sevastianamoroso/proyecto-mano/informe/presentacion/presentacion.tex

% Presentación para la defensa del proyecto final.
% Reusa imágenes y diagramas del informe.
% Compilar (desde informe/presentacion): tectonic -X compile presentacion.tex, o guardar en VS Code
\documentclass[aspectratio=169,10pt]{beamer}

\usepackage[spanish,es-noshorthands,es-nodecimaldot]{babel}
\usepackage{fontspec}
\usepackage{amsmath,amssymb,mathtools}
\usepackage{booktabs}
\usepackage{siunitx}
\sisetup{output-decimal-marker={,}, per-mode=symbol}
\usepackage{tikz}
\usetikzlibrary{positioning, arrows.meta, shapes.geometric, fit, calc, decorations.pathmorphing, backgrounds}
\usepackage{listings}
\usepackage{appendixnumberbeamer}

\graphicspath{{../Imagenes/}}
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
\definecolor{cajaamarilla}{RGB}{88,76,22}
\definecolor{cajaroja}{RGB}{98,36,38}
\definecolor{cajagris}{RGB}{52,58,68}

\setbeamercolor{background canvas}{bg=fondo}
\setbeamercolor{normal text}{fg=texto,bg=fondo}
\setbeamercolor{structure}{fg=celeste}
\setbeamercolor{alerted text}{fg=acento}
\setbeamercolor{frametitle}{fg=texto}
\setbeamercolor{framesection}{fg=tenue}
\setbeamercolor{title}{fg=texto}
\setbeamercolor{subtitle}{fg=acento}
\setbeamercolor{block title}{fg=texto,bg=cajaazul}
\setbeamercolor{block body}{fg=texto,bg=fondoclaro}
\setbeamercolor{block title alerted}{fg=texto,bg=cajanaranja}
\setbeamercolor{block body alerted}{fg=texto,bg=fondoclaro}
\setbeamercolor{description item}{fg=acento}
\setbeamertemplate{blocks}[rounded][shadow=false]
\setbeamerfont{frametitle}{size=\Large,series=\bfseries}
\setbeamerfont{framesection}{size=\footnotesize}
\setbeamertemplate{navigation symbols}{}
\setbeamertemplate{itemize items}[circle]
\setbeamercolor{itemize item}{fg=acento}
\setbeamercolor{itemize subitem}{fg=tenue}
\setbeamercolor{enumerate item}{fg=acento}

% Título a la izquierda, sección a la derecha y una línea de acento debajo
\setbeamertemplate{frametitle}{%
  \vspace*{1.6ex}%
  \hbox to \textwidth{%
    {\usebeamerfont{frametitle}\usebeamercolor[fg]{frametitle}\insertframetitle}\hfill
    {\usebeamerfont{framesection}\usebeamercolor[fg]{framesection}\insertsectionhead}}%
  \nointerlineskip\vskip 0.7ex
  \hbox{{\color{acento}\rule{2.4cm}{1.6pt}}}\vskip 0.3ex}

% Pie: nombre, número de diapositiva y barra de avance
\setbeamertemplate{footline}{%
  \hbox to \paperwidth{\hspace{1em}{\color{tenue}\scriptsize Telerobótica -- UNS DIEC}\hfill
    {\color{tenue}\scriptsize\insertframenumber\,/\,\inserttotalframenumber}\hspace{1em}}%
  \vspace{0.7ex}%
  \hbox{\begin{tikzpicture}
    \fill[fondoclaro] (0,0) rectangle (\paperwidth,2pt);
    \pgfmathsetmacro{\avance}{min(1,\insertframenumber/max(1,\inserttotalframenumber))}
    \fill[acento] (0,0) rectangle ({\avance*\paperwidth},2pt);
  \end{tikzpicture}}}

% Lo que falta completar (en rojo, como en el informe)
\newcommand{\pendiente}[1]{\textcolor{rojo}{\textbf{[PENDIENTE:} #1\textbf{]}}}

\tikzset{
  bloque/.style={draw=tenue, rounded corners, align=center, fill=cajaazul, text=texto,
                 minimum height=1cm, font=\small},
  flecha/.style={-{Stealth[length=2.5mm]}, thick, draw=texto},
  tarjeta/.style={fill=white, rounded corners=4pt, inner sep=3pt},
  carril/.style={draw=tenue!60, rounded corners=6pt, fill=fondoclaro},
  etiqueta/.style={font=\footnotesize, text=tenue, anchor=north west},
  % Íconos de riesgo para la motivación
  radiacion/.pic={
    \fill[yellow!85!orange] (0,0) circle (0.5);
    \fill[black] (0,0) circle (0.08);
    \foreach \a in {90,210,330}
      \fill[black] (\a-30:0.14) arc (\a-30:\a+30:0.14) -- (\a+30:0.42) arc (\a+30:\a-30:0.42) -- cycle;
  },
  peligro/.pic={
    \fill[yellow!85!orange, rounded corners=1.5pt] (90:0.55) -- (210:0.55) -- (330:0.55) -- cycle;
    \node[font=\bfseries\large, text=black] at (0,-0.04) {!};
  },
  termometro/.pic={
    \draw[line width=1.2pt, texto] (-0.09,-0.25) -- (-0.09,0.38) arc (180:0:0.09) -- (0.09,-0.25);
    \fill[rojo] (0,-0.38) circle (0.17);
    \fill[rojo] (-0.045,-0.3) rectangle (0.045,0.28);
    \foreach \y in {-0.05,0.1,0.25} \draw[texto, line width=0.6pt] (0.09,\y) -- (0.2,\y);
  },
}

\lstset{language=C++, basicstyle=\ttfamily\scriptsize\color{texto}, keywordstyle=\color{celeste},
  commentstyle=\color{verde}, backgroundcolor=\color{black!80!fondo}, frame=single,
  rulecolor=\color{tenue!50}, showstringspaces=false, columns=fullflexible,
  morekeywords={uint8_t,uint16_t,int16_t}}

\title{Mano robótica telecomandada\\con sensado de movimientos}
\subtitle{Telerobótica -- Proyecto Final}
\author{Joaquín Petruf \and Sebastián Amoroso}
\institute{Tutores: Rodrigo Martín Santos, Gabriel Eggly\\[0.5ex]
  Ingeniería Electrónica -- DIEC -- Universidad Nacional del Sur}
\date{30 de octubre de 2026}

\begin{document}

%%%%%%%%%%%%%%%%%%%%%%%%%%%%%%%%%%%%%%%%%%%%%%%%%%%%%%%%%%%%%%%%%%%
% Portada: los logos tienen fondo blanco, así que van sobre una franja blanca
\begin{frame}[plain]
  \begin{tikzpicture}[remember picture, overlay]
    \fill[white] (current page.north west) rectangle ([yshift=-2.1cm]current page.north east);
    \fill[acento] ([yshift=-2.1cm]current page.north west) rectangle ([yshift=-2.18cm]current page.north east);
    \node[anchor=west] at ([xshift=1cm, yshift=-1.05cm]current page.north west)
      {};
    \node[anchor=east] at ([xshift=-1cm, yshift=-1.05cm]current page.north east)
      {};
  \end{tikzpicture}
  \vspace{2.1cm}
  \begin{columns}[c]
    \column{0.64\textwidth}
    {\usebeamercolor[fg]{title}\Large\bfseries Mano robótica telecomandada\\con sensado de movimientos\par}
    \vspace{1.2ex}
    {\usebeamercolor[fg]{subtitle}\large\insertsubtitle\par}
    \vspace{3ex}
    {\normalsize Joaquín Petruf \quad Sebastián Amoroso\par}
    \vspace{1ex}
    {\color{tenue}\footnotesize\insertinstitute\par\vspace{1ex}\insertdate\par}
    \column{0.34\textwidth}
    \centering
    \begin{tikzpicture}
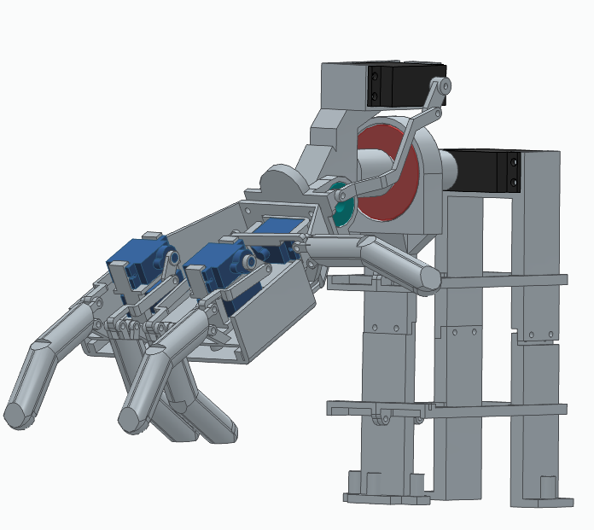
[picture p17: informe/Imagenes/Receptor/Receptor_1.png]
      \node[tarjeta] {};
    \end{tikzpicture}
  \end{columns}
\end{frame}

%%%%%%%%%%%%%%%%%%%%%%%%%%%%%%%%%%%%%%%%%%%%%%%%%%%%%%%%%%%%%%%%%%%
\section{Introducción}

\begin{frame}{Motivación}
  \centering
  \resizebox{0.94\textwidth}{!}{%
  \begin{tikzpicture}[every node/.style={font=\small}]
    % Operador en zona segura
    \node[tarjeta] (guante) at (0,0) {};
    \node[below=1mm of guante, align=center] {\textbf{Operador}\\{\color{tenue}\footnotesize zona segura}};
    % Robot en zona de riesgo
    \node[tarjeta] (mano) at (9.6,0) {};
    \node[below=1mm of mano, align=center] (lmano) {\textbf{Mano robótica}\\{\color{tenue}\footnotesize zona de riesgo}};
    \pic at (12.2,1.05) {radiacion};
    \pic at (12.2,-0.1) {peligro};
    \pic at (12.2,-1.25) {termometro};
    \node[font=\scriptsize, text=tenue, anchor=west] at (12.75,1.05) {radiación};
    \node[font=\scriptsize, text=tenue, anchor=west] at (12.75,-0.1) {tóxicos};
    \node[font=\scriptsize, text=tenue, anchor=west] at (12.75,-1.25) {temperatura};
    \coordinate (zsup) at (12.2,1.6);
    \coordinate (zinf) at (14.1,-1.6);
    \begin{scope}[on background layer]
      \node[draw=rojo, dashed, very thick, rounded corners=8pt, inner sep=6pt,
            fit=(mano)(lmano)(zsup)(zinf)] {};
    \end{scope}
    % Enlace inalámbrico
    \foreach \r in {0.35,0.7,1.05}
      \draw[celeste, very thick] ([xshift=6mm]guante.east) ++(-20:\r) arc (-20:20:\r);
    \foreach \r in {0.35,0.7,1.05}
      \draw[celeste, very thick] ([xshift=-6mm]mano.west) ++(160:\r) arc (160:200:\r);
    \node[align=center, text=celeste] at (4.8,0.15) {\textbf{enlace}\\\textbf{inalámbrico}};
  \end{tikzpicture}}
  \vspace{1.5ex}
  \begin{columns}[T]
    \column{0.52\textwidth}
    \begin{itemize}\small
      \item Tareas donde la presencia humana es un \alert{riesgo inaceptable}: sustancias tóxicas, material radiactivo, temperaturas extremas
      \item \textbf{Telerobótica:} el operador maneja el robot a distancia
    \end{itemize}
    \column{0.44\textwidth}
    \begin{block}{Idea}
      \small Sensar la mano del operador y \textbf{replicar sus movimientos de forma inalámbrica} en una mano impresa en 3D.
    \end{block}
  \end{columns}
\end{frame}

%%%%%%%%%%%%%%%%%%%%%%%%%%%%%%%%%%%%%%%%%%%%%%%%%%%%%%%%%%%%%%%%%%%
\begin{frame}{Objetivo y componentes}
  \textbf{Movimientos que se replican:}
  \begin{itemize}
    \item Apertura y cierre de los \textbf{5 dedos}, en forma individual
    \item \textbf{Rotación} de la muñeca (pronosupinación)
    \item \textbf{Flexión y extensión} de la muñeca
  \end{itemize}
  \vspace{1ex}
  \begin{columns}[T]
    \column{0.45\textwidth}
    \centering\textbf{Guante (transmisor)}\\[1ex]
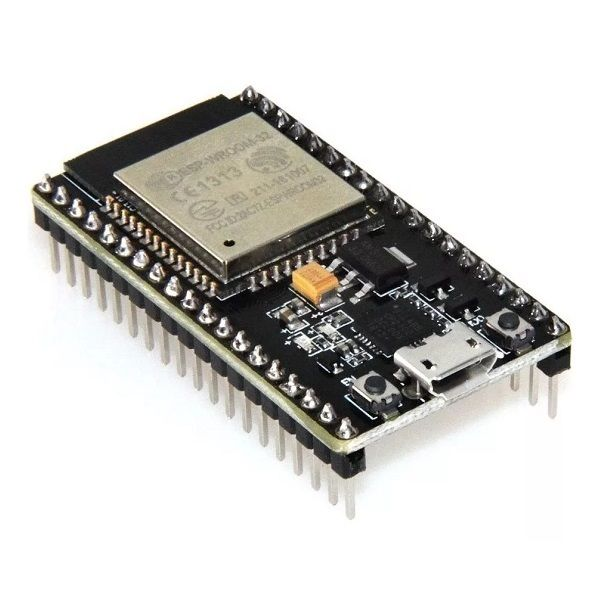
[picture p18: informe/Imagenes/ESP32.jpeg]
    \hspace{1mm}
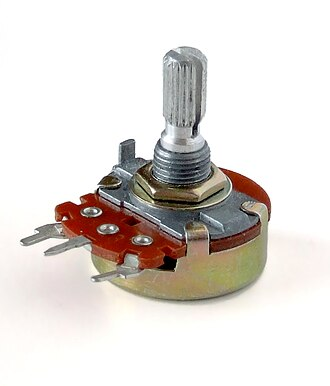
[picture p19: informe/Imagenes/Potenciometro.jpg]
    \hspace{1mm}
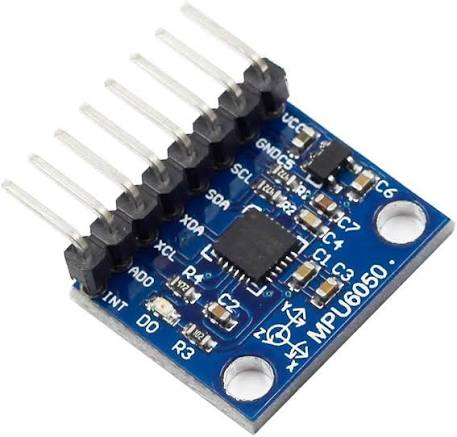
[picture p20: informe/Imagenes/MPU6050.jpg]
    \\
    {\scriptsize ESP32 \quad 5 potenciómetros \quad IMU MPU6050}
    \column{0.45\textwidth}
    \centering\textbf{Mano robótica (receptor)}\\[1ex]
    \hspace{1mm}
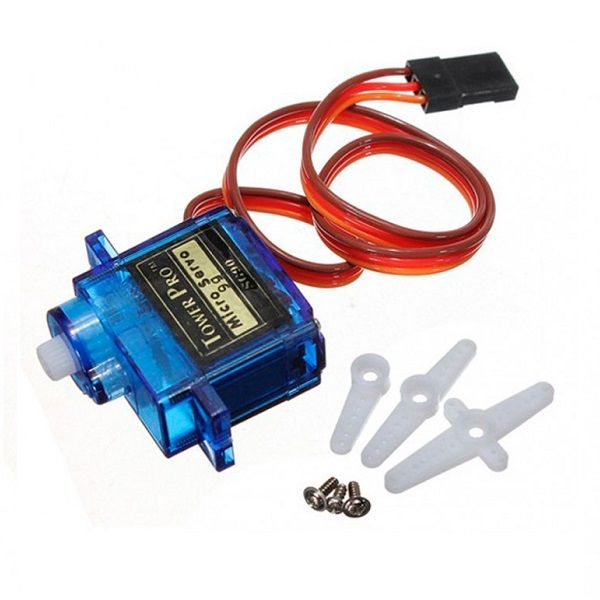
[picture p21: informe/Imagenes/SG90.jpeg]
    \hspace{1mm}
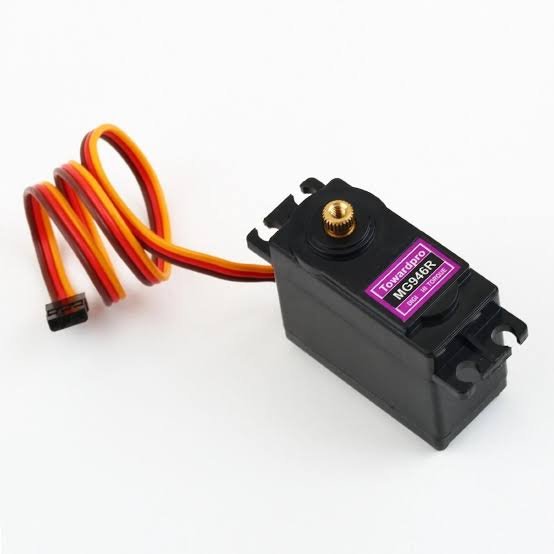
[picture p22: informe/Imagenes/MG946R.jpg]
    \\
    {\scriptsize ESP32 \quad 5 $\times$ SG90 (dedos) \quad 2 $\times$ MG946R (muñeca)}
  \end{columns}
\end{frame}

%%%%%%%%%%%%%%%%%%%%%%%%%%%%%%%%%%%%%%%%%%%%%%%%%%%%%%%%%%%%%%%%%%%
\begin{frame}{Demostración}
  \centering
  \begin{tikzpicture}
    \node[draw=acento, very thick, rounded corners, minimum width=11cm, minimum height=5.2cm,
          fill=fondoclaro, align=center, font=\large] {%
      \textbf{Demo en vivo}};
  \end{tikzpicture}
\end{frame}

%%%%%%%%%%%%%%%%%%%%%%%%%%%%%%%%%%%%%%%%%%%%%%%%%%%%%%%%%%%%%%%%%%%
\section{Hardware}

\begin{frame}{Arquitectura del sistema}
  \centering
  \resizebox{\textwidth}{!}{%
  \begin{tikzpicture}[node distance=0.6cm and 1.2cm]
    \node[bloque] (pot) {5 potenciómetros\\(dedos)};
    \node[bloque, below=of pot] (imu) {MPU6050\\(muñeca)};
    \coordinate (medio) at ($(pot)!0.5!(imu)$);
    \node[bloque, right=1.9cm of medio, fill=cajanaranja, minimum width=3.4cm] (tx)
         {\textbf{ESP32 Transmisor}\\ ADC sobremuestreado\\ Filtro complementario\\ Ángulos de servo\\ Empaquetado + checksum};
    \node[draw=tenue, dashed, rounded corners, inner sep=6pt, fit=(pot)(imu)(tx), label=above:{\textbf{Guante}}] {};
    \node[bloque, right=1.7cm of tx, fill=cajaverde, minimum width=3.4cm] (rx)
         {\textbf{ESP32 Receptor}\\ Validación del paquete\\ Supervisión (failsafe)\\ Limitador de velocidad\\ Banda muerta};
    \node[bloque, right=of rx, yshift=0.8cm] (sg) {5 servos SG90\\(dedos)};
    \node[bloque, right=of rx, yshift=-0.8cm] (mg) {2 servos MG946R\\(muñeca)};
    \node[draw=tenue, dashed, rounded corners, inner sep=6pt, fit=(rx)(sg)(mg), label=above:{\textbf{Mano robótica}}] {};
    \draw[flecha] (pot) -- (tx);
    \draw[flecha] (imu) -- (tx);
    \draw[flecha, very thick, draw=celeste] (tx) -- node[above, font=\footnotesize, align=center, text=celeste]{ESP-NOW\\2,4 GHz} node[below, font=\footnotesize, align=center, text=celeste]{19 bytes\\50 Hz} (rx);
    \draw[flecha] (rx) -- node[above, font=\footnotesize]{PWM} (sg);
    \draw[flecha] (rx) -- node[below, font=\footnotesize]{PWM} (mg);
  \end{tikzpicture}}
  \vspace{2ex}
  \begin{alertblock}{Decisión de diseño}
    El guante \textbf{calcula todo} y envía ángulos de servo; la mano sólo \textbf{valida, suaviza y mueve}.
    Si cambia el operador, se recalibra el guante sin tocar la mano.
  \end{alertblock}
\end{frame}

%%%%%%%%%%%%%%%%%%%%%%%%%%%%%%%%%%%%%%%%%%%%%%%%%%%%%%%%%%%%%%%%%%%
\begin{frame}{Transmisor: el guante}
  \begin{columns}[c]
    \column{0.5\textwidth}
    \centering
    \tikz\node[tarjeta]{};\\
    {\scriptsize Diseño en Solid Edge, impreso en 3D}\\[1ex]
    \hspace{2mm}
    \hspace{2mm}
    \\
    {\scriptsize Dedal \quad Palanca del potenciómetro \quad Resortera}
    \column{0.5\textwidth}
    \textbf{Del dedo al potenciómetro:}
    \begin{enumerate}\small
      \item Una \textbf{tanza} atada al dedal de la punta recorre el dorso del dedo, guiada por dedales en cada falange
      \item En el dorso tira de una \textbf{palanca} montada en el eje del potenciómetro
      \item Sigue por un tubo con \textbf{resorte} hasta la resortera
      \item Al abrir el dedo, el resorte devuelve el eje al reposo y mantiene la tanza tensa (menos holgura)
    \end{enumerate}
    \vspace{1ex}
    \begin{itemize}\small
      \item MPU6050 paralelo al dorso de la mano
      \item ESP32 en la muñeca, alimentado por USB desde la PC (calibración y telemetría)
    \end{itemize}
  \end{columns}
\end{frame}

\begin{frame}{Transmisor: conexionado}
  \centering
  \\[0.5ex]
  \footnotesize Potenciómetros de \SI{10}{\kilo\ohm} entre \SI{3.3}{\volt} y GND, en \textbf{ADC1} (el ADC2 no funciona con la radio activa).
  El filtro RC de la derecha es una mejora posible, no implementada.
\end{frame}

%%%%%%%%%%%%%%%%%%%%%%%%%%%%%%%%%%%%%%%%%%%%%%%%%%%%%%%%%%%%%%%%%%%
\begin{frame}{Receptor: la mano robótica}
  \begin{columns}[c]
    \column{0.3\textwidth}
    \centering\tikz\node[tarjeta]{};
    \column{0.3\textwidth}
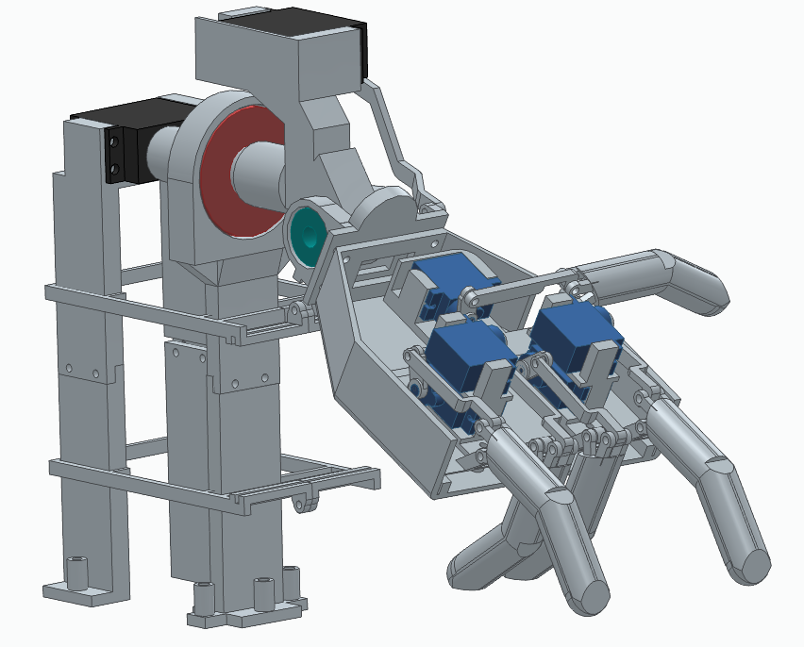
[picture p23: informe/Imagenes/Receptor/Receptor_2.png]
    \centering\tikz\node[tarjeta]{};
    \column{0.4\textwidth}
    \begin{itemize}
      \item 5 SG90 dentro de la palma, cada uno con biela a su dedo
      \item MG946R de rotación sobre rodamiento de \SI{20}{\milli\meter}
      \item MG946R de flexión con biela en el antebrazo
      \item Recorrido mecánico mayor que el de software (\SIrange{25}{90}{\degree}): el servo nunca fuerza el plástico
      \item Impresión: Hellbot Hidra
    \end{itemize}
  \end{columns}
\end{frame}

\begin{frame}{Receptor: conexionado y alimentación}
  \centering
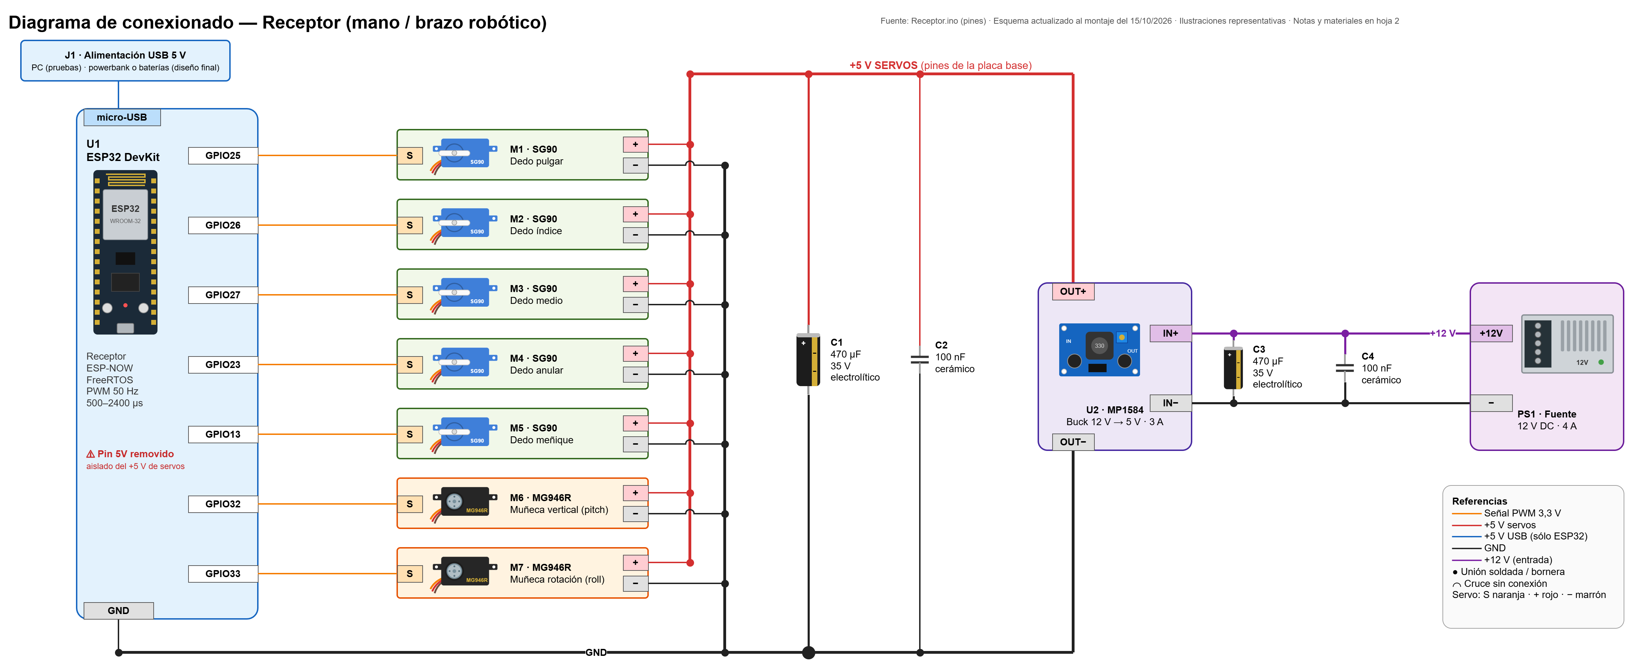
[picture p24: informe/Imagenes/Conexionado_Receptor_Diagrama.png]
  \\[0.5ex]
  \begin{columns}[T]
    \column{0.5\textwidth}
    \begin{itemize}\scriptsize
      \item \textbf{Servos:} fuente \SI{12}{\volt}/\SI{4}{\ampere} $\rightarrow$ \textit{buck} \textbf{MP1584} $\rightarrow$ \SI{5}{\volt}
      \item \textbf{MP1584:} entrada \SIrange{4.5}{28}{\volt}, hasta \SI{3}{\ampere} de salida, conmutación de \SI{100}{\kilo\hertz} a \SI{1.5}{\mega\hertz}
      \item \textbf{ESP32:} por USB, separado de los servos: un pico de los motores no lo reinicia (\textit{brownout})
    \end{itemize}
    \column{0.5\textwidth}
    \begin{itemize}\scriptsize
      \item Pin 5V del ESP32 \textbf{removido}: el regulador no inyecta corriente al USB; masas unidas
      \item \SI{470}{\micro\farad} + \SI{100}{\nano\farad} a la \textbf{entrada} y a la \textbf{salida} del regulador
    \end{itemize}
  \end{columns}
\end{frame}

%%%%%%%%%%%%%%%%%%%%%%%%%%%%%%%%%%%%%%%%%%%%%%%%%%%%%%%%%%%%%%%%%%%
\section{Firmware}

\begin{frame}{Firmware en tiempo real: dos núcleos}
  \begin{columns}[T]
    \column{0.5\textwidth}
    \centering\small
    \begin{tabular}{l c c}
      \toprule
      \textbf{Tarea} & \textbf{Núcleo} & \textbf{Prio.} \\
      \midrule
      \multicolumn{3}{l}{\color{tenue}\scriptsize Transmisor} \\
      \texttt{tareaTransmision} & 1 & 2 \\
      \texttt{loop()} (calibración) & 1 & 1 \\
      Wi-Fi + \texttt{OnDataSent} & 0 & alta \\
      \midrule
      \multicolumn{3}{l}{\color{tenue}\scriptsize Receptor} \\
      \texttt{tareaControlActuadores} & 1 & 3 \\
      Wi-Fi + \texttt{OnDataRecv} & 0 & alta \\
      \bottomrule
    \end{tabular}\\[1ex]
    {\scriptsize La pila Wi-Fi/ESP-NOW corre en el núcleo 0 por defecto (Arduino-ESP32)}
    \column{0.48\textwidth}
    \begin{itemize}\small
      \item \textbf{Núcleo 0:} radio y sus \textit{callbacks}, que sólo validan y copian
      \item \textbf{Núcleo 1:} nuestras tareas, fijadas con \texttt{xTaskCreatePinnedToCore()} $\Rightarrow$ la radio no le agrega \textit{jitter} al ciclo de \SI{20}{\milli\second}
      \item \textbf{Entre núcleos:} cola en el receptor; en el transmisor sólo un \texttt{volatile bool} (ACK)
      \item \texttt{loop()} y \texttt{tareaTransmision} en el mismo núcleo, con más prioridad la tarea $\Rightarrow$ la calibración no necesita semáforo
    \end{itemize}
  \end{columns}
  \vspace{1.5ex}
  \begin{block}{Período fijo con \texttt{vTaskDelayUntil()}}
    \small Despierta en instantes absolutos (0, 20, 40\,ms\ldots): el período no se alarga con el cómputo (\texttt{delay(20)} sí).
    Si un ciclo se atrasa, el siguiente arranca enseguida y la grilla se mantiene.
  \end{block}
\end{frame}

\begin{frame}{Recorrido de un dato, del guante al servo}
  \centering
  \resizebox{\textwidth}{!}{%
  \begin{tikzpicture}[every node/.style={font=\small},
      paso/.style={bloque, minimum width=1.9cm, minimum height=1.05cm, font=\small, inner sep=2pt}]
    % Carriles
    \draw[carril] (0,1.9) rectangle (9.5,4.1);
    \draw[carril] (0,-0.95) rectangle (9.5,0.95);
    \draw[carril] (10.5,1.9) rectangle (20.2,4.1);
    \draw[carril] (10.5,-0.95) rectangle (20.2,0.95);
    \node[etiqueta] at (0.1,4.05) {Núcleo 1 · \texttt{tareaTransmision} (prio 2, cada 20 ms)};
    \node[etiqueta] at (0.1,0.9) {Núcleo 0 · tarea Wi-Fi};
    \node[etiqueta] at (10.6,4.05) {Núcleo 1 · \texttt{tareaControlActuadores} (prio 3)};
    \node[etiqueta] at (15.6,0.9) {Núcleo 0 · tarea Wi-Fi};
    \node[font=\normalsize\bfseries] at (4.75,4.55) {TRANSMISOR (guante)};
    \node[font=\normalsize\bfseries] at (15.35,4.55) {RECEPTOR (mano)};
    % Transmisor
    \node[paso] (imu) at (1.2,2.8) {\textbf{1} IMU +\\filtro};
    \node[paso] (adc) at (3.5,2.8) {\textbf{2} Dedos\\ADC $\times$16};
    \node[paso] (paq) at (5.8,2.8) {\textbf{3} Paquete\\+ checksum};
    \node[paso, fill=cajanaranja] (send) at (8.1,2.8) {\textbf{4} \texttt{esp\_now}\\\texttt{\_send()}};
    \node[paso, fill=cajanaranja] (rtx) at (8.1,-0.15) {\textbf{5} Radio TX};
    \node[paso, fill=cajagris, minimum width=1.6cm] (ack) at (4.9,-0.15) {\texttt{OnDataSent}\\(ACK)};
    \draw[flecha] (imu) -- (adc);
    \draw[flecha] (adc) -- (paq);
    \draw[flecha] (paq) -- (send);
    \draw[flecha] (send) -- node[right, font=\scriptsize, text=tenue]{copia} (rtx);
    \draw[flecha, dashed, draw=tenue] (rtx) -- (ack);
    % Receptor
    \node[paso, fill=cajanaranja] (cb) at (13.3,-0.15) {\textbf{6} \texttt{OnDataRecv}\\valida};
    \node[paso, fill=cajaamarilla, minimum width=1.5cm, minimum height=0.7cm] (cola) at (13.3,1.42) {Cola (1 elem.)};
    \node[paso, fill=cajaverde] (rcv) at (13.3,2.8) {\textbf{7} Despierta\\con el paquete};
    \node[paso, fill=cajaverde] (ctl) at (16.4,2.8) {\textbf{8} Failsafe\\limitador\\banda muerta};
    \node[paso, fill=cajaverde] (pwm) at (18.9,2.8) {\textbf{9} \texttt{write()}\\$\rightarrow$ LEDC};
    \draw[flecha] (cb) -- (cola);
    \draw[flecha] (cola) -- (rcv);
    \node[font=\scriptsize, text=tenue, anchor=west] at ([xshift=2mm]cola.east) {sobrescribe / despierta};
    \draw[flecha] (rcv) -- (ctl);
    \draw[flecha] (ctl) -- (pwm);
    \draw[flecha] (pwm) -- ++(0,-0.95) node[pos=0.5, anchor=west, xshift=1mm, font=\footnotesize]{PWM};
    % Enlace
    \draw[flecha, very thick, draw=celeste, decorate,
          decoration={snake, amplitude=1.2mm, segment length=4mm, post length=3mm}]
         (rtx) -- (cb);
    \node[font=\footnotesize, text=celeste] at (10,-1.3) {ESP-NOW · 19 bytes};
  \end{tikzpicture}}
  \vspace{1.5ex}
  \begin{columns}[T]
    \column{0.5\textwidth}
    \begin{itemize}\scriptsize
      \item \textbf{Dos cambios de núcleo:} en el transmisor de 1 a 0 (la pila Wi-Fi copia el paquete); en el receptor de 0 a 1, a través de la cola
      \item Medición y envío están en la \textbf{misma tarea, en secuencia}: nunca sale un paquete con una medición a medio hacer
    \end{itemize}
    \column{0.48\textwidth}
    \begin{itemize}\scriptsize
      \item El ACK sólo actualiza la telemetría: no frena el flujo
      \item Sin paquetes, la tarea del receptor igual despierta cada \SI{20}{\milli\second} para vigilar el enlace
    \end{itemize}
  \end{columns}
\end{frame}

%%%%%%%%%%%%%%%%%%%%%%%%%%%%%%%%%%%%%%%%%%%%%%%%%%%%%%%%%%%%%%%%%%%
\begin{frame}[fragile]{Protocolo de comunicación}
  \begin{columns}[T]
    \column{0.48\textwidth}
\begin{lstlisting}
#pragma pack(push, 1)
struct MensajeBrazo {
  uint16_t magicHeader;      // 0xAA55
  uint8_t  secuencia;        // 0..255
  uint16_t anguloDedos[5];   // 25..90
  int16_t  muniecaVertical;  // 25..90
  int16_t  muniecaRotacional;// 0..180
  uint16_t checksum;         // Fletcher-16
};
#pragma pack(pop)            // 19 bytes
\end{lstlisting}
    \begin{itemize}\small
      \item ESP-NOW: sin router, por MAC, unicast con ACK
      \item \texttt{pack(1)}: sin \textit{padding}, misma disposición en ambos nodos
    \end{itemize}
    \column{0.5\textwidth}
    \textbf{Se acepta un paquete si:}
    \begin{enumerate}\small
      \item mide 19 bytes
      \item empieza con \texttt{0xAA55}
      \item el checksum coincide
    \end{enumerate}
    \vspace{1ex}
    \textbf{Fletcher-16} sobre los 17 bytes previos:
    \[
      s_1 \leftarrow (s_1 + b_i) \bmod 255, \quad s_2 \leftarrow (s_2 + s_1) \bmod 255
    \]
    \begin{itemize}\small
      \item Detecta errores de 1 bit y bytes intercambiados
      \item Sólo sumas: más simple que un CRC
      \item Segunda barrera sobre el CRC-32 de 802.11 (p.~ej. otro dispositivo ESP-NOW cercano)
    \end{itemize}
  \end{columns}
\end{frame}

%%%%%%%%%%%%%%%%%%%%%%%%%%%%%%%%%%%%%%%%%%%%%%%%%%%%%%%%%%%%%%%%%%%
\begin{frame}{Sensado de los dedos}
  \begin{columns}[T]
    \column{0.48\textwidth}
    \begin{block}{Sobremuestreo}
      Cada lectura promedia 16 conversiones del ADC:
      \[ \sigma_{\bar{x}} = \frac{\sigma}{\sqrt{N}} = \frac{\sigma}{4} \]
      Los 5 dedos en $\approx\SI{5}{\milli\second}$, dentro del ciclo de \SI{20}{\milli\second}.
    \end{block}
    \column{0.48\textwidth}
    \begin{block}{Calibración de dos puntos}
      Mano abierta ($ADC_{\min}$) y puño cerrado ($ADC_{\max}$), guardados en flash (NVS):
      \[ \theta = \operatorname{sat}_{[25,\,90]}\!\left( 25 + 65\,\frac{ADC - ADC_{\min}}{ADC_{\max} - ADC_{\min}} \right) \]
    \end{block}
  \end{columns}
  \vspace{1ex}
  \begin{itemize}
    \item La relación flexión--lectura depende de cada mano, del ajuste del guante, holguras e histéresis $\Rightarrow$ no sirve una relación fija
    \item La saturación protege la mecánica si el operador abre o cierra más que al calibrar
    \item Se calibra con \texttt{c} por consola; durante la calibración \textbf{no se transmite} (v2.3.0)
  \end{itemize}
\end{frame}

%%%%%%%%%%%%%%%%%%%%%%%%%%%%%%%%%%%%%%%%%%%%%%%%%%%%%%%%%%%%%%%%%%%
\begin{frame}{IMU: cómo mide el MPU6050}
  \begin{columns}[T]
    \column{0.5\textwidth}
    \centering
    \\[0.5ex]
    \textbf{Giróscopo MEMS}\\
    {\small Brazos vibrantes: al rotar, la fuerza de Coriolis los deforma $\Rightarrow$ mide \alert{velocidad angular} $\omega$}
    \column{0.5\textwidth}
    \centering
    \\[0.5ex]
    \textbf{Acelerómetro MEMS}\\
    {\small Masa móvil entre peines fijos: la aceleración cambia la capacidad $\Rightarrow$ mide \alert{aceleración}, incluida la gravedad}
  \end{columns}
  \vspace{2ex}
  \centering\small
  \begin{tabular}{l c c c}
    \toprule
    & \textbf{Rango} & \textbf{Sensibilidad} & \textbf{Salida} \\
    \midrule
    Giróscopo & $\pm\SI{500}{\degree\per\second}$ & 65,5 LSB/(°/s) & 3 ejes, 16 bits \\
    Acelerómetro & $\pm2\,g$ & 16384 LSB/$g$ & 3 ejes, 16 bits \\
    \bottomrule
  \end{tabular}\\[0.5ex]
  {\scriptsize I\textsuperscript{2}C a \SI{400}{\kilo\hertz}, 14 bytes por lectura, DLPF en \SI{44}{\hertz} (sensibilidades: hoja de datos de InvenSense)}
\end{frame}

\begin{frame}{IMU: orientación a partir de la gravedad}
  \centering
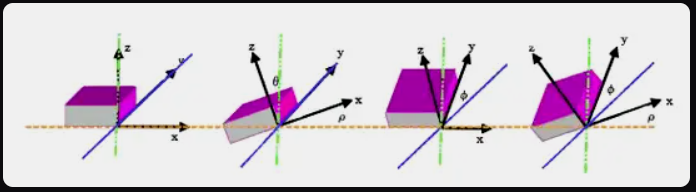
[picture p25: informe/Imagenes/Acelerometro_Esquema.png]
  \\[2ex]
  {\small En reposo, la proyección de $\vec g$ sobre los tres ejes del acelerómetro da la inclinación del sensor}
\end{frame}

\begin{frame}{IMU: qué aporta cada sensor y por qué deriva}
  \begin{columns}[T]
    \column{0.5\textwidth}
    \begin{block}{Giróscopo: rápido, pero deriva}
      \small
      Mide $\omega$; el ángulo sale de integrar, y un error constante (\textit{bias}) $b$ se acumula:
      \[ \theta(t) = \int_0^t \omega\,dt \quad\Rightarrow\quad \theta_{error}(t) = b\,t \]
      Ej.: $b = \SI{0.01}{rad/s} \approx \SI{0.57}{\degree\per\second}$ $\Rightarrow$ \alert{$\approx\SI{34}{\degree}$ en un minuto}\\
      {\scriptsize (orden del \textit{bias} esperado según el plan de pruebas)}
    \end{block}
    \column{0.5\textwidth}
    \begin{block}{Acelerómetro: absoluto, pero ruidoso}
      \small
      En reposo mide sólo la gravedad $\Rightarrow$ inclinación \textbf{sin deriva}:
      \[ \begin{aligned}
        \phi_{acc} &= \operatorname{atan2}(a_y, a_z) \\
        \theta_{acc} &= \operatorname{atan2}\!\left(-a_x, \sqrt{a_y^2 + a_z^2}\right)
      \end{aligned} \]
      Cuando la mano acelera, $\vec a \neq \vec g$: \alert{ruido} en el ángulo
    \end{block}
  \end{columns}
  \vspace{1ex}
  \begin{columns}[c]
    \column{0.4\textwidth}
    \centering
    \column{0.55\textwidth}
    \begin{itemize}\small
      \item Se usan \textit{pitch} (flexión) y \textit{roll} (rotación)
      \item \textit{Yaw}: la gravedad no cambia al girar en torno a la vertical $\Rightarrow$ no se puede medir sin magnetómetro
      \item Al encender, 500 lecturas en reposo dan el \textit{bias} que luego se resta
    \end{itemize}
  \end{columns}
\end{frame}

\begin{frame}{IMU: deriva del giróscopo y ruido del acelerómetro}
  \centering
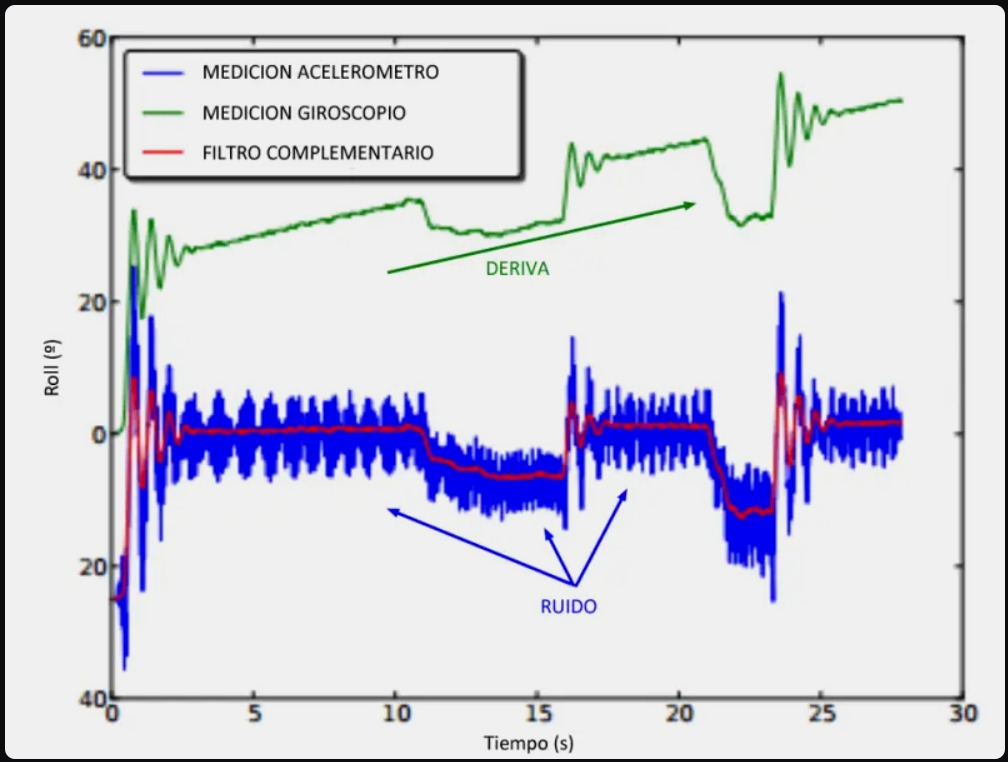
[picture p26: informe/Imagenes/Deriva_Ruido_MPU6050.jpeg]
  \\[0.5ex]
  {\small Giróscopo integrado: \alert{deriva}. Acelerómetro: \alert{ruido} al mover la mano. Fusionados: ángulo estable y rápido}\\
  {\tiny Fuente: L.~Llamas, ``Medir la inclinación con IMU, Arduino y filtro complementario'', \url{https://www.luisllamas.es/medir-la-inclinacion-imu-arduino-filtro-complementario/}}
\end{frame}

\begin{frame}{Muñeca: filtro complementario}
  \[
    \theta_k = \alpha\,\underbrace{\left(\theta_{k-1} + \omega_k\,\Delta t\right)}_{\mathclap{\text{integra el giróscopo}}}
             + (1-\alpha)\,\underbrace{\theta_{acc,k}}_{\mathclap{\text{corrige con el acelerómetro}}},
    \qquad \alpha = 0{,}98,
    \qquad \tau = \frac{\alpha\,\Delta t}{1-\alpha} \approx \SI{1}{\second}
  \]
  \begin{itemize}
    \item Con entradas $\theta_{acc}$ y $\omega\,\Delta t$: los dos canales son pasa-bajos (ganancias 1 y 49)
    \item Respecto del ángulo del giróscopo solo, $\theta_g = \sum \omega\,\Delta t$: \alert{pasa-altos}, y $H_g + H_{acc} = 1$ $\rightarrow$ \emph{complementario}
    \item Más rápido que $\tau$ manda el giróscopo; más lento, el acelerómetro corrige la deriva
    \item \textit{Bias} residual $b$ $\rightarrow$ error fijo $\tau\,b$, no deriva sin límite
    \item Al encender: 500 lecturas en reposo $\rightarrow$ \textit{bias} del giróscopo y ángulo inicial
    \item Si $|\theta| \geq \SI{80}{\degree}$ el \textit{roll} se retiene (singularidad, \textit{gimbal lock})
    \item DLPF interno del MPU6050 en \SI{44}{\hertz} ($\approx\SI{5}{\milli\second}$ de retardo)
  \end{itemize}
\end{frame}

%%%%%%%%%%%%%%%%%%%%%%%%%%%%%%%%%%%%%%%%%%%%%%%%%%%%%%%%%%%%%%%%%%%
\begin{frame}{Receptor: callback, cola y tarea de control}
  \centering
  \resizebox{0.95\textwidth}{!}{%
  \begin{tikzpicture}[node distance=0.6cm and 1.5cm, every node/.style={font=\small}]
    \node[bloque] (radio) {Radio\\ESP-NOW};
    \node[bloque, right=0.8cm of radio, fill=cajanaranja] (cb) {Callback \texttt{OnDataRecv}\\(tarea Wi-Fi, núcleo 0)\\Valida tamaño,\\firma y checksum};
    \node[bloque, right=of cb, fill=cajaamarilla] (cola) {Cola\\(1 elemento)};
    \node[bloque, right=of cola, fill=cajaverde] (ctrl) {Tarea de control\\(núcleo 1)\\Failsafe, trayectoria\\y escritura PWM};
    \node[bloque, right=0.8cm of ctrl] (servos) {7 servos};
    \draw[flecha] (radio) -- (cb);
    \draw[flecha] (cb) -- node[below, font=\footnotesize]{sobrescribe} (cola);
    \draw[flecha] (cola) -- node[below, font=\footnotesize]{despierta} (ctrl);
    \draw[flecha] (ctrl) -- (servos);
  \end{tikzpicture}}
  \vspace{2ex}
  \begin{columns}[T]
    \column{0.5\textwidth}
    \textbf{¿Por qué una cola y no una variable global?}
    \begin{itemize}\small
      \item El callback (núcleo 0) y la tarea (núcleo 1) corren \alert{al mismo tiempo}
      \item Con una global, la tarea podría leer un paquete a medio copiar: dedos nuevos y muñeca vieja
      \item La cola copia los 19 bytes de forma protegida
    \end{itemize}
    \column{0.48\textwidth}
    \textbf{¿Por qué de un solo elemento?}
    \begin{itemize}\small
      \item Sólo importa el \textbf{último} paquete; una cola larga acumularía retardo
      \item \texttt{xQueueOverwriteFromISR}: pisa al anterior y nunca bloquea al callback
      \item La tarea \textbf{despierta al llegar el paquete} (v2.2.0); si no llega, vence a los \SI{20}{\milli\second} e itera igual
    \end{itemize}
  \end{columns}
\end{frame}

\begin{frame}{Receptor: máquina de estados y failsafe}
  \centering
  \resizebox{0.85\textwidth}{!}{%
  \begin{tikzpicture}[node distance=1.6cm and 2.2cm, every node/.style={font=\small},
    estado/.style={draw=tenue, rounded corners=8pt, align=center, minimum width=3cm, minimum height=1.1cm, fill=cajaazul, text=texto}]
    \node[estado] (sync) {\texttt{ESPERANDO\_SYNC}\\Servos en reposo};
    \node[estado, right=of sync, fill=cajaverde] (normal) {\texttt{OPERACION\_NORMAL}\\Sigue al guante};
    \node[estado, below=of normal, fill=cajaroja] (fs) {\texttt{FAILSAFE\_SIN\_SENAL}\\Objetivos en reposo};
    \node[estado, right=of fs, fill=cajagris, dashed] (desac) {Servos desacoplados\\(sin PWM)};
    \draw[flecha] ($(sync.north)+(0,0.7)$) -- node[right, font=\footnotesize]{Inicio} (sync);
    \draw[flecha] (sync) -- node[above, font=\footnotesize]{Paquete válido} (normal);
    \draw[flecha] ($(normal.south)+(0.5,0)$) -- node[right, font=\footnotesize, align=left]{$>\SI{250}{\milli\second}$\\sin paquetes} ($(fs.north)+(0.5,0)$);
    \draw[flecha] ($(fs.north)+(-0.5,0)$) -- node[left, font=\footnotesize]{Paquete válido} ($(normal.south)+(-0.5,0)$);
    \draw[flecha] (fs) -- node[above, font=\footnotesize, align=center]{En reposo y\\$>\SI{2}{\second}$} (desac);
    \draw[flecha] (desac.north) |- node[pos=0.25, right, font=\footnotesize, align=left]{Paquete válido\\(reacopla)} (normal.east);
  \end{tikzpicture}}
  \begin{itemize}\small
    \item \SI{250}{\milli\second} $\approx$ 12 paquetes perdidos: tolera interferencias breves, reacciona rápido ante un corte real
    \item Sin PWM los servos dejan de consumir y de calentarse; al volver arrancan desde la última posición (sin salto)
  \end{itemize}
\end{frame}

%%%%%%%%%%%%%%%%%%%%%%%%%%%%%%%%%%%%%%%%%%%%%%%%%%%%%%%%%%%%%%%%%%%
\begin{frame}{Suavizado: limitador de velocidad y banda muerta}
  \[
    e_i[k] = \theta^{obj}_i - \theta_i[k-1], \qquad
    \theta_i[k] =
    \begin{cases}
      \theta_i[k-1] + \operatorname{sat}_{\pm\Delta\theta_{\max}}\!\left(e_i[k]\right) & |e_i[k]| > \delta \\
      \theta_i[k-1] & |e_i[k]| \leq \delta
    \end{cases}
  \]
  \begin{columns}[T]
    \column{0.5\textwidth}
    \begin{itemize}\small
      \item \textbf{Limitador:} un salto grande (reconexión, failsafe) se vuelve rampa $\Rightarrow$ menos picos de corriente y esfuerzo mecánico
      \item \textbf{Banda muerta:} evita que el servo corrija décimas de grado y zumbe (\textit{hunting})
      \item Límites cercanos a la velocidad del servo: en uso normal casi no agregan retardo
    \end{itemize}
    \column{0.5\textwidth}
    \centering\small
    \begin{tabular}{l c c}
      \toprule
      \textbf{Servo} & \textbf{Vel. máx.} & $\boldsymbol{\delta}$ \\
      \midrule
      Dedos (SG90) & \SI{400}{\degree\per\second} & \SI{1.0}{\degree} \\
      Muñeca vertical & \SI{200}{\degree\per\second} & \SI{1.2}{\degree} \\
      Muñeca rotación & \SI{250}{\degree\per\second} & \SI{1.2}{\degree} \\
      \bottomrule
    \end{tabular}\\
    {\scriptsize Ciclo de \SI{20}{\milli\second}: 8°, 4° y 5° por ciclo}
  \end{columns}
\end{frame}

%%%%%%%%%%%%%%%%%%%%%%%%%%%%%%%%%%%%%%%%%%%%%%%%%%%%%%%%%%%%%%%%%%%
\begin{frame}{Evolución: cada cambio, un problema observado}
  \centering\small
  \begin{tabular}{l p{6.0cm} p{5.4cm}}
    \toprule
    \textbf{Versión} & \textbf{Cambio} & \textbf{Motivo} \\
    \midrule
    Preliminar & EMA en guante y mano, \texttt{delay(20)}, lecturas crudas & Primera versión funcional \\
    1.0.0 & FreeRTOS, cola, checksum, limitador, NVS, \textbf{Kalman} & Retardo y zumbido \\
    2.0.0 & \textbf{Filtro complementario}, \textit{bias} del giróscopo & Muñeca derivaba ``como un mouse'' \\
    2.1.0 & Limitador más rápido, inversión de dedos & Respuesta lenta, dedos invertidos \\
    2.2.0 & Receptor actúa al llegar el paquete, DLPF \SI{44}{\hertz} & Reducir latencia \\
    2.3.0 & Sin transmisión durante la calibración & Mano imitaba la calibración \\
    \bottomrule
  \end{tabular}
  \vspace{1.5ex}
  \begin{itemize}\small
    \item \textbf{v2.3.0: versión definitiva, probada en hardware}
    \item Cada versión es un \textit{tag} de git: cualquiera se puede reproducir y comparar
    \item Doble EMA: los retardos se suman, y los pasos cada vez más chicos caen en la zona muerta del servo $\Rightarrow$ zumbido
  \end{itemize}
\end{frame}

%%%%%%%%%%%%%%%%%%%%%%%%%%%%%%%%%%%%%%%%%%%%%%%%%%%%%%%%%%%%%%%%%%%
\section{Resultados}

\begin{frame}{Latencia}
  \begin{columns}[T]
    \column{0.58\textwidth}
    \textbf{Estimación} (código y hojas de datos)\\[0.5ex]
    \scriptsize
    \begin{tabular}{l c}
      \toprule
      \textbf{Etapa} & \textbf{Retardo} \\
      \midrule
      Espera al ciclo del transmisor & 0--\SI{20}{\milli\second} (media 10) \\
      DLPF del MPU6050 (muñeca) & $\approx\SI{5}{\milli\second}$ \\
      Lectura de dedos y cálculo & $\approx\SI{5}{\milli\second}$ \\
      Transmisión ESP-NOW & 1--\SI{6}{\milli\second} \\
      Tarea de control del receptor & $<\SI{1}{\milli\second}$ \\
      Siguiente pulso PWM & 0--\SI{20}{\milli\second} (media 10) \\
      \midrule
      \textbf{Hasta la orden al servo} & $\boldsymbol{\approx\SI{30}{\milli\second}}$ \textbf{media} \\
      \bottomrule
    \end{tabular}\\[0.5ex]
    \small + movimiento mecánico ($\approx\SI{0.1}{\second}$ cada \SI{60}{\degree} en el SG90)
    \column{0.4\textwidth}
    \textbf{Medición de punta a punta}
    \begin{itemize}\small
      \item El receptor aplica un \textbf{escalón} en el GPIO 34 del Tx (en lugar del pote del índice); el Tx corre su firmware normal
      \item Fin: primer pulso PWM con el ancho nuevo, en la salida real del servo (GPIO 26 $\rightarrow$ GPIO 4)
      \item Un solo reloj, el del receptor: no hay que sincronizar placas
      \item Incluye ambas esperas; no el movimiento mecánico
    \end{itemize}
    \vspace{1ex}
    \textbf{Medido:} \alert{media $\approx\SI{24}{\milli\second}$} ($\approx$420 escalones), coherente con la estimación
  \end{columns}
\end{frame}

%%%%%%%%%%%%%%%%%%%%%%%%%%%%%%%%%%%%%%%%%%%%%%%%%%%%%%%%%%%%%%%%%%%
\begin{frame}{Respuesta del sistema (v2.3.0)}
  \begin{columns}[T]
    \column{0.36\textwidth}
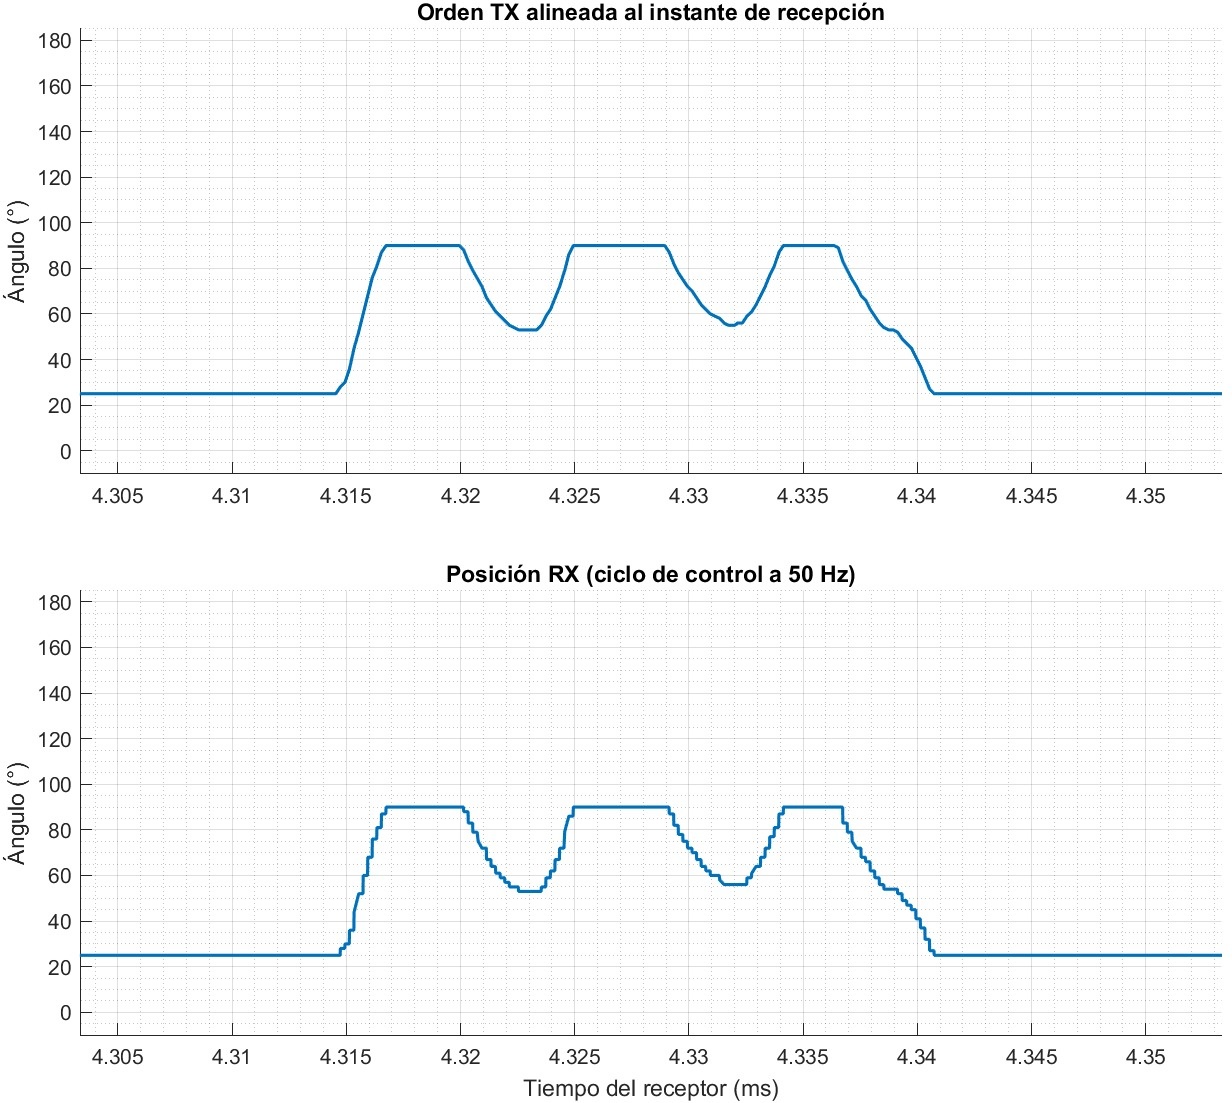
[picture p27: informe/Imagenes/Mediciones/P16_matlab_pulgar.jpg]
    \centering\\{\scriptsize Pulgar}
    \column{0.36\textwidth}
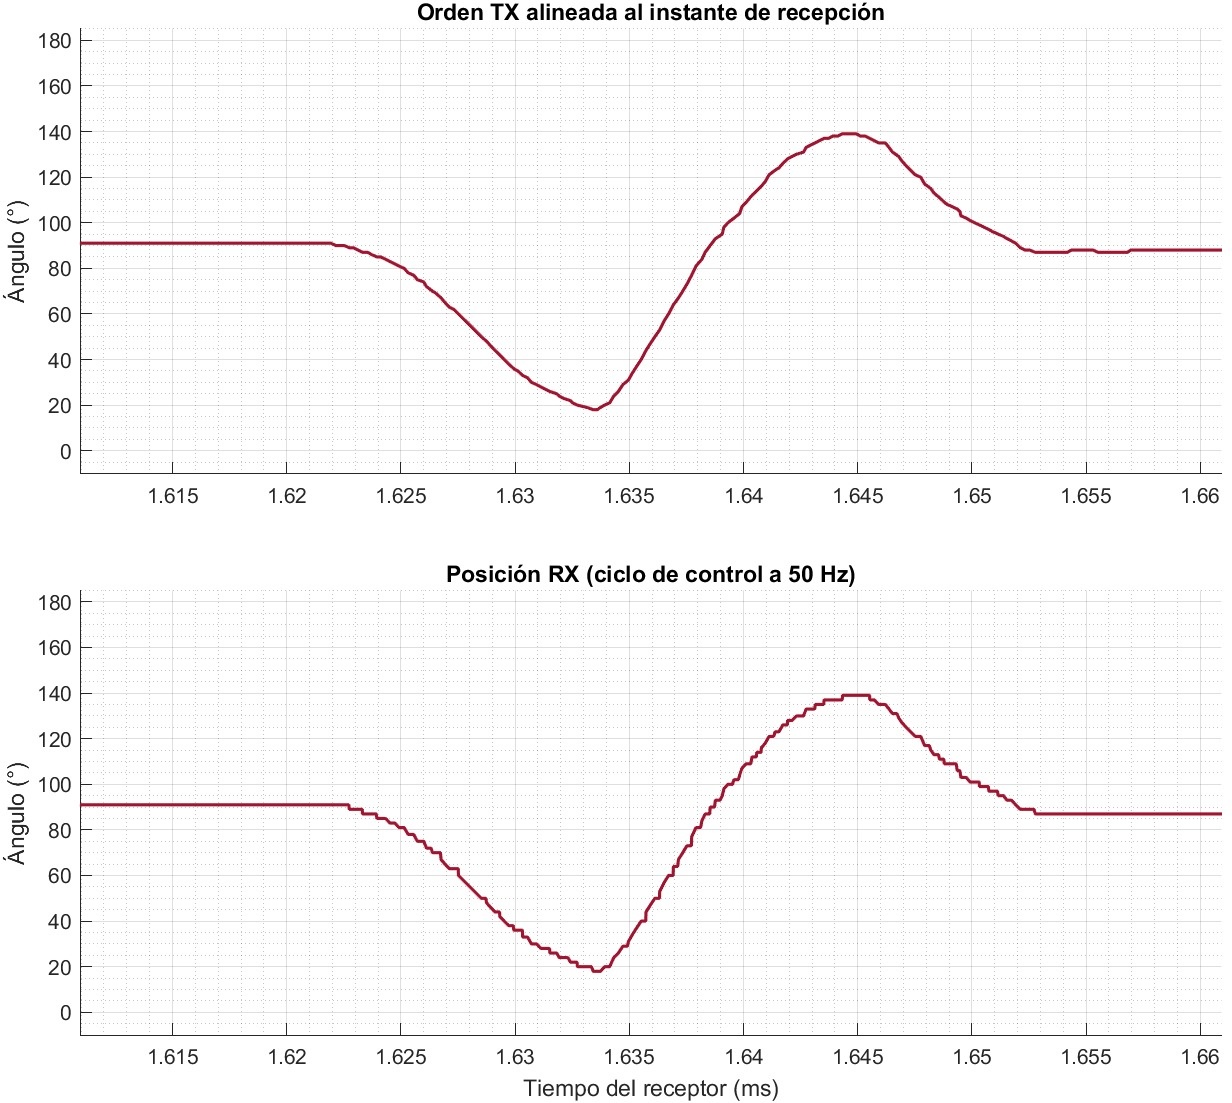
[picture p28: informe/Imagenes/Mediciones/P16_matlab_muneca_rotacional.jpg]
    \centering\\{\scriptsize Muñeca rotacional}
    \column{0.28\textwidth}
    \scriptsize
    Arriba: orden del guante. Abajo: posición aplicada por la mano.\\[1ex]
    \textbf{Alineación por número de secuencia}: telemetría CSV a \SI{50}{\hertz} de ambos nodos, ubicada en el reloj del receptor.\\[1ex]
    El corrimiento muestra el limitador y la banda muerta, \alert{no la latencia del enlace}.\\[1ex]
    {\tiny Eje: \SI{500}{\milli\second}/div (el factor $\times10^5$ de MATLAB quedó fuera de la captura).}
  \end{columns}
  \vspace{1ex}
  \begin{itemize}\small
    \item \textbf{Seguimiento} de la forma completa y de posiciones intermedias (índice en $\approx$\SI{57}{\degree} y \SI{46}{\degree}); sin retraso visible a esta escala
    \item \textbf{Saturación} en \SIrange{25}{90}{\degree}; pasos de la orden menores que el límite del limitador $\Rightarrow$ sigue paquete a paquete
    \item \textbf{Banda muerta:} las variaciones de \SI{1}{\degree} en las mesetas no llegan al servo (error final $\leq$ \SI{1}{\degree})
  \end{itemize}
\end{frame}

\begin{frame}{Consumo del receptor (v2.3.0)}
  \begin{columns}[T]
    \column{0.33\textwidth}
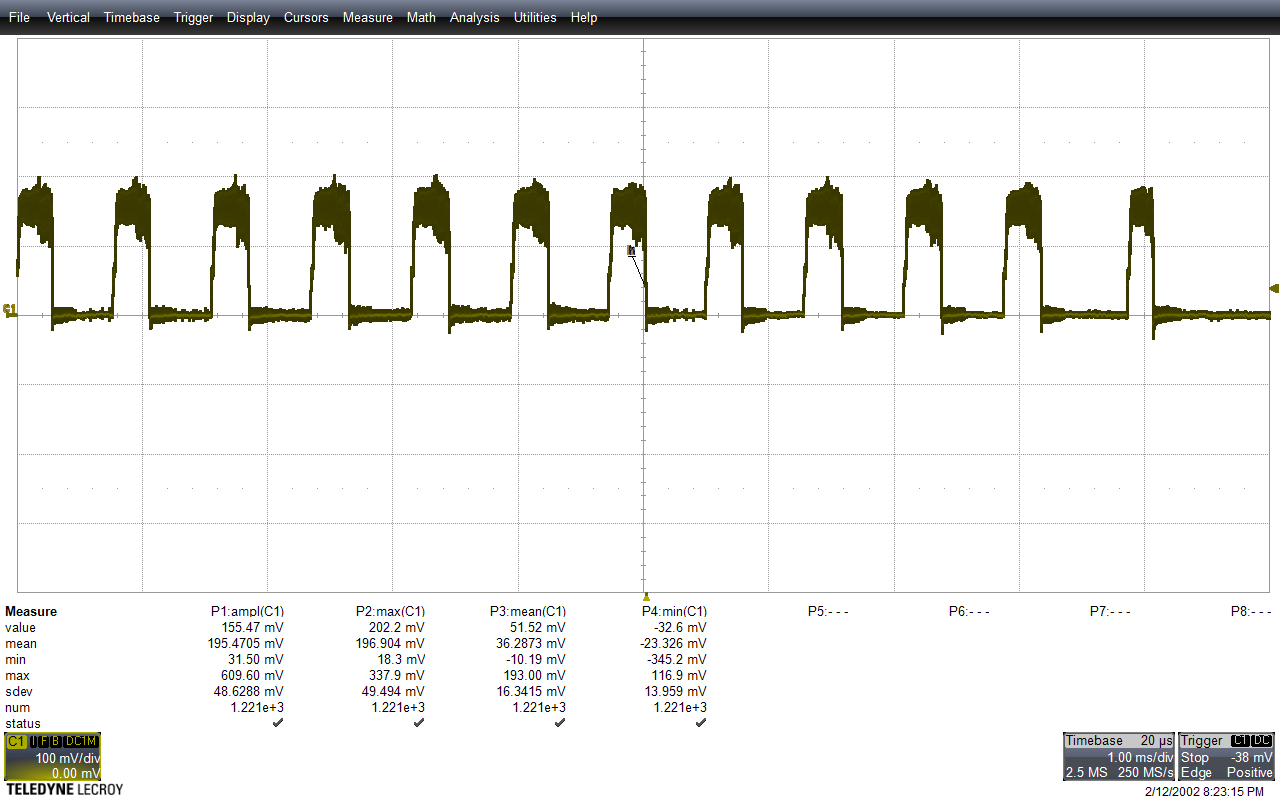
[picture p29: informe/Imagenes/Mediciones/P02_reposo_sin_cap_entrada.png]
    \centering\\{\tiny Reposo, sin capacitor de entrada}
    \column{0.33\textwidth}
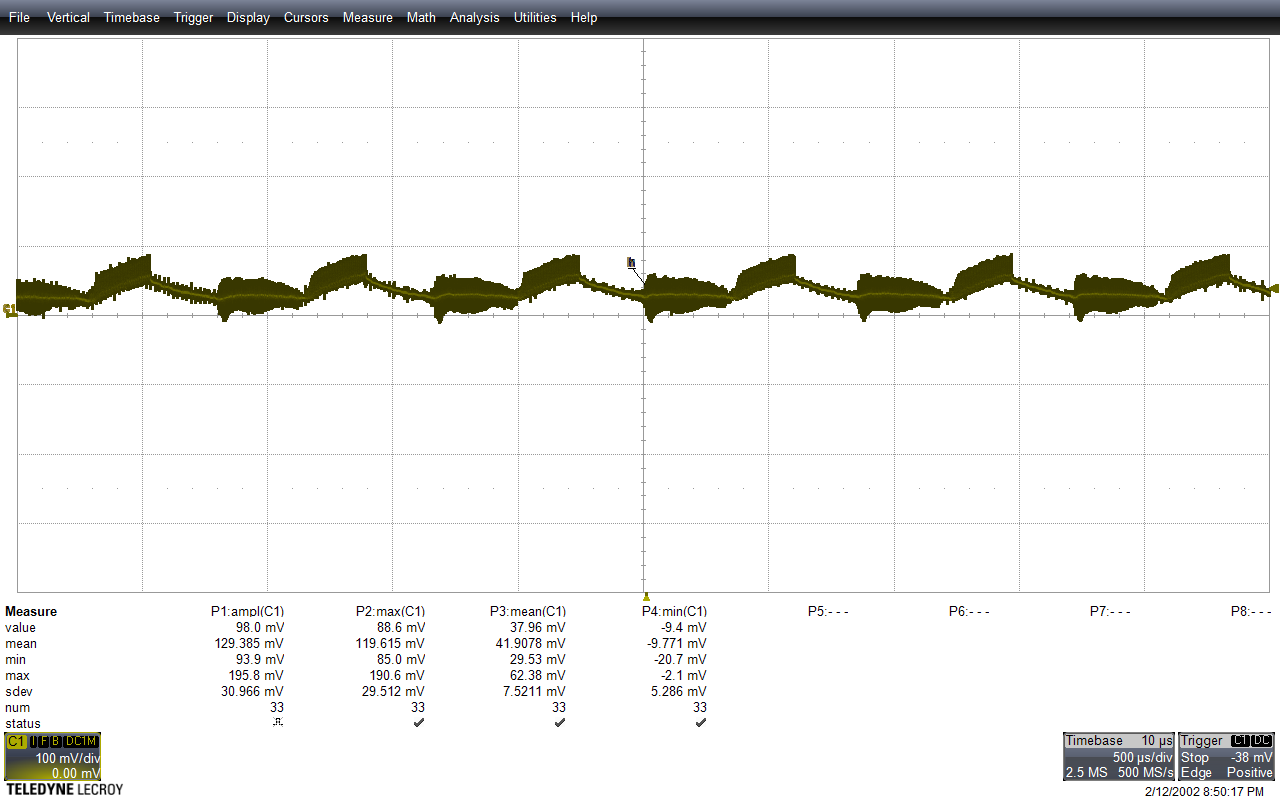
[picture p30: informe/Imagenes/Mediciones/P02_reposo_con_cap_entrada.png]
    \centering\\{\tiny Reposo, con capacitor de entrada}
    \column{0.33\textwidth}
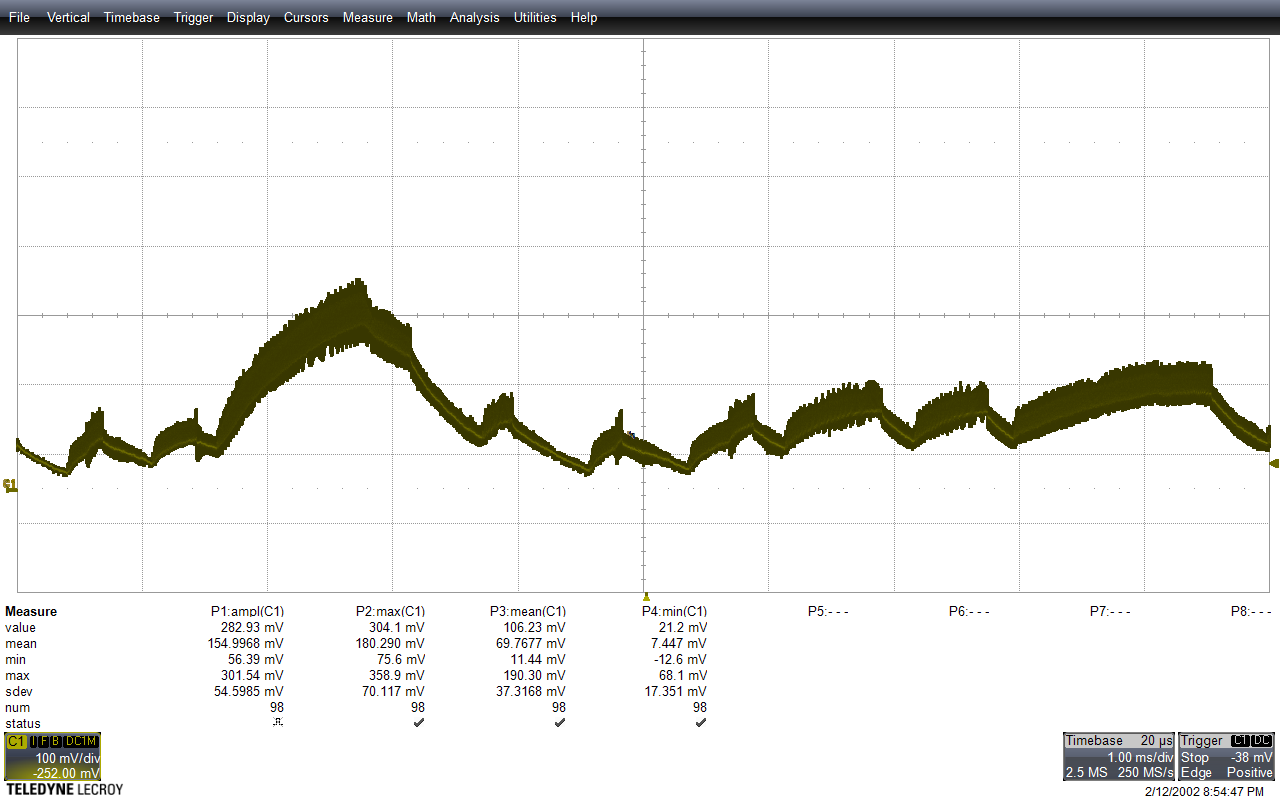
[picture p31: informe/Imagenes/Mediciones/P03_pitch_roll_con_cap.png]
    \centering\\{\tiny \textit{Pitch} y \textit{roll} simultáneos}
  \end{columns}
  \vspace{1ex}
  \begin{columns}[T]
    \column{0.5\textwidth}
    \centering\scriptsize
    \begin{tabular}{l c}
      \toprule
      \textbf{Situación} (a \SI{12}{\volt}) & \textbf{Corriente} \\
      \midrule
      Reposo (media) & \SIrange{75}{100}{\milli\ampere} \\
      Muñeca en 2 ejes (media / picos) & \SI{0.21}{\ampere} / \SIrange{0.6}{0.72}{\ampere} \\
      Servo bloqueado a mano & \SIrange{0.55}{0.6}{\ampere} \\
      \bottomrule
    \end{tabular}
    \column{0.5\textwidth}
    \begin{itemize}\scriptsize
      \item Shunt de \SI{0.5}{\ohm} en el negativo de \SI{12}{\volt}, osciloscopio LeCroy
      \item Pulsos en reposo: \textit{pulse-skipping} del MP1584 (normal)
      \item Capacitor de entrada: pico de \SI{0.38}{\ampere} $\rightarrow$ \SI{0.18}{\ampere}, misma media
      \item Salida de \SI{5}{\volt}: \SIrange{5.14}{5.25}{\volt}, variación imperceptible
      \item Peor caso $<\SI{0.75}{\ampere}$: muy por debajo de \SI{4}{\ampere} (fuente) y \SI{3}{\ampere} (regulador)
    \end{itemize}
  \end{columns}
\end{frame}

\begin{frame}{Resumen de pruebas (v2.3.0)}
  \centering\small
  \begin{tabular}{l l c}
    \toprule
    \textbf{Prueba} & \textbf{Resultado} & \\
    \midrule
    Consumo en reposo y con carga (P02, P03) & \SI{75}{\milli\ampere} a \SI{0.72}{\ampere} a \SI{12}{\volt} & {\color{verde}\checkmark} \\
    Tensión de \SI{5}{\volt} de los servos (P04) & Variación imperceptible & {\color{verde}\checkmark} \\
    Calibración sin transmisión (P09) & La mano va a reposo y se recupera & {\color{verde}\checkmark} \\
    Respuesta del sistema con MATLAB (P16) & Seguimiento en dedos y muñeca & {\color{verde}\checkmark} \\
    \midrule
    Latencia de punta a punta (P11) & Media $\approx\SI{24}{\milli\second}$ & {\color{verde}\checkmark} \\
    Failsafe al apagar el guante (P10) & La mano vuelve al reposo & {\color{verde}\checkmark} \\
    \bottomrule
  \end{tabular}
\end{frame}

%%%%%%%%%%%%%%%%%%%%%%%%%%%%%%%%%%%%%%%%%%%%%%%%%%%%%%%%%%%%%%%%%%%
\section{Cierre}

\begin{frame}{Conclusiones}
  \begin{itemize}
    \item Telerobótica de bajo costo: se replican los 5 dedos y 2 grados de libertad de la muñeca por ESP-NOW; con la v2.3.0 la mano sigue la orden, incluidas las posiciones intermedias
    \item \textbf{Separación de responsabilidades:} el guante calcula, la mano valida, suaviza y mueve
    \item \textbf{Seguridad en el firmware:} checksum, failsafe a \SI{250}{\milli\second}, límites mecánicos, rampa de velocidad
    \item \textbf{Diseño iterativo validado en hardware:} 6 versiones, cada cambio con un motivo observado; el filtrado doble sumaba retardo y un filtro simple y verificable resolvió la deriva
    \item \textbf{Tiempo real:} latencia media de punta a punta $\approx\SI{24}{\milli\second}$, menor que el movimiento del propio servo
    \item \textbf{Alimentación:} consumo medido muy por debajo de la capacidad; ESP32 separado de los servos
    \item Limitaciones: sin realimentación de fuerza, \textit{yaw} no medido (sin magnetómetro), depende de la calibración
  \end{itemize}
\end{frame}

\begin{frame}[plain]
  \centering\vfill
  {\Huge\color{acento}\textbf{¡Gracias!}}\\[3ex]
  {\Large Preguntas}\\[4ex]
  {\color{tenue}\small Joaquín Petruf \quad Sebastián Amoroso}
  \vfill
\end{frame}

%%%%%%%%%%%%%%%%%%%%%%%%%%%%%%%%%%%%%%%%%%%%%%%%%%%%%%%%%%%%%%%%%%%
% RESPALDO: para preguntas del jurado (no se exponen)
\appendix
\section{Respaldo}

\begin{frame}{Respaldo: latencia medida (P11)}
  \centering
  \colorbox{white}{}\\[1ex]
  \small Corrida larga ($\approx$420 escalones): media \SI{23.9}{\milli\second}.
  Corrida con ensayos individuales ($n=28$): \SIrange{22.8}{42.3}{\milli\second}, sin pérdidas.
\end{frame}

\begin{frame}{Respaldo: filtro de Kalman (v1.0.0)}
  Estado: ángulo $\theta$ y \textit{bias} del giróscopo $b$
  \[
    \text{Predicción:}\quad \theta^- = \theta + \Delta t\,(\omega - b), \qquad P^- = F P F^{T} + Q\,\Delta t,
    \qquad F = \begin{pmatrix} 1 & -\Delta t \\ 0 & 1 \end{pmatrix}
  \]
  \[
    \text{Corrección:}\quad K = \frac{1}{P^-_{00} + R}\begin{pmatrix} P^-_{00} \\ P^-_{10} \end{pmatrix}, \qquad
    \begin{pmatrix} \theta \\ b \end{pmatrix} \leftarrow \begin{pmatrix} \theta^- \\ b \end{pmatrix} + K\left(\theta_{acc} - \theta^-\right)
  \]
  \[
    Q_{angle} = 0{,}001, \quad Q_{bias} = 0{,}003, \quad R = 0{,}03
  \]
  \begin{itemize}\small
    \item Tres parámetros sin interpretación directa frente a un único $\alpha$
    \item El problema real eran errores de signo e inicialización, no el filtro
  \end{itemize}
\end{frame}

\begin{frame}{Respaldo: mapeo de la muñeca}
  \textit{Pitch} en dos tramos (rango del operador \SI{+45}{\degree}/\SI{-25}{\degree}, neutro del servo en \SI{57}{\degree}):
  \[
    \theta_{servo,V} =
    \begin{cases}
      57 - \dfrac{p}{45}\,(57 - 25) & p \geq 0 \\[1.5ex]
      57 + \dfrac{p}{-25}\,(90 - 57) & p < 0
    \end{cases}
    \qquad p = \operatorname{sat}_{[-25,\,45]}\left(\theta - \theta_{trim}\right)
  \]
  Rotación lineal, mano plana = servo centrado:
  \[
    \theta_{servo,R} = \operatorname{sat}_{[0,\,180]}\left(\phi - \phi_{trim} + 90\right)
  \]
  \begin{itemize}\small
    \item $\theta_{trim}$, $\phi_{trim}$ compensan la desalineación de montaje del MPU6050
    \item Cálculo en punto flotante, redondeo al grado al empaquetar
  \end{itemize}
\end{frame}

\begin{frame}{Respaldo: índice y muñeca vertical}
  \begin{columns}[T]
    \column{0.5\textwidth}
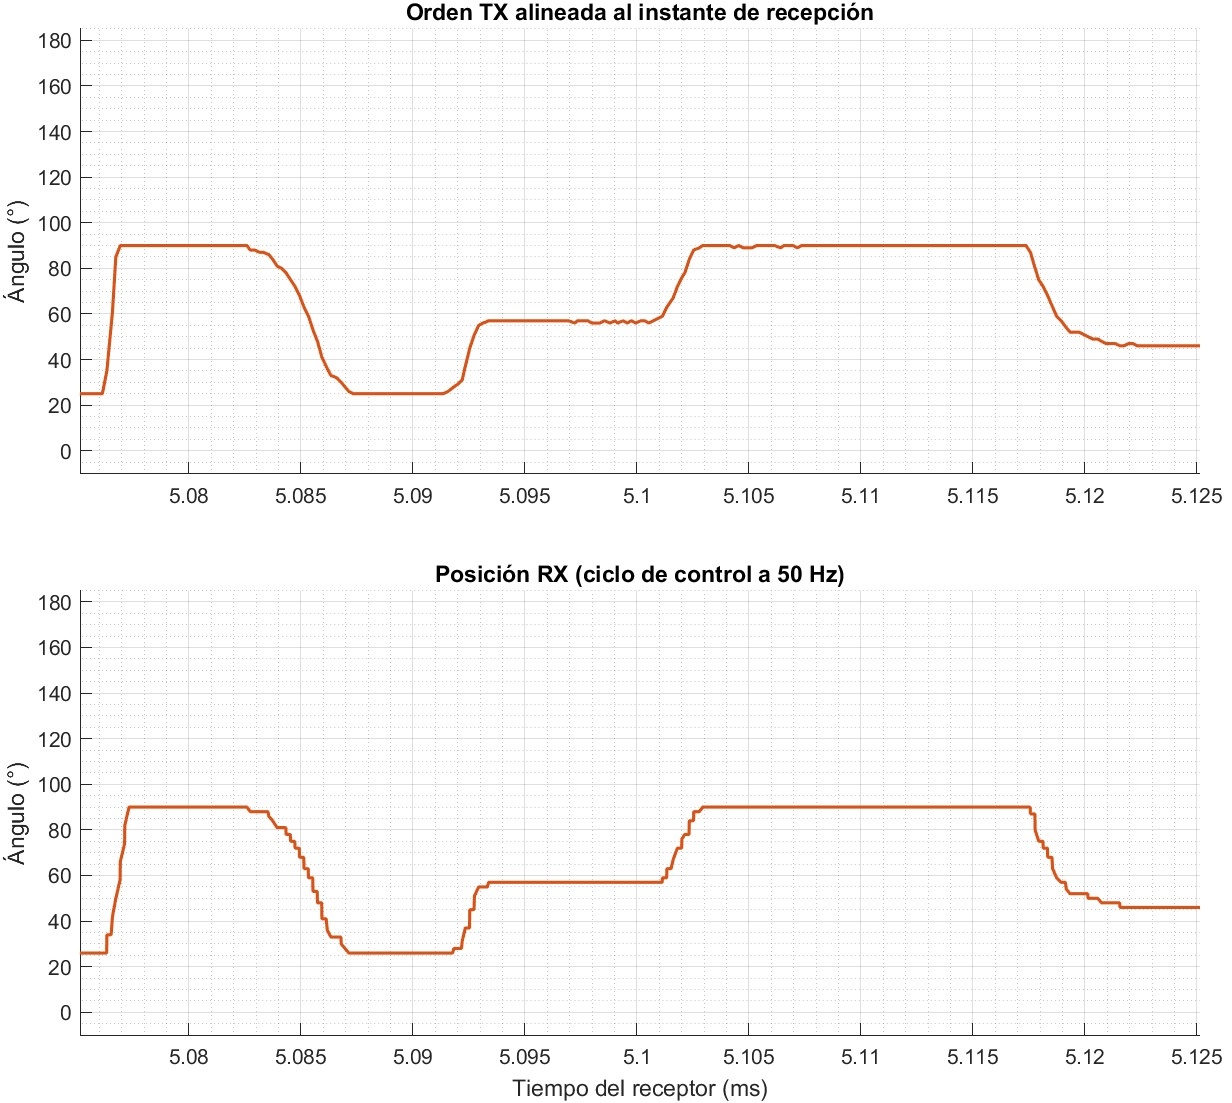
[picture p32: informe/Imagenes/Mediciones/P16_matlab_indice.jpg]
    \centering\\{\scriptsize Índice: flexiones completas y parciales}
    \column{0.5\textwidth}
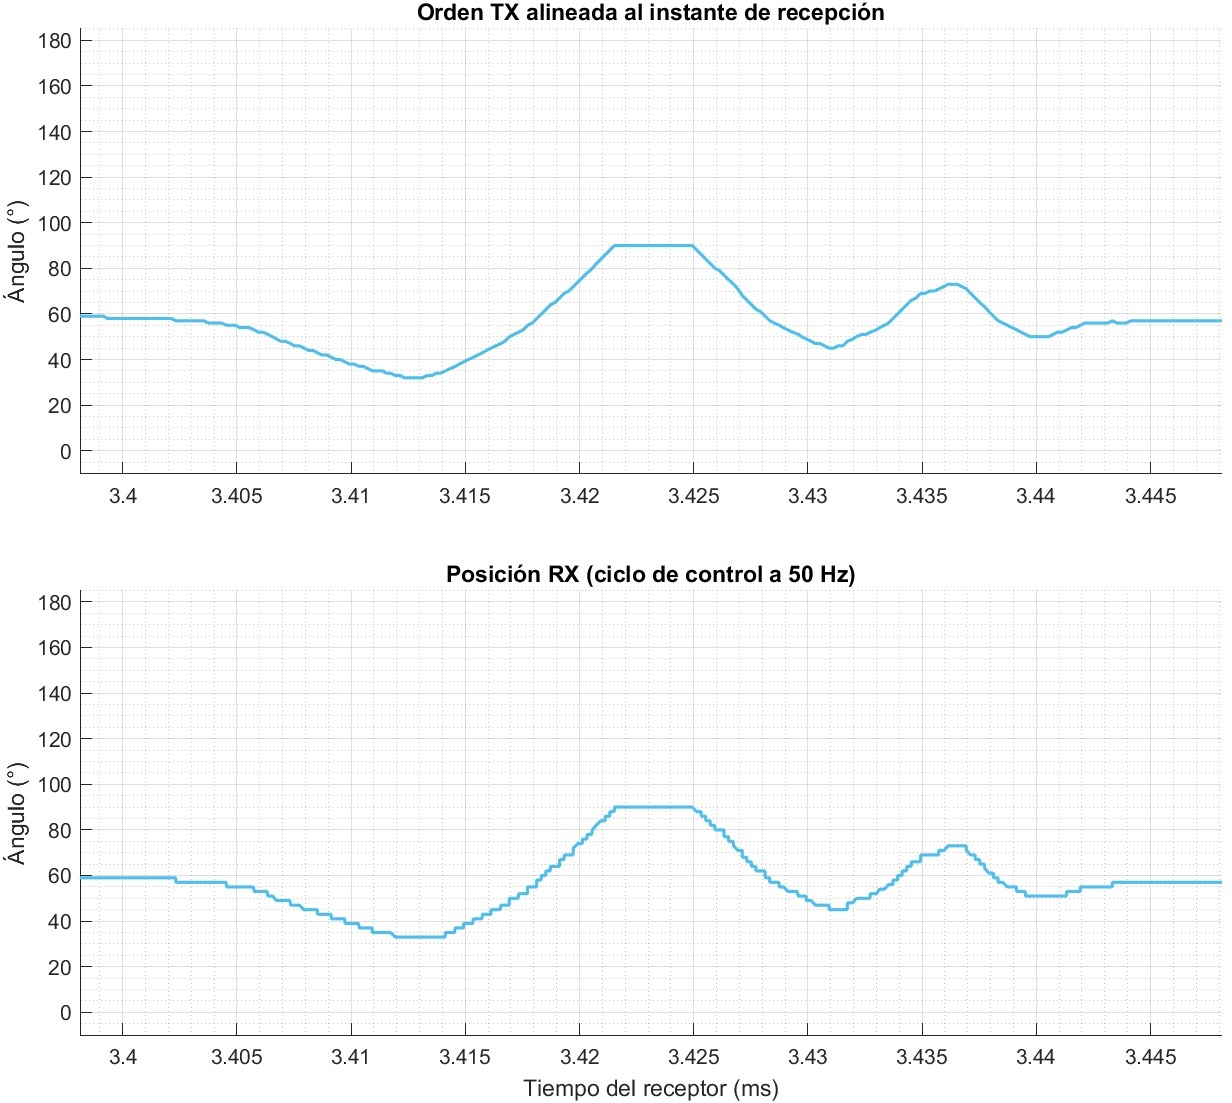
[picture p33: informe/Imagenes/Mediciones/P16_matlab_muneca_vertical.jpg]
    \centering\\{\scriptsize Muñeca vertical: saturación en \SI{90}{\degree}}
  \end{columns}
\end{frame}

\begin{frame}{Respaldo: servo bloqueado y salida de \SI{5}{\volt}}
  \begin{columns}[T]
    \column{0.5\textwidth}
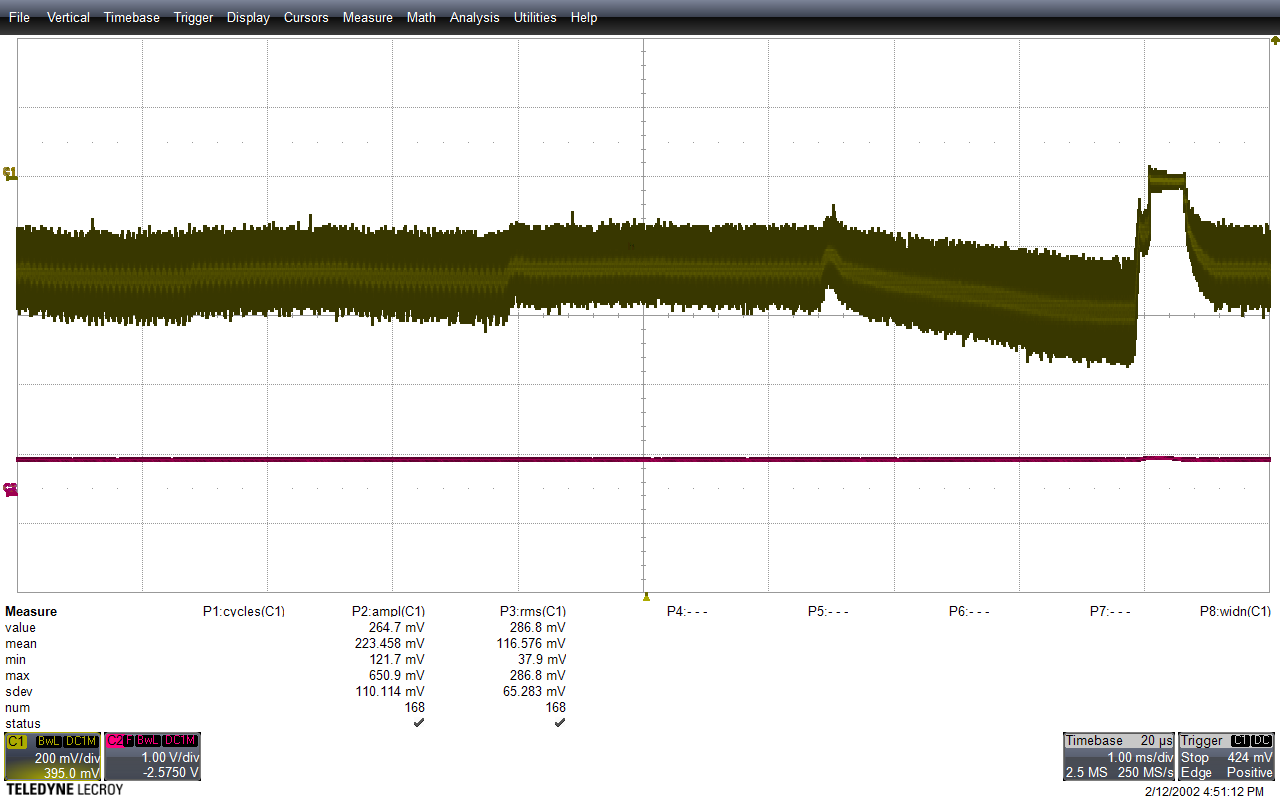
[picture p34: informe/Imagenes/Mediciones/P03_servo_bloqueado.png]
    \centering\\
    {\scriptsize Servo bloqueado a mano: \SIrange{0.55}{0.6}{\ampere} a \SI{12}{\volt}, conmutación continua.
    El corte final es el instante en que se suelta el agarre.}
    \column{0.5\textwidth}
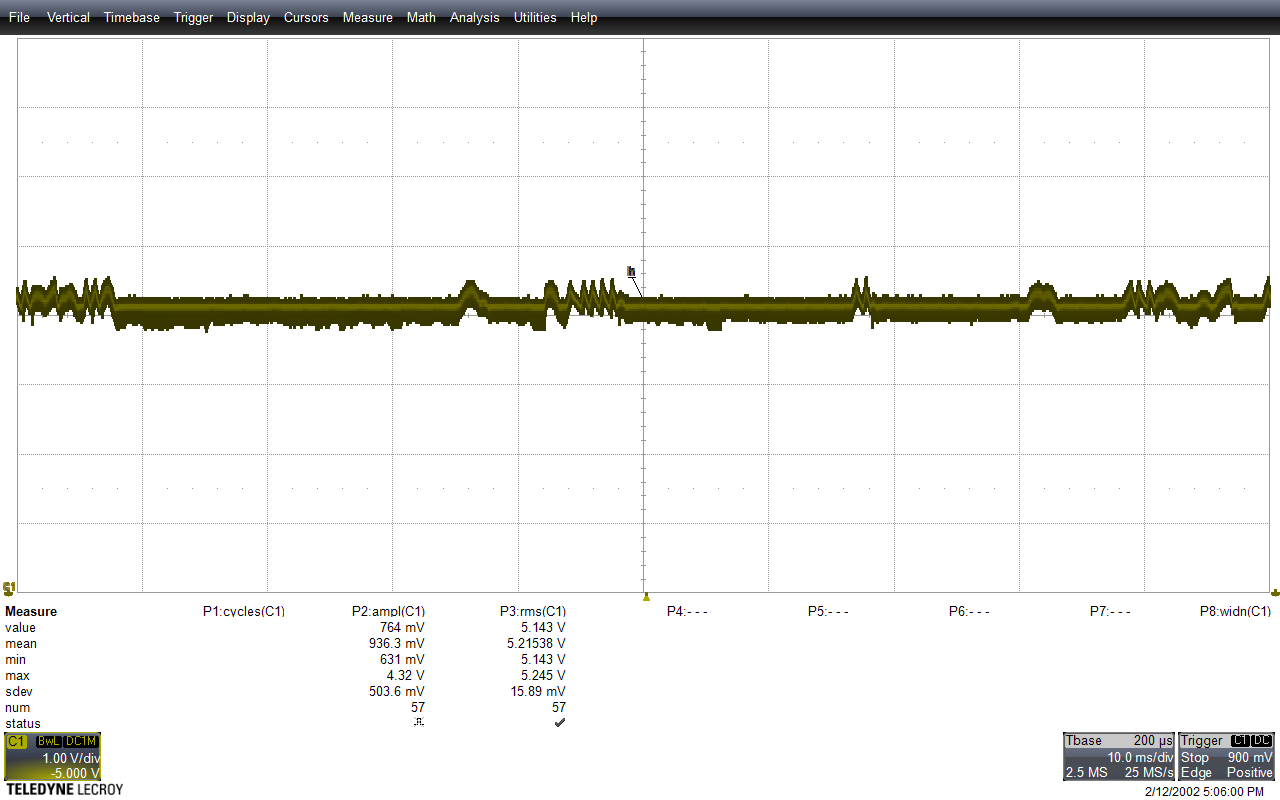
[picture p35: informe/Imagenes/Mediciones/P02_V5_regulador.png]
    \centering\\
    {\scriptsize Salida del regulador: \SIrange{5.14}{5.25}{\volt} (RMS), variación imperceptible.}
  \end{columns}
\end{frame}

\begin{frame}{Respaldo: preguntas probables}
  \small
  \begin{description}
    \item[¿Por qué ESP-NOW?] Sin router ni asociación, paquetes cortos con ACK por MAC, latencia de pocos ms; BLE tiene intervalos de conexión mayores y Wi-Fi con router agrega un salto y dependencia de infraestructura.
    \item[¿Qué pasa si se corta el enlace?] A los \SI{250}{\milli\second} la mano va a reposo en rampa; a los \SI{2}{\second} en reposo se apagan los PWM.
    \item[¿Alcanza la fuente?] Sí: peor caso medido $<\SI{0.75}{\ampere}$ a \SI{12}{\volt} frente a \SI{4}{\ampere}; por hoja de datos, 2 MG946R bloqueados suman \SI{2.4}{\ampere} y se acercan a los \SI{3}{\ampere} del regulador, por eso la rampa de velocidad.
    \item[¿Qué es el corte al final de la captura con servo bloqueado?] El instante en que se soltó el agarre del servo; no es una falla.
    \item[¿Por qué no se mide el \textit{yaw}?] El acelerómetro no lo ve y sólo con el giróscopo deriva; haría falta un magnetómetro.
    \item[¿Otro operador?] Se recalibra el guante (\texttt{c} por consola); la mano no cambia.
    \item[¿Por qué el anular está en el GPIO 23?] Estaba en el GPIO 12 (pin de \textit{strapping}) y se movía con dificultad; el mismo servo en el GPIO 13 o el 23 respondió mucho mejor, así que la falla seguía al pin. Se pasó al 23, que no es de \textit{strapping}.
  \end{description}
\end{frame}

\end{document}
