sevastianamoroso/proyecto-mano/informe/capitulos/09_conclusiones.tex

\section{Conclusiones}
\label{sec:conclusiones}

Se desarrolló un sistema de telerobótica de bajo costo en el que un guante con sensores comanda una mano impresa en 3D por medio de un enlace inalámbrico ESP-NOW. El sistema replica la flexión de los cinco dedos y dos grados de libertad de la muñeca (desplazamiento vertical y rotación), con un firmware sobre FreeRTOS en cada nodo.

Los principales resultados y aprendizajes del proyecto son:

\begin{itemize}
    \item \textbf{Separación de responsabilidades.} El guante concentra la calibración y el cálculo de los ángulos, y la mano sólo valida, suaviza y mueve los servos. Así, cambiar de operador requiere recalibrar únicamente el guante.
    \item \textbf{Seguridad en el firmware.} La verificación por checksum, el modo de seguridad ante la pérdida de paquetes, los límites mecánicos y el limitador de velocidad evitan que un dato erróneo o un corte del enlace dañen la mecánica. Se verificó en hardware que, al apagar el guante, la mano vuelve sola a la posición de reposo. La pausa del envío durante la calibración (versión 2.3.0) se apoya en ese mismo modo de seguridad y también se verificó en hardware.
    \item \textbf{Proceso iterativo validado en hardware.} Las pruebas de la versión preliminar mostraron que el doble filtrado (en el transmisor y en el receptor) introducía un retardo perceptible y que la implementación del filtro de Kalman producía deriva en la muñeca. Su reemplazo por un filtro complementario sobre ángulos absolutos y por un limitador de velocidad en el receptor resolvió ambos problemas con un algoritmo más simple de ajustar.
    \item \textbf{Respuesta del sistema.} Con la versión 2.3.0, la posición de la mano reproduce la orden del guante en los dedos registrados (pulgar e índice) y en los dos ejes de la muñeca, incluidas las posiciones intermedias; la banda muerta descarta las variaciones de \SI{1}{\degree} de la orden, a costa de un error final de hasta \SI{1}{\degree}. La latencia media de punta a punta medida es de unos \SI{24}{\milli\second}, coherente con la estimación y bastante menor que el tiempo de movimiento de los servos: la mano responde en tiempo real, sin un retardo apreciable para el operador.
    \item \textbf{Alimentación.} Las mediciones con la versión 2.3.0 muestran que el receptor consume a \SI{12}{\volt} entre \SIrange{75}{100}{\milli\ampere} en reposo y menos de \SI{0.75}{\ampere} en los picos registrados, muy por debajo de la capacidad de la fuente y del regulador. Separar la alimentación del ESP32 (por USB) de la de los servos evita que un pico de corriente de los motores reinicie el microcontrolador.
\end{itemize}

Como toda primera versión, el sistema tiene limitaciones propias del diseño elegido: no hay realimentación de fuerza al operador, el MPU6050 no tiene magnetómetro y por eso no permite medir el giro sobre el eje vertical (\textit{yaw}), y los dedos requieren una calibración inicial para cada operador.

\subsection{Trabajo futuro}

El alcance de este proyecto fue construir la cadena completa de telecomando (captura del movimiento en el guante, enlace inalámbrico y réplica en la mano) y verificar que funciona en tiempo real y de forma segura. Ese objetivo se cumplió. Los puntos siguientes no formaban parte de ese alcance: no hacen falta para validar el sistema, pero son la continuación natural del trabajo, ya sea por parte de este mismo equipo o de otros estudiantes que tomen el proyecto como punto de partida. Para eso, el código y la documentación completos están disponibles en el repositorio indicado en la sección~\ref{sec:codigo_fuente}.

\paragraph{Caracterización más profunda del sistema actual.}
\begin{itemize}
    \item \textbf{Estadística completa de la latencia} (sección~\ref{sec:latencia}). Para los objetivos de este trabajo alcanzó con el valor medio, que ya muestra que el enlace y el procesamiento son mucho más rápidos que los propios servos. Un estudio específico podría relevar su distribución (máximos y percentiles), su variación con la distancia, los obstáculos y la interferencia, y el camino de la muñeca, que incluye el filtro interno del MPU6050.
    \item \textbf{Comportamiento de la muñeca a largo plazo}: ruido en reposo, deriva durante períodos prolongados y repetibilidad al volver a una misma postura. Es relevante para aplicaciones en las que la mano deba sostener una posición durante mucho tiempo.
\end{itemize}

\paragraph{Mejoras de desempeño.}
\begin{itemize}
    \item \textbf{Mayor frecuencia de trabajo.} Subir la tasa de envío a \SI{100}{\hertz}; como el limitador de velocidad actúa por iteración, en ese caso debería escalarse con el tiempo real entre iteraciones para que la velocidad máxima no se duplique.
    \item \textbf{PWM más rápido en los servos de la muñeca.} Probar \SIrange{100}{200}{\hertz} en los MG946R, para los que el fabricante sólo especifica \SI{50}{\hertz}, vigilando la temperatura y el comportamiento de los servos.
\end{itemize}

\paragraph{Ampliaciones de funcionalidad.}
\begin{itemize}
    \item \textbf{Realimentación de fuerza} al operador, por ejemplo con sensores en los dedos de la mano y actuadores en el guante.
    \item \textbf{Medición del giro en \textit{yaw}} reemplazando el MPU6050 por una unidad inercial con magnetómetro.
    \item \textbf{Calibración guardada por operador} en la memoria no volátil del transmisor, para no repetirla en cada uso.
\end{itemize}
