sevastianamoroso/proyecto-mano/informe/borradores/diagrama_firmware.tex

% Borrador: estructura del firmware en notación de diagrama de clases (UML).
% Documento independiente para revisar antes de incorporarlo al informe.
% Compilar con:  tectonic -X compile diagrama_firmware.tex
\documentclass[11pt,a4paper]{article}
\usepackage[spanish,es-noshorthands,es-tabla]{babel}
\usepackage{fontspec}
\usepackage[margin=2cm]{geometry}
\usepackage{tikz}
\usetikzlibrary{positioning, arrows.meta, shapes.multipart, fit, calc, backgrounds}
\usepackage{booktabs, tabularx, float, caption}
\usepackage{xcolor}
\usepackage{siunitx}
\usepackage[colorlinks=true, linkcolor=blue]{hyperref}

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

\title{Estructura del firmware\\\large Diagrama tipo clases (borrador para el informe)}
\date{}

\begin{document}
\maketitle

\section*{Cómo leer los diagramas}

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

% =====================================================================
\section*{1. Vista general}

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

\begin{table}[H]
\centering
\small
\begin{tabularx}{\textwidth}{l l X}
\toprule
\textbf{Módulo} & \textbf{Programa} & \textbf{Responsabilidad} \\
\midrule
Programa principal & Tx & Configura el hardware, la radio y la tarea; en \texttt{loop()} atiende el comando de calibración. \\
TareaTransmision & Tx & Ciclo de \SI{20}{ms}: lee la IMU y los dedos, calcula los ángulos, arma el paquete y lo envía. \\
EstimadorMuñeca & Tx & Lectura del MPU6050 y filtro complementario para \emph{pitch} y \emph{roll}. \\
LecturaDedos & Tx & Lectura de los potenciómetros con sobremuestreo y calibración de dos puntos guardada en memoria no volátil. \\
EnlaceTx & Tx & Envío por ESP-NOW y registro del resultado del último envío. \\
MensajeBrazo & ambos & Formato del paquete, cálculo y validación del \emph{checksum}. \\
OnDataRecv & Rx & Descarta paquetes inválidos y deja el válido en la cola. \\
TareaControlActuadores & Rx & Máquina de estados, \emph{failsafe}, limitador de velocidad y banda muerta. \\
Actuadores & Rx & Manejo de los siete servos: acople, desacople e inversión de sentido. \\
\bottomrule
\end{tabularx}
\caption{Responsabilidad de cada módulo.}
\end{table}

% =====================================================================
\newpage
\section*{2. Transmisor}

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

\begin{figure}[H]
\centering
\resizebox{\textwidth}{!}{%
\begin{tikzpicture}
  \clase[clase=ctx]{main}{programa principal}{Transmisor.ino}
    {—}
    {setup()\\loop() \textrm{: comando} 'c'}
  \clase[clase=crtos, at={(6.4,0)}]{task}{tarea · núcleo 1 · prioridad 2}{TareaTransmision}
    {PERIODO\_CONTROL\_MS = 20\\
     xLastWakeTime : TickType\_t\\
     ticksTelemetria : uint32\_t\\
     paqueteSalida : MensajeBrazo\\
     contadorSecuencia : uint8\_t}
    {tareaTransmision()\\
     \textrm{\itshape ciclo: IMU → filtro → mapeo → dedos}\\
     \textrm{\itshape → paquete → envío → telemetría (5 Hz)}}
  \clase[clase=cshared, at={(12.8,0)}]{msg}{struct · ProtocoloBrazo.h · 19 bytes}{MensajeBrazo}
    {magicHeader : uint16\_t = 0xAA55\\
     secuencia : uint8\_t\\
     anguloDedos[5] : uint16\_t\\
     muniecaVertical : int16\_t\\
     muniecaRotacional : int16\_t\\
     checksum : uint16\_t}
    {calcularChecksumBrazo(msg) : uint16\_t\\
     validarPaqueteBrazo(msg) : bool}

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

% =====================================================================
\section*{3. Receptor}

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

\section*{Notas}
\begin{itemize}
  \item \textbf{Archivo sin uso:} \texttt{Transmisor/KalmanFilter.h} quedó de la versión 1.0.0 y ya no se incluye en el firmware. Puede borrarse o mencionarse sólo en la sección de evolución.
  \item \textbf{Bibliotecas externas:} \texttt{Adafruit\_MPU6050} (IMU), \texttt{Preferences} (memoria no volátil), \texttt{ESP32Servo} (PWM de los servos), \texttt{esp\_now} y \texttt{WiFi} (radio) y FreeRTOS (tareas y colas), incluida en el núcleo de Arduino para ESP32. No se dibujan para no recargar los diagramas.
\end{itemize}

\end{document}
