sevastianamoroso/proyecto-mano/informe/referencia/main_original.tex

\documentclass[10pt]{article}  

%%%%%%%% PREÁMBULO %%%%%%%%%%%%
\title{Plantilla para reportes MSNIE - DIEC - UNS}
%\usepackage[spanish]{babel} %Indica que escribiermos en español
\usepackage[utf8]{inputenc} %Indica qué codificación se está usando ISO-8859-1(latin1)  o utf8  
\usepackage{amsmath} % Comandos extras para matemáticas (cajas para ecuaciones, % etc)
\usepackage{amssymb} % Simbolos matematicos (por lo tanto)
\usepackage{graphicx} % Incluir imágenes en LaTeX
\usepackage{multirow} % Incluir tablas en LateX
\usepackage{color} % Para colorear texto
\usepackage{subfigure} % subfiguras
\usepackage{float} %Podemos usar el especificador [H] en las figuras para que se queden donde queramos
\usepackage{capt-of} % Permite usar etiquetas fuera de elementos flotantes
% (etiquetas de figuras)
\usepackage{sidecap} % Para poner el texto de las imágenes al lado
	\sidecaptionvpos{figure}{c} % Para que el texto se alinie al centro vertical
\usepackage{caption} % Para poder quitar numeracion de figuras
\usepackage{commath} % funcionalidades extras para diferenciales, integrales,
% etc (\od, \dif, etc)
\usepackage{cancel} % para cancelar expresiones (\cancelto{0}{x})
\usepackage{anysize} % Para personalizar el ancho de  los márgenes
\marginsize{2cm}{2cm}{2cm}{2cm} % Izquierda, derecha, arriba, abajo
\usepackage{gensymb}
\usepackage{listings} %Paquete para incluir código C, u otros
\usepackage{tikz}
\usetikzlibrary{positioning, arrows.meta}
\usepackage{appendix}
\renewcommand{\appendixname}{Apéndices}
\renewcommand{\appendixtocname}{Apéndices}
\renewcommand{\appendixpagename}{Apéndices} 

% Para que las referencias sean hipervínculos a las figuras o ecuaciones y  aparezcan en color
\usepackage[colorlinks=true,plainpages=true,citecolor=blue,linkcolor=blue]{hyperref}
%\usepackage{hyperref} 
% Para agregar encabezado y pie de página
\usepackage{fancyhdr} 
\pagestyle{fancy}
\fancyhf{}
\fancyhead[L]{\footnotesize UNS} %encabezado izquierda
\fancyhead[R]{\footnotesize DIEC}   % dereecha
\fancyfoot[R]{\footnotesize Reporte}  % Pie derecha
\fancyfoot[C]{\thepage}  % centro
\fancyfoot[L]{\footnotesize Ingeniería Electricista y Electrónica}  %izquierda
\renewcommand{\footrulewidth}{0.4pt}
%%%%%%%%%%%%%%%%%%%%%%%%%%%%%%%%%%%
\usepackage{amsmath} % for \dfrac
\usepackage{physics,siunitx}
%\usepackage{tikz,pgfplots}
%\usepackage[siunitx]{circuitikz} %[symbols]
%\usepackage[outline]{contour} % glow around text
%\usetikzlibrary{arrows,arrows.meta}
%\usetikzlibrary{decorations.markings}
%\tikzset{>=latex} % for LaTeX arrow head
\usepackage{xcolor}
\colorlet{Icol}{blue!50!black}
\colorlet{Ccol}{orange!90!black}
\colorlet{Rcol}{green!50!black}
\colorlet{Lcol}{violet!90}
\colorlet{loopcol}{red!90!black!25}
\colorlet{pluscol}{red!60!black}
\colorlet{minuscol}{blue!60!black}
\newcommand\EMF{\mathcal{E}} %\varepsilon}

%%%%%%%%%%%%%%%%%%%%%%%%%%%%%%%%%%%%%%
\usepackage{listings} % Para usar código fuente
\definecolor{dkgreen}{rgb}{0,0.6,0} % Definimos colores para usar en el código
\definecolor{gray}{rgb}{0.5,0.5,0.5} 
% configuración para el lenguaje que queramos utilizar
\lstset{language=Matlab,
   keywords={break,case,catch,continue,else,elseif,end,for,function,
      global,if,otherwise,persistent,return,switch,try,while},
   basicstyle=\ttfamily,
   keywordstyle=\color{blue},
   commentstyle=\color{red},
   stringstyle=\color{dkgreen},
   numbers=left,
   numberstyle=\tiny\color{gray},
   stepnumber=1,
   numbersep=10pt,
   backgroundcolor=\color{white},
   tabsize=4,
   showspaces=false,
   showstringspaces=false}

\newcommand{\sen}{\operatorname{\sen}}	% Definimos el comando \sen para el seno en español

\title{Plantilla para Reportes MSNIE}
% Basada en la plantilla para reportes UPIITA de  Overleaf

%%%%%%%% TERMINA PREÁMBULO %%%%%%%%%%%%

\begin{document}

%%%%%%%%%%%%%%%%%%%%%%%%%%%PORTADA%%%%%%%%%%%%%%%%%%%%%%%%%%%%%%%%%%

\begin{center}												%%%
\newcommand{\HRule}{\rule{\linewidth}{0.5mm}}									%%%\left%%%
\begin{minipage}{0.48\textwidth} \begin{flushleft}

\end{flushleft}\end{minipage}
\vspace*{2cm}
\begin{minipage}{0.48\textwidth} \begin{flushright}

\end{flushright}\end{minipage}
\vspace*{2cm}								
%%
\textsc{\huge Universidad Nacional del Sur}\\[1cm]	
%%
\textsc{\LARGE Ingeniería  \\ \vspace{5px} Electrónica }\\[1.5cm]		
 			\vspace*{0.5cm}										
%%    
\HRule \\[0.4cm]														%%%
{ \huge \bfseries Movilidad de mano impresa en 3D en base al sensado de los movimientos (Telerobótica)}\\[0.4cm]	%%%
%%%
\HRule \\[1.5cm]												
%
\begin{minipage}{0.46\textwidth}											
\begin{flushleft} \large													
%%%%%%%%%%%%%%%%%%%%%%%%%%%%%%%%%%%%%%%%%%
% Aqui a continuación poner los nombres de los integrantes
\emph{\textbf{Autores:}}\\	
\text{Joaquín Petruf} \\
\text{Sebastian Amoroso}

%%%
\end{flushleft}																
\end{minipage}		
\begin{minipage}{0.52\textwidth}		
\vspace{-0.6cm}											
\begin{flushright} \large													%%%%%%%%%%%%%%%%%%%%%%%%%%%%%%%%%%%%%%%%%
\emph{\textbf{Tutores:}} \\													
Rodrigo Martin Santos  \\
Gabriel Eggly
\end{flushright}															%%%
\end{minipage}	

\vspace*{1cm}

\textbf{\Large Proyecto Final}\\

\vspace{2cm} 																				
\begin{center}	
Bahía Blanca, Buenos Aires \\
{\large \today}														
\end{center}												  		
\end{center}	
\newpage																		
%%%%%%%%%%%%%%%%%%%% FIN PORTADA %%%%%%%%%%%%%%%%%%%%%%%%%%%%%%%%
\tableofcontents 
\newpage
%%%%%%%%%%%%%%%%%%%%%%%%%%%%%%%%%%%%%%%%%

\section{Motivación}

Vivimos en una era donde la tecnología esta presente en casi todos los ámbitos de nuestra vida, siendo de utilidad tanto para actividades cotidianas como para tareas que presenten dificultades dada la posibilidad de atentar contra nuestra salud o por limitaciones físicas, entre otras. Gracias a los avances que se han logrado y se siguen logrando, es posible dar soluciones que permitan y faciliten la realización de dichas tareas, sin importar el obstáculo que presente, se obtienen sistemas compactos y sencillos de utilizar.

Un ejemplo claro y directo de esta necesidad es la manipulación de materiales peligrosos. En escenarios que involucran sustancias tóxicas, reactivos químicos volátiles, material radiactivo o entornos con temperaturas extremas, la presencia humana es un riesgo inaceptable. Es una de muchas situaciones en la que es requerida la ayuda de la tecnología, y en especifico el sector al que apunta este proyecto, el de la  Telerobótica, replicando los movimientos de una mano humana en una impresa en 3D. Nuestra motivación principal es demostrar cómo la réplica exacta del movimiento humano en una máquina a distancia puede ofrecer soluciones vitales en situaciones que presentan un alto riesgo o dificultad para las personas.

\section{Solución}

La Telerobótica es el área de la robótica concerniente al control de robots a distancia, mediante conexiones inalámbricas, como WIFI, Bluetooth, etc. La idea es que un operador humano maneje dispositivo mecánico o autónomo situado en un lugar diferente, a veces peligroso o de difícil acceso. Se usan consolas de control que replican los movimientos de forma precisa y devuelven información visual o táctil.

La base de este proyecto es censar los movimientos de una mano humana y poder replicarlo, de forma inalámbrica, en una mano impresa en 3D. Los tipos de movimientos que se replicaran son:

\begin{itemize}
    \item Apertura y cierre de los dedos, de forma individual.
    \item Rotación de muñeca.
    \item Desplazamiento vertical de la mano.
\end{itemize}

Para esto se hará uso del microcontrolador ESP NodeMCU-32S, 5 servos SG90 y 2 servos MG946R, potenciómetros y el modulo MPU6050.

El micro ESP32 presenta la flexibilidad de poder realizar una comunicación inalámbrica, mediante WiFi, logrando hasta una distancia de 200 metros en espacio libre. Se utilizaran los servos SG90 para poder realizar los movimientos de los dedos, como en este proyector no se contempla la acción de fuerza de la mano se utilizan estos por ser de bajo torque y dimensiones pequeñas, luego, para la rotación y desplazamiento vertical de la mano si se utiliza los MG946R que son de alto torque, ya que para estas acciones si se necesitan mas fuerza por parte del servo. Cabe destacar que todo esto es por parte del receptor, el cual se deberá alimentar con una fuente que pueda dar la potencia necesaria para que la micro y servos puedan trabajar con normalidad.

\begin{figure}[H]
 \centering
  \subfigure[ESP-32S]{
    }
  \subfigure[SG90]{
    }
  \subfigure[MG946R]{
    }
 \caption{}
 \label{f:Receptor}
\end{figure}

Por parte del transmisor, se hará uso de un sistema que mediante el movimiento vertical del dedo hará rotar un potenciómetro, el cual censará la posición, la micro lee este valor y lo transmite por Wifi. Ademas del censado de los dedos, se utiliza el acelerómetro y giroscopio MPU6050, con el cual se podrá medir el ángulo de inclinación y rotación de la mano, se debe tener en cuenta que este debe estar posiciona de forma paralela a la mano y bien orientado, ya que un mal posicionamiento influirá en su medición.  

\begin{figure}[H]
 \centering
  \subfigure[Potenciometro]{
    }
  \subfigure[MPU6050]{
    }
 \caption{}
 \label{f:Transmisor}
\end{figure}

\section{Desarrollo}

Los detalles del desarrollo del sistema se dividirá en dos partes: El receptor y el transmisor.

\subsection{Transmisor}

\subsubsection{Diseño}

\subsubsection{Conexionado y Código}

Pasando al desarrollo del código

\begin{lstlisting}
#include <esp_now.h>
#include <WiFi.h>
#include "MPU6050_Filtro.h"

// MAC de la placa RECEPTORA
uint8_t macReceptor[] = {0x1C, 0xC3, 0xAB, 0xD2, 0x14, 0x9C};
\end{lstlisting}

se utilizan distintas librerías para el funcionamiento del sistema, entre estas "ESP-NOW" y "WiFi" serán las encargadas de la comunicación inalámbrica entre las micro, su importancia se explicara mas adelante en la sección del Receptor. Luego, se importa una librería local creada para el manejo del giroscopio y acelerómetro MPU6050, se detallara su funcionamiento mas adelante en la presente sección.

Para la transmisión es muy importante que la micro conozca la MAC de la ESP que va a recibir los datos, de esta manera se asegura que los datos seran recibidos de forma eficiente en el destinatario deseado.

\begin{lstlisting}
const int pinPulgar = 39; 
const int pinIndice = 34; 
const int pinMedio  = 35;
const int pinAnular = 32;
const int pinMenique= 33;

// --- VARIABLES PARA EL SUAVIZADO DE POTENCIÓMETROS (Filtro EMA) ---
const float ALFA_ADC = 0.15; 
float filtroPulgar, filtroIndice, filtroMedio, filtroAnular, filtroMenique;

typedef struct mensaje_brazo {
  uint16_t valPulgar;
  uint16_t valIndice;
  uint16_t valMedio;
  uint16_t valAnular;
  uint16_t valMenique;
  uint16_t valMuniecaVertical;
  uint16_t valMuniecaRotacional;
} mensaje_brazo;

mensaje_brazo datosAEnviar;
esp_now_peer_info_t infoReceptor;
\end{lstlisting}

Se definen los pines utilizados para la lectura de los valores de los potenciómetros, se debe tener en cuenta que todos estos pines pertenezcan al ADC1 (Conversor analógico-digital), ya que la micro presenta dos conversores, pero el segundo se bloquea cuando se hace uso del WiFi.

Se crean variables para el filtrado de la señal leída de los potenciómetros, para evitar enviar paquetes basuras si el pote tiene falso contacto.

Para los paquetes a enviar se crea la estructura "mensaje-brazo", el cual debe ser igual tanto en el receptor como el transmisor, instanciandolo después. Ademas, en la línea 22 se crea el "perfil" del destinatario, ya que, antes de enviar el paquete se debe registrar la configuración del "peer".

\begin{lstlisting}
void setup() {
  Serial.begin(115200);

  // 1. Configuracion explicita del ADC antes de encender la radio
  pinMode(pinPulgar, INPUT);
  pinMode(pinIndice, INPUT);
  pinMode(pinMedio, INPUT);
  pinMode(pinAnular, INPUT);
  pinMode(pinMenique, INPUT);
  analogReadResolution(12);
  delay(100);

  // 2. Inicializar Comunicaciones
  WiFi.mode(WIFI_STA);
  WiFi.setSleep(false); // Desactiva el ahorro de energia

  if (esp_now_init() != ESP_OK) {
    Serial.println("Error inicializando ESP-NOW");
    return;
  }
  esp_now_register_send_cb((esp_now_send_cb_t)OnDataSent);
  
  memcpy(infoReceptor.peer_addr, macReceptor, 6);
  infoReceptor.channel = 0;  
  infoReceptor.encrypt = false;
  esp_now_add_peer(&infoReceptor);

  // 3. Inicializar el MPU6050
  inicializarMPU();

  // 4. Valores iniciales para el filtro EMA
  filtroPulgar = analogRead(pinPulgar);
  filtroIndice = analogRead(pinIndice);
  filtroMedio  = analogRead(pinMedio);
  filtroAnular = analogRead(pinAnular);
  filtroMenique = analogRead(pinMenique);

  // ==========================================
  // WARM-UP (PRECALENTAMIENTO DE FILTROS)
  // ==========================================
  Serial.println("Estabilizando filtros matematicos...");
  for (int i = 0; i < 50; i++) {
    filtroPulgar = (analogRead(pinPulgar) * ALFA_ADC) + 
                    (filtroPulgar * (1.0 - ALFA_ADC));
    
    filtroIndice = (analogRead(pinIndice) * ALFA_ADC) + 
                    (filtroIndice * (1.0 - ALFA_ADC));
    
    filtroMedio  = (analogRead(pinMedio) * ALFA_ADC) + 
                    (filtroMedio  * (1.0 - ALFA_ADC));
    
    filtroAnular = (analogRead(pinAnular) * ALFA_ADC) + 
                    (filtroAnular * (1.0 - ALFA_ADC));
   
    filtroMenique = (analogRead(pinMenique) * ALFA_ADC) + 
                    (filtroMenique * (1.0 - ALFA_ADC));
    
    leerAngulosFiltrados();
    delay(20); 
  }
  Serial.println("Transmisor Listo.");
}
\end{lstlisting}

Ya definiendo el hardware de la micro en el setup() lo primero que se hace es definir los pines en modo entrada, y asignarle la resolución al conversor, que en esta caso sera de 12 bits.

En la siguientes 10 líneas se hace el encendido del WiFi, poniendo la antena en modo estación, en caso de no hacer esto la placa podría actuar como un router. Ademas, se apaga el ahorro de energía para garantizar que el envío de datos sea continuo y sin latencia. 

Luego, se copia la MAC de la placa receptora, se le asigna cualquier canal de WiFi disponible, y se desactiva la encriptación para poder ganar velocidad  para el envió de los datos. Continuamos inicializando el modulo MPU6050, el cual se explicará a detalle mas adelante.

Se continua tomando los primeros valores en crudo de los potenciómetros, mediante un ciclo for, se realizan varias iteraciones aplicando el filtro EMA, de esta manera se busca estabilizar los valores leídos por la ESP32 antes de enviar los paquetes al receptor, pudiendo asegurar que los valores enviados no son lecturas falsas. 

Por ultimo, se vera como funciona el loop(), el cual se estará ejecutando constantemente. 

\begin{lstlisting}
  // 1. Filtrado en tiempo real de los analogicos
  filtroPulgar = (analogRead(pinPulgar) * ALFA_ADC) + 
                 (filtroPulgar * (1.0 - ALFA_ADC));
  
  filtroIndice = (analogRead(pinIndice) * ALFA_ADC) + 
                 (filtroIndice * (1.0 - ALFA_ADC));
  
  filtroMedio  = (analogRead(pinMedio) * ALFA_ADC) + 
                 (filtroMedio  * (1.0 - ALFA_ADC));
  
  filtroAnular = (analogRead(pinAnular) * ALFA_ADC) + 
                 (filtroAnular * (1.0 - ALFA_ADC));
  
  filtroMenique = (analogRead(pinMenique) * ALFA_ADC) + 
                  (filtroMenique * (1.0 - ALFA_ADC));

  // 2. Empaquetar datos de los dedos
  datosAEnviar.valPulgar  = (uint16_t)filtroPulgar;
  datosAEnviar.valIndice  = (uint16_t)filtroIndice;
  datosAEnviar.valMedio   = (uint16_t)filtroMedio;
  datosAEnviar.valAnular  = (uint16_t)filtroAnular;
  datosAEnviar.valMenique = (uint16_t)filtroMenique;

  // 3. Empaquetar datos del MPU6050
  AngulosMano angulos = leerAngulosFiltrados();
  datosAEnviar.valMuniecaVertical = angulos.vertical;
  datosAEnviar.valMuniecaRotacional = angulos.rotacion;

  Serial.print("Pulgar:");
  Serial.print(datosAEnviar.valPulgar);
  Serial.print(", Indice:");
  Serial.print(datosAEnviar.valIndice);
  Serial.print(", Medio:");
  Serial.print(datosAEnviar.valMedio);
  Serial.print(", Anular:");
  Serial.print(datosAEnviar.valAnular);
  Serial.print(", Menique:");     
  Serial.print(datosAEnviar.valMenique);
  Serial.print(", Munieca_Vertical:");    
  Serial.print(datosAEnviar.valMuniecaVertical);
  Serial.print(", Munieca_Rotacional:");  
  Serial.println(datosAEnviar.valMuniecaRotacional);

  // 4. Enviar
  esp_now_send(macReceptor, (uint8_t *) &datosAEnviar, sizeof(datosAEnviar));
  
  delay(20); // ~50Hz de actualizacion
}
\end{lstlisting}

En cada ciclo lo primero que se realiza es la lectura de los potenciómetros, para aplicar instantáneamente el filtro EMA, el cual es utilizado para reducir el ruido como se mencionara varias veces, de esta manera se estabilizan los valores. Una vez realizado el calculo se empaqueta lo que se obtuvo para poder enviárselo al receptor, la forma de asignar los valores es mediante "Casteo" colocando el tipo de variable "uint16\_t" por delante del nombre de cada una. 

También se deben tomar los valores para la rotación y desplazamiento vertical de la mano, estos se lo piden a la librería creada para el manejo del modulo MPU6050, los cálculos se realizan ahí mismo, por lo tanto, solo hay que hacer la asignación directa para poder enviarlos. 

El uso de "Serial.print" es para poder determinar de forma visual por el monitor serie si los valores que se enviaron son los que se esperan. Una vez realizado todo lo anterior, mediante la función "esp\_now\_send" se le da como argumento la estructura de datos a enviar para que los convierta en un tren de datos en bytes. 

Se debe destacar el uso del "delay(20)", este ayudara al manejo de transmisión en la red, ya que si no se usase el ESP32 intentaría enviar los paquetes a la velocidad del procesador, lo que saturaría el buffer de radio. Ademas, se sincroniza dichos pulsos de trabajo con el de los servomotes que trabajan a 50 Hz (20ms), buscando eliminar latencias.  

\subsubsection{MPU6050 con Filtro de Kalman}

A continuación se explicaran los fundamentos del uso del giroscopio y acelerómetro, con el respectivo filtro. 

\begin{itemize}
    \item \textbf{Giroscopio:}

    Este es un dispositivo que permite medir el ángulo de rotación girado por un determinado mecanismo. Estos son dispositivos diferenciales, lo que quiere decir que no existe una referencia absoluta, si no que se mide ángulos relativos a una referencia arbitraria. Los utilizado se denominan Giroscopios Vibratorios de efector Coriolis (CVG).

    El principio de funcionamiento de un CVG es que un objeto vibratorio tiene a vibrar en el mismo plano incluso si este rota. El efecto Coriolis provoca que el objeto vibratorio ejerza una fuerza sobre el soporte, y midiendo esta fuerza podemos determinar la rotación a la que está sometido el giroscopio.

    \begin{figure}[H]
    \begin{center}
 		
 		\captionof{figure}{Giroscopio}
            \label{fig:Pines}
    \end{center}
    \end{figure}

    Una de las consecuencias de emplear la fuerza Coriolis es que los giroscopios vibratorios, a diferencia de otros tipos de giroscopios, no registran el ángulo girado sino la velocidad angular, por lo tanto, para obtener el ángulo de posición del sensor es necesario realizar la integración respecto del tiempo.

    Los giroscopios son sensores de respuesta rápida y elevada precisión en tiempos cortos. Además, responden bien a cambios bruscos, y son relativamente inmunes al ruido, siempre en rangos temporales cortos.
    
    \item \textbf{Acelerómetro:}

    Un acelerómetro es un dispositivo que permite medir la aceleración a la que está sometido. Cualquier cuerpo sometido a una aceleración experimentará una cierta fuerza, empleando este hecho, se entenderá el funcionamiento del mismo.

    Para entender este dispositivo se debe pensar en un cuerpo sólido, en cuyo interior suspendemos una masa sujeta por muelles al cuerpo exterior. 

    \begin{figure}[H]
    \begin{center}
 		
 		\captionof{figure}{Acelerómetro}
            \label{fig:Pines}
    \end{center}
    \end{figure}

    Al aplicar una aceleración al conjunto la masa suspendida ejercerá una fuerza sobre los muelles causando que uno se contraiga y otro se elongue, por lo que la posición relativa de la masa dentro del sensor variará. Este desplazamiento de la masa libre interior puede ser medido para determinar la magnitud de la aceleración. El desplazamiento será proporcional a la aceleración soportada, y se mantendrá constante mientras la aceleración sea constante.

    El sensor se ve afectado por la gravedad terrestre, que supone una aceleración de aproximadamente $9.81 \frac{m}{s^{2}}$ en la superficie de la tierra, que por supuesto es registrada constantemente por el mismo. Dado esto se puede utilizar este efecto para poder determinar la orientación.

    \begin{figure}[H]
    \begin{center}
 		
 		\captionof{figure}{Orientación}
            \label{fig:Pines}
    \end{center}
    \end{figure}
    
\end{itemize}

Como se menciono anteriormente se hace uso del modulo MPU6050, el cual incorpora un acelerómetro y un giroscopio, conociéndose como IMU (Unidad de Medición Inercial), capaz de poder medir aceleración, velocidad y orientación de un sistema. Al presentar estos dos dispositivos, el modulo tiene 6 grados de libertad (DOF), lo que representa la cantidad de magnitudes independientes que es capaz de medir.

Se debe tener en cuenta que cuando se manejan estos dispositivos se suelen usar los ángulos de Tait-Bryan, en los que la orientación se representa como tres rotaciones ortogonales en torno al eje X (roll), Y (pitch), y Z (yaw).

\begin{figure}[H]
    \begin{center}
 		
 		\captionof{figure}{Rotaciones}
            \label{fig:Pines}
    \end{center}
\end{figure}

Para poder tener las ventajas en tiempos cortos del giroscopio y las ventajas a medio y largo plazo del acelerómetro es necesario que se combinen y filtren las señales, siendo uno de los filtros mas utilizado en este tipo de caso el de Kalman. 

\begin{itemize}
    \item Los giroscopios funcionan muy bien para movimientos cortos o bruscos, pero al usar giroscopios de vibración que realmente miden la velocidad angular, y obtienen el ángulo por integración respecto al tiempo, acumulan los errores y el ruido en la medición, por lo que a medio o largo plazo tienen deriva (drift).

    \item Los acelerómetros no tienen deriva (drift) a medio o largo plazo, ya que realizan la medición medida absoluta del ángulo que forma el sensor con la dirección vertical, marcada por la gravedad. Sin embargo, se ven influenciados por los movimientos del sensor y el ruido por lo que no son fiables a corto plazo.
\end{itemize}

Ya con toda esta información se pasará a explicar al código implementado para el manejo del modulo.

\begin{lstlisting}
class KalmanFilter {
  public:
    float Q_angle = 0.001f;
    float Q_bias = 0.003f;
    float R_measure = 0.03f;
    float angle = 0.0f;
    float bias = 0.0f;
    float P[2][2] = {{0.0f, 0.0f}, {0.0f, 0.0f}};

    float getAngle(float newAngle, float newRate, float dt) {
      float rate = newRate - bias;
      angle += dt * rate;

      P[0][0] += dt * (dt*P[1][1] - P[0][1] - P[1][0] + Q_angle);
      P[0][1] -= dt * P[1][1];
      P[1][0] -= dt * P[1][1];
      P[1][1] += Q_bias * dt;

      float S = P[0][0] + R_measure;
      float K[2] = {P[0][0] / S, P[1][0] / S};
      float y = newAngle - angle;
      angle += K[0] * y;
      bias += K[1] * y;

      P[0][0] -= K[0] * P[0][0];
      P[0][1] -= K[0] * P[0][1];
      P[1][0] -= K[1] * P[0][0];
      P[1][1] -= K[1] * P[0][1];

      return angle;
    }
};

KalmanFilter kalmanPitch;
KalmanFilter kalmanRoll;

uint32_t timer_kalman;
\end{lstlisting}

Se empieza creando una clase, la cual luego sera instanciada para cada eje con el que se trabajara, esta realizara el calculo de los ángulos mediante el filtro de Kalman. Se debe tener en cuenta que el filtro es un estimador probabilístico de estados, por lo tanto, se hará uso de matrices de covarianza (Q y R). 

Las matrices "Q\_bias" y "Q\_angle" representan el ruido interno del giroscopio, siendo la primera la varianza en la deriva del giroscopio, y la segunda la varianza en la predicción del ángulo. Mientras que "R\_Measure" representa el ruido de la medición externa, es decir, el acelerómetro.

Luego, "angle" y "bias" seran las variales de estado, siendo la primera la posición real de la mano, y la segunda la cantidad de grados por segundo de error que el giroscopio está generando. Continuamos definiendo la matriz "P[2][2]" que guarda la "incertidumbre" del filtro. En cada ciclo, el filtro actualiza esta matriz para saber qué tan seguro está de sus propios cálculos.

Pasamos a definir la función "getAngle()", esta tomara tres argumentos: la medición del acelerómetro (newAngle), la velocidad del giroscopio (newRate) y el tiempo transcurrido (dt). Funciona en dos fases clásicas: Predicción y Actualización.

Primero se resta el error conocido (bias) a la velocidad del giroscopio (newRate) para obtener una velocidad limpia (rate), luego, se integra la velocidad en el tiempo y se suma al último ángulo conocido, siendo una estimación a priori, para actualizar la matriz de incertidumbre. 

Ahora se toma el ángulo medido por el acelerómetro para corregir la predicción. Empieza realizando una estimación del error total (S) y con esto se calcula la ganancia de Kalman (K). Esta ultima matriz decide matemáticamente quien es mas confiable, si el acelerómetro es muy ruidoso, K sera pequeña. 

Continua calculando la diferencia matemática entre lo que el acelerómetro midió (newAngle) y lo que el filtro predijo (angle). Se multiplica esa diferencia por la Ganancia de Kalman y se lo suma a la estimaciones. Esto corrige de forma perfecta tanto el ángulo final como la deriva matemática (bias) del sensor. Esta es la estimación a posteriori. Finalmente, como se acaba de usar un dato real (el acelerómetro) para corregir el rumbo, la incertidumbre disminuye. Se actualiza la matriz $P$ restándole la incertidumbre que se acaba de resolver.

\begin{lstlisting}
void inicializarMPU() {
  Wire.begin(21, 22);
  if (!mpu.begin(0x68, &Wire)) {
    Serial.println("Error al iniciar MPU6050.");
    while (1) delay(10);
  }
  
  mpu.setAccelerometerRange(MPU6050_RANGE_2_G);
  mpu.setGyroRange(MPU6050_RANGE_500_DEG);
  mpu.setFilterBandwidth(MPU6050_BAND_21_HZ);
  timer_kalman = micros();
}
\end{lstlisting}

Para inicializar el modulo, se hace uso de dos pines en el ESP32, el 21 para los datos (SDA) y el 22 para el reloj (SCL), de esta manera se inicia el bus de comunicación I2C. En caso de fallar la comunicación se bloquea intencionalmente la micro para no realizar cálculos que puedan provocar NaN o posibles divisiones por cero, ademas, enviaría valores basuras a la mano pudiendo romperla.

En las siguientes tres lineas se configuran escalas del giroscopio y acelerómetro, mediante registros internos de hardware del MPU6050, y ademas, se activa un filtro pasa-bajos digital que viene incorpodaro por hardware. Luego, Con la función "micro()" se toma el valor actual del reloj interno de la ESP32 en microsegundos y lo guarda en la variable global, siendo esto usada para los cálculos que necesiten integrar el tiempo. 

\begin{lstlisting}
AngulosMano leerAngulosFiltrados() {
  sensors_event_t a, g, temp;
  mpu.getEvent(&a, &g, &temp);

  float dt = (float)(micros() - timer_kalman) / 1000000.0;
  timer_kalman = micros();

  float rawPitch = -(atan2(a.acceleration.x, 
                    sqrt(a.acceleration.y * a.acceleration.y + 
                    a.acceleration.z * a.acceleration.z)) * 180.0) / PI;
  
  float rawRoll;

  //Proteccion de la zona prohibida
  if (rawPitch > 80.0 || rawPitch < -80.0) {
      rawRoll = kalmanRoll.angle; 
  } else {
      rawRoll = (atan2(a.acceleration.y, a.acceleration.z) * 180.0) / PI;
  }

  float gyroRatePitch = -(g.gyro.y * 180.0 / PI); 
  float gyroRateRoll = g.gyro.x * 180.0 / PI;

  float smoothPitch = kalmanPitch.getAngle(rawPitch, gyroRatePitch, dt);
  float smoothRoll = kalmanRoll.getAngle(rawRoll, gyroRateRoll, dt);

  // Mapeo por tramos
  int pitchMapeado;
  if (smoothPitch >= 0) {
    //pitchMapeado = map(smoothPitch, 0, 45, 57, 90);
    pitchMapeado = map(smoothPitch, 0, 45, 57, 25);
  } else {
    //pitchMapeado = map(smoothPitch, -25, 0, 25, 57);
    pitchMapeado = map(smoothPitch, -25, 0, 90, 57);
  }

  int rollMapeado = map(smoothRoll, -90, 90, 0, 180);

  pitchMapeado = constrain(pitchMapeado, 25, 90);
  rollMapeado = constrain(rollMapeado, 0, 180);

  if (abs(pitchMapeado - ultimoPitch) >= UMBRAL_RUIDO) ultimoPitch = pitchMapeado;
  if (abs(rollMapeado - ultimoRoll) >= UMBRAL_RUIDO) ultimoRoll = rollMapeado;

  return {ultimoPitch, ultimoRoll};
}
\end{lstlisting}

Se finaliza la librería con la función "leerAngulosFiltrados()", la cual sera utilizada en el loop para tomar los valores medidos, aplicar trigonometría, fusionar los datos con Kalman, y finalmente estar listos para poder ser enviados. 

La función inicia pidiendo todos los registros del MPU6050 mediante la función "getEvent". Luego, calcula el diferencial de tiempo (dt) calculando en microsegundos cuanto tiempo paso desde la última lectura. 

En la variable "rawPitch" se calcula el movimiento de subir y bajar la muñeca (Pitch), para esto se debe realizar el arcotangente de la gravedad que reace sobre el eje X en comparación con la hipotenusa de los ejes Z e Y, para luego ser convertidos a grados sexagesimales ($-90^\circ$ hasta $ 90^\circ$).

Cuando la mano sube o baja más de 80 grados, la fuerza de gravedad se alinea completamente con el eje de rotación. Si se calculase la rotación (Roll) ahí, el arco tangente fallaría intentando dividir por casi cero. Al detectar esta "zona prohibida" ($\pm 80^\circ$), el código ignora al acelerómetro y congela el último valor seguro de rotación (kalmanRoll.angle) hasta que la mano este en una zona geométricamente estable, por dichas razones se hace uso de un condicional sobre los ángulos en el eje X.

Continua tomando valores del giroscopio ("gyroRatePitch" y "gyroRateRoll"), convirtiéndolas en grados por segundo, ya que se mide en radianes por segundo, para poder hacer uso del filtro de Kalman, dando como argumento el ángulo que se obtuvo del acelerómetro, la velocidad del giroscopio y el tiempo transcurrido. Como resultado se obtiene las variables "smoothPitch" y "smoothRoll" que contienen los ángulos absolutos de la mano. 

Ya con los ángulos se realiza un mapeo de los valores obtenidos al de los servomotores, ya que se debe tener en cuenta que en estos motores (MG946R) los valores van desde 0 a 180. Para los movimientos verticales (pitch) el servo solo debe cubrir el rango de 25 hasta 90, siendo 57 la posición media, por lo que, se mapea en dos tramos, de la mitad para arriba y la mitad para abajo, de esta manera se refleja de forma fluida los movimientos medidos en la mano 3D. Para el caso de la rotación (roll), solo se debe mapear todos los valores (-90 a 90) al rango completo del servo (0 a 180). Cabe destacar el uso de la función "constrain" que recorta cualquier valor que se excede del rango. 

Para finalizar, se realiza una comparación del nuevo calculo con el último enviado, si la diferencia supera un cierto umbral (configurado en $2^\circ$) se actualiza la nueva información, en caso de no superar el umbral no se actualiza para no estar constantemente enviando pequeñas variaciones de ángulo y hacer zumbar el servomotor, evitando desgaste innecesarios en los engranajes. 

\subsection{Receptor}

\subsubsection{Diseño}

Antes de pasar a explicar el conexionado y el código, detallaremos el diseño en 3D realizado, para esto se hizo uso de Solid Edge, el cual es un programa de diseño desarrollado por Siemens, para la realización de objetos 3D, asistido por computadora (CAD). 

\begin{figure}[H]
    \begin{center}
 		
 		\captionof{figure}{Solid Edge}
            \label{fig:SolidEdge}
    \end{center}
\end{figure}

Este programa resulta muy amigable con el usuario, donde se deben realizar, en un plano, los bocetos del diseño del objeto deseado, para luego mediante la Extrusión, poder extenderlo de las 2 dimensiones a las 3 dimensiones. En un mismo objeto se van formando bocetos en distintas partes del mismo, y mediante la extrusión, se van haciendo vaciados o protrusiones, dandole asi la forma deseada. De esta manera, se desarrollo la siguiente estructura:

\begin{figure}[H]
 \centering
  \subfigure[]{
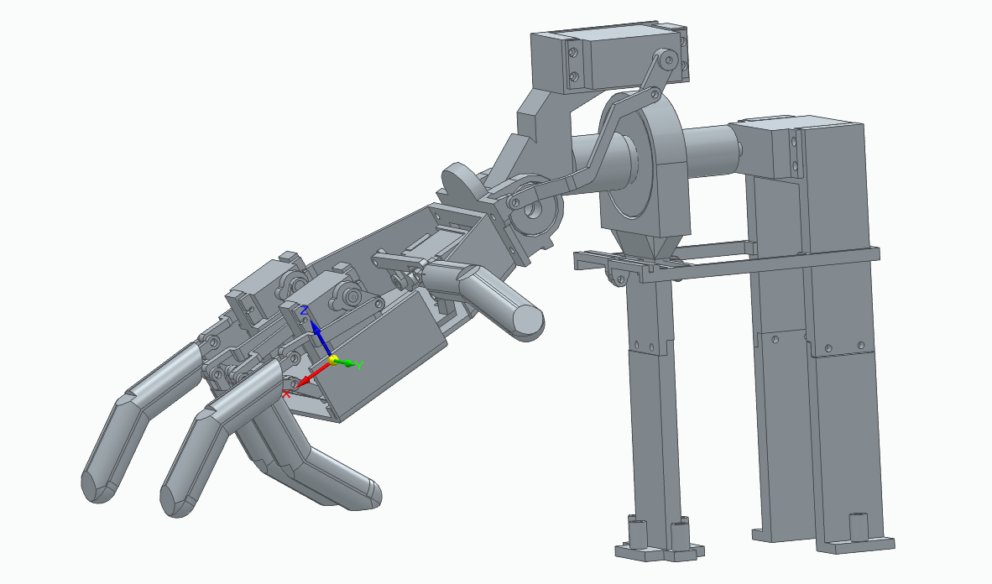
[picture p48: informe/Imagenes/Diseño_Receptor_1.png]
    }
  \subfigure[]{
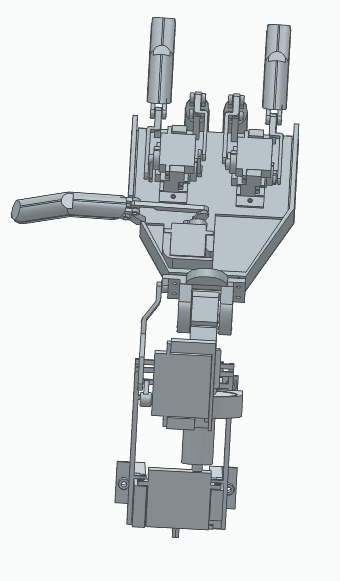
[picture p49: informe/Imagenes/Diseño_Receptor_2.png]
    }
  \subfigure[]{
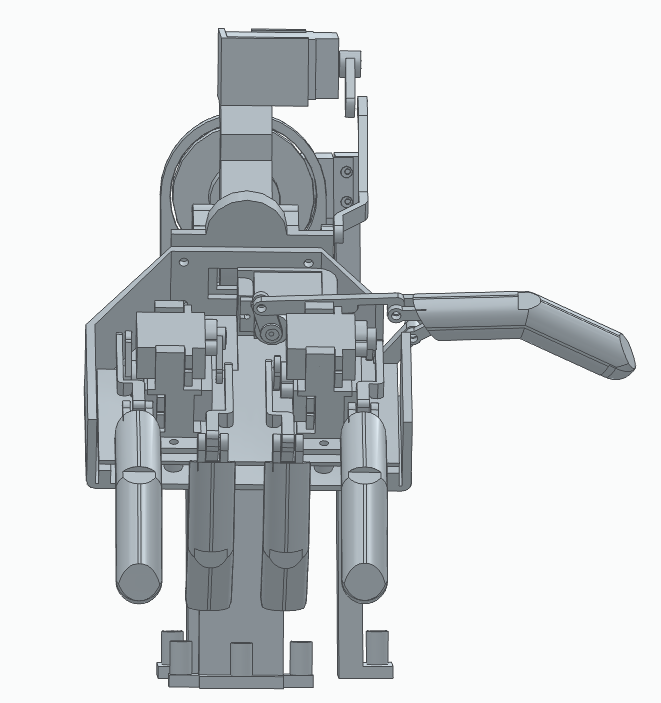
[picture p50: informe/Imagenes/Diseño_Receptor_3.png]
    }
 \caption{Estructura de la mano}
 \label{f:Receptor}
\end{figure}

El diseño consta de dos soportes, a unos 17cm de altura, que sostendran toda la estrucutura. Para la rotación se engancha un brazo (Figura \ref{fig:SolidEdge}) con el servo de forma directa, para facilitar el movimiento se hace uso de un ruleman (20cm de diametro interior), luego este se une con la mano mediante un tornillo que pasa entre los dos. Ademas, este contiene el servo que se engancha con la mano, el cual realizara los desplazamientos verticales.

Por ultimo, dentro de la mano, se tiene una base que unira todo el conjunto de servo SG90, los servos se ubicaran de a pares de forma vertical, uno en cada dirección, mediante un brazo se enlaza al dedo, siendo que el dedo esta atornillado a la base. El unico que es distinto, es el dedo pulgar, donde el servo se atornilla directo a la base.  

Cabe recalcar que tambien se diseñaron pequeños soportes, que van enganchados a los soportes mas grandes, para poder sostener la base de la micro de forma sencilla. Todos los diseños realizados fueron impresos en la impresora Hellbot Hidra.

\begin{figure}[H]
 \centering
  \subfigure[Base ESP32]{
    }
  \subfigure[Impresora 3D Hellbot Hidra]{
    }
 \caption{}
 \label{f:Extra}
\end{figure}

\subsubsection{Conexionado y Código}

Gracias al uso de la Base de la ESP32 (\ref{f:Extra}), resulto mas sencillo el conexionado de los servos y la alimentación del todo el circuito, ya que este presenta pines en la posición necesaria para poder conectar los servos (Señal, VCC y GND) y la placa, puediendose alimentar con dos tipos de USB (MicroUSB y USC-C) y con un miniplug, siendo el ultimo el requerido para poder lograr que todo funcione con normalidad, por su capacidad de entregar entre 6.5 a 16V. Ademas, se debe tener en cuenta que la fuente a utilizar debe poder administrar la potencia necesaria, siendo los valores electricos de funcionamiento los siguientes:

\begin{itemize}
    \item SG90: entre 5/6 V y 100/250 mA sin carga hasta 500 mA bajo bloqueo.
    \item MG946R: entre 4.8/6 V y 170 mA sin carga hasta 1.2 A bajo bloqueo.
    \item ESP32: con 5V y entre 300/500 mA con Wifi activo. 
\end{itemize}

Dado que los SG90 nunca llegaran al bloqueo se los considera con consumo normal, en cambio, se debe tener mas en cuenta la corriente de bloqueo de los MG946R, y mas que nada el de los movimientos verticales, ya que es el que mas peso debe cargar. La fuente debe ser capaz de administrar, considerando todo lo anterior, al menos unos 3A para que todo pueda funcionar con normalidad, hasta en los casos de mucho consumo. 

Pasando el código, se empieza incluyendo las librerias necesarias y definiendo los pines/objetos necesarios.

\begin{lstlisting}
#include <esp_now.h>
#include <WiFi.h>
#include <ESP32Servo.h>

const int pinServoPulgar = 25; 
const int pinServoIndice = 26; 
const int pinServoMedio = 27; 
const int pinServoAnular = 12; 
const int pinServoMenique = 13;
const int pinServoMuniecaVertical = 32; 
const int pinServoMuniecaRotacional = 33; 

Servo servoPulgar;
Servo servoIndice;
Servo servoMedio;
Servo servoAnular;
Servo servoMenique;
Servo servoMuniecaVertical;
Servo servoMuniecaRotacional;
\end{lstlisting}

Primero veamos para que sirve cada librería:

\begin{itemize}
    \item \textbf{Esp Now:}
        Es la librería oficial de Espressif (fabricante de ESP32), encargada del protocolo de comunicación inalámbrica punto a punto que funciona sin necesidad de conectarse a un router, usando direcciones MAC. Esta permite enviar paquetes de datos muy pequeños a una alta velocidad y con bajísimo consumo de energía.
    \item \textbf{Wifi:}
        Es la librería estandar de Arduino para manejar el hardware de radio Wi-Fi integrado en la placa ESP32. Para que ESP-NOW funcione, la antena Wi-Fi de la ESP32 debe estar encendida físicamente.
    \item \textbf{ESP32Servo:}
        Es una librería diseñada exclusivamente para controlar servomotores usando la arquitectura interna de la ESP32. No se usa la librería clasica de Arduino <Servo.h> ya que ESP32 no tiene comando analógicos simples, usa un periférico interno muy complejo llamado LEDC (LED Control) y temporizadores (Timers) de hardware para generar señales PWM.
\end{itemize}

Dado los pines del ESP32

\begin{figure}[H]
    \begin{center}
 		
 		\captionof{figure}{ESP32 Pines}
            \label{fig:Pines}
    \end{center}
\end{figure}

se utilizaron los que se visualizan en el código por comodidad a la hora de realizar la conexión, son los que se encuentran mas cerca a los cables, ya que estos son de unos 30cm, y hay que contemplar que a la hora de que realice los movimientos la mano estos no se desconecten. Ademas, estos pines no cumplen una función especial que pueda interferir con el uso que se le quiere dar.

Luego de la definición de pines, se declaran objetos Servo, los cuales contienen las funciones necesarias para poder realizar las distintas acciónes sobre los servos. 

Continuamos con un detalle fundamental, la estructura de los datos

\begin{lstlisting}
typedef struct mensaje_brazo {
  uint16_t valPulgar;
  uint16_t valIndice;
  uint16_t valMedio;
  uint16_t valAnular;
  uint16_t valMenique;
  uint16_t valMuniecaVertical;
  uint16_t valMuniecaRotacional;
} mensaje_brazo;

mensaje_brazo datosRecibidos;

volatile bool nuevosDatos = false;
bool sincronizado = false; 
\end{lstlisting}

se crea una estructura que empaqueta los datos de las variables que se necesitan, definiendo en cada una el tipo de dato, para luego instanciarlo en una variable. Cabe recalcar que este tipo de estructura tiene que ser identica tanto en el transmisor como receptor, si no se cumple esto habra uan falla en la lectura de datos recibidos. Tambien, se crean dos variables booleanas para poder sincronizar la recepción.

\begin{lstlisting}
float alfaDedos = 0.2; 
float alfaMunieca = 0.3; 

// Posiciones Actuales vs Objetivo
float actPulgar=25, actIndice=25, actMedio=25, actAnular=25, 
actMenique=25, actMuniecaVertical=57, actMuniecaRotacional = 90;

float objPulgar=25, objIndice=25, objMedio=25, objAnular=25, 
objMenique=25, objMuniecaVertical=57, objMuniecaRotacional=90;

void OnDataRecv(const uint8_t * mac, const uint8_t *incomingData, int len) {
  memcpy(&datosRecibidos, incomingData, sizeof(datosRecibidos));
  nuevosDatos = true;
}
\end{lstlisting}

Se crean las variables para poder utilizar el filtro promedio movil exponencial (EMA), el cual se detallara mas adelante. Este filtro se utiliza para poder suavizar los movimientos de los servos, de esta manera se pueden apreciar desplazamientos mas fluidos, por dicha razon se debe tener en cuenta el ángulo objetivo al que se quiere llegar y el actual. Los alfas son factores utilizados para determinar el grado de cambio, mientras mas cercano a uno es, mas rapida sera la respuesta, si es mas cercano a cero, el grado de cambio sera mas lento.

La función "OnDataRecv" es una interrupción que trabaja de forma asincrona, pausa el sistema operativo de la ESP cuando la antena detecta un paquete de radio, para poder ejecutar dichas lineas de código, luego vuelve a la normalidad. En dicho instante, la función "memcpy" vierte directamente en la memoria (datosRecibidos) la fila de bytes que llegaron a la antena.  

Sigue la definición del setup(), el cual definirá el hardware de la micro.

\begin{lstlisting}
void setup() {
  Serial.begin(115200);
  
  ESP32PWM::allocateTimer(0);
  ESP32PWM::allocateTimer(1);
  ESP32PWM::allocateTimer(2);
  ESP32PWM::allocateTimer(3);

  servoPulgar.write(25);
  servoIndice.write(25);
  servoMedio.write(25);
  servoAnular.write(25);
  servoMenique.write(25);
  servoMuniecaVertical.write(57);
  servoMuniecaRotacional.write(90);

  servoPulgar.attach(pinServoPulgar, 500, 2400);
  servoIndice.attach(pinServoIndice, 500, 2400);
  servoMedio.attach(pinServoMedio, 500, 2400);
  servoAnular.attach(pinServoAnular, 500, 2400);
  servoMenique.attach(pinServoMenique, 500, 2400);
  servoMuniecaVertical.attach(pinServoMuniecaVertical, 500, 2400);
  servoMuniecaRotacional.attach(pinServoMuniecaRotacional, 500, 2400);
  
  WiFi.mode(WIFI_STA);
  Serial.print("MAC Address: ");
  Serial.println(WiFi.macAddress());

  if (esp_now_init() != ESP_OK) {
    Serial.println("Error inicializando ESP-NOW");
    return;
  }
  
  esp_now_register_recv_cb((esp_now_recv_cb_t)OnDataRecv);
  Serial.println("Brazo robotico encendido. Esperando transmisor...");
}
\end{lstlisting}

Con la función "allocateTimer" lo que se hace es reservar cuatro temporizadores de hardware interno para el uso exclusivo del PWM, siendo esta señal la que leerán los servos. Se debe saber que los servomotores utilizados se manejan mediante ancho del pulso del PWM, variando su tiempo en ON, estos se posicionaran en el ángulo que se desea.

Gracias al uso de las librerías, mediante la función "write" es que se da la orden de posicionar el servo en cierto ángulo, de esta manera el ESP32 cambiara el ancho de pulso del PWM para posicionarlo. Para lograr esto, tambien se tiene que hacer uso de "attach", el cual asigna el pin físico a cada objeto servo, y ademas, asigna los pulsos eléctricos mínimos y máximos a los ángulos mínimos y máximos, respectivamente. 

A partir de aquí se inicializa la comunicación, encendiendo la antena en modo cliente para que escuche los paquetes que llegan, en caso de que falle la inicialización se arroja un error. Finalmente se le dice al sistema que cada vez que escuche un paquete de datos interrumpa el proceso y ejecute "OnDataRecv". Se imprime también la MAC del ESP, ya que el transmisor debe saber a donde deben dirigidos los datos.  

Pasando al final del código, veamos el loop(), el cual es la función que se repite constantemente a muy alta velocidad. 

\begin{lstlisting}
void loop() {
  
  if (nuevosDatos) {
    nuevosDatos = false;
    
    // Mapeo seguro con limites mecanicos de seguridad (Clamping)
    objPulgar  = constrain(map(datosRecibidos.valPulgar, 0, 4095, 25, 90), 25, 90);
    objIndice  = constrain(map(datosRecibidos.valIndice, 0, 4095, 25, 90), 25, 90);
    objMedio   = constrain(map(datosRecibidos.valMedio,  0, 4095, 25, 90), 25, 90);
    objAnular  = constrain(map(datosRecibidos.valAnular, 0, 4095, 25, 90), 25, 90);
    objMenique = constrain(map(datosRecibidos.valMenique,0, 4095, 25, 90), 25, 90);
    
    objMuniecaVertical  = datosRecibidos.valMuniecaVertical;
    objMuniecaRotacional = datosRecibidos.valMuniecaRotacional;

    // === LOGICA DE SINCRONIZACION ASINCRONA ===
    if (!sincronizado) {
      actPulgar = objPulgar;
      actIndice = objIndice;
      actMedio = objMedio;
      actAnular = objAnular;
      actMenique = objMenique;
      actMuniecaVertical = objMuniecaVertical;
      actMuniecaRotacional = objMuniecaRotacional;
      
      sincronizado = true;
      Serial.println("Primer paquete recibido. Sincronizacion completa. 
      Iniciando movimiento.");
    }
  }

  // Si se enciende el Brazo antes que el Guante, se queda en reposo aqui
  if (!sincronizado) {
    delay(20);
    return; 
  }

  // === FILTRO EMA MECANICO ===
  actPulgar  = (objPulgar * alfaDedos)  + (actPulgar * (1.0 - alfaDedos));
  actIndice  = (objIndice * alfaDedos)  + (actIndice * (1.0 - alfaDedos));
  actMedio   = (objMedio * alfaDedos)   + (actMedio * (1.0 - alfaDedos));
  actAnular  = (objAnular * alfaDedos)  + (actAnular * (1.0 - alfaDedos));
  actMenique = (objMenique * alfaDedos) + (actMenique * (1.0 - alfaDedos));
  
  actMuniecaVertical  = (objMuniecaVertical * alfaMunieca)  + 
  (actMuniecaVertical * (1.0 - alfaMunieca));
  
  actMuniecaRotacional  = (objMuniecaRotacional * alfaMunieca)  + 
  (actMuniecaRotacional * (1.0 - alfaMunieca));

  // === EJECUCION ===
  servoPulgar.write(actPulgar);
  servoIndice.write(actIndice);
  servoMedio.write(actMedio);
  servoAnular.write(actAnular);
  servoMenique.write(actMenique);
  servoMuniecaVertical.write(actMuniecaVertical);
  servoMuniecaRotacional.write(actMuniecaRotacional);

  // Retardo de 20ms para coincidir exactamente 
  con la frecuencia de 50Hz de los Servomotores
  delay(20); 
}
\end{lstlisting}

Lo primero que se hace es revisar la recepción de nuevos datos, en caso de no haberlos se ignora parte del código. Luego, en las primeras 10 lineas se mapean los valores de los dedos leídos del transmisor, a los valores de ángulo que están dentro del rango de movimiento de la mano. En el caso de la muñeca (Vertical y Rotacional) los valores son directos, no hay que mapearlos. Se debe destacar el uso de la función "constrain", el cual sirve para el caso de que, por una interferencia eléctrica, se lea un valor absurdo para el angulo del dedo (120° por ejemplos) excediendo los limites asignados, siendo dicha función la que recortara el valor a los limites asignados (25° a 90°).  

En las siguientes 20 lineas se realiza una sincronización de datos, mas que nada al iniciar todo el sistema, receptor y transmisor, para que el brazo no realice movimientos exigentes por leer cualquier tipo de valor, sea porque el transmisor todavía se esta inicializando o directamente esta apagado. 

Una vez lograda la sincronización, y la obtención de nuevos datos, se pasa al uso del Filtro EMA, el cual se utiliza para darle fluidez a los movimientos de la mano. La idea del uso de este filtro es que la taza de cambio del ángulo sea mas gradual, por ejemplo, el dedo se encuentra en 25° y debe ir a 90°, considerando un valor de "alfaDedos" de 0.15, el primer instante se moverá un 15\% pasando a 34°, luego otro 15\% , y así sucesivamente hasta alcanzar el objetivo.

Cada vez que se calcula un nuevo valor de ángulo, con la función "write" se asigna físicamente el ancho del pulso necesario para lograr dicha posición en el servo.

A lo último se puede observar un delay de 20ms, este es utilizado para sincronizar matemáticamente el código con la electrónica analógica del motor, ya que estos suelen trabajar en 50 Hz, lo que equivale a 20ms, de esta manera se puede garantizar menos vibraciones y máximo torque. 

\section{Pruebas}

Se observara que tan útil es el uso de los distintos filtros para cada medición realizada en el ESP, primero empezamos con el modulo MPU6050, se observaran las mediciones obtenidas por el micro cuando es modulo esta totalmente quieto y luego con un pequeño movimiento, para poder observar cual es la respuesta al respecto. Para el caso del Pitch resulta:

\begin{figure}[H]
 \centering
  \subfigure[Pitch Sin Movimiento]{
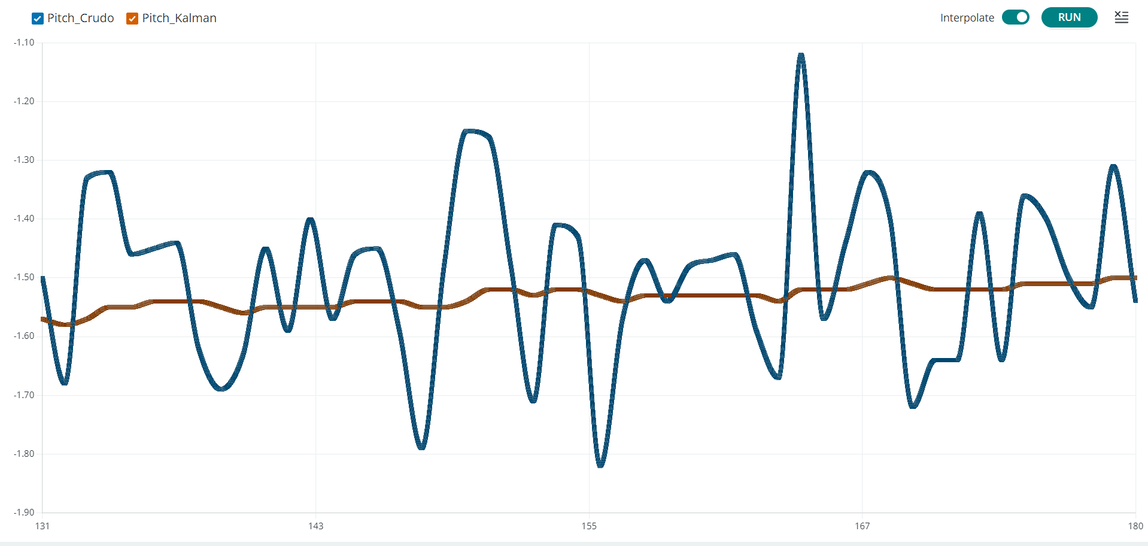
[picture p51: informe/Imagenes/Pitch_Ruido_Sin_Movimiento.png]
    }
  \subfigure[Pitch Con Movimiento]{
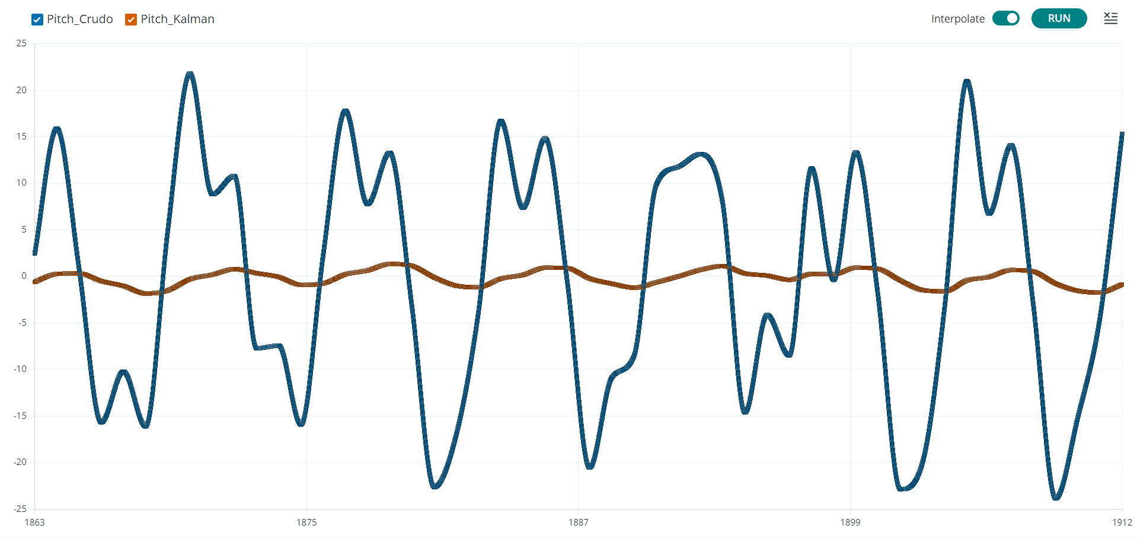
[picture p52: informe/Imagenes/Pitch_Ruido_Con_Movimiento.png]
    }
 \caption{}
 \label{f:Ruido_Pitch}
\end{figure}

y para el caso del Roll se observa:

\begin{figure}[H]
 \centering
  \subfigure[Roll Sin Movimiento]{
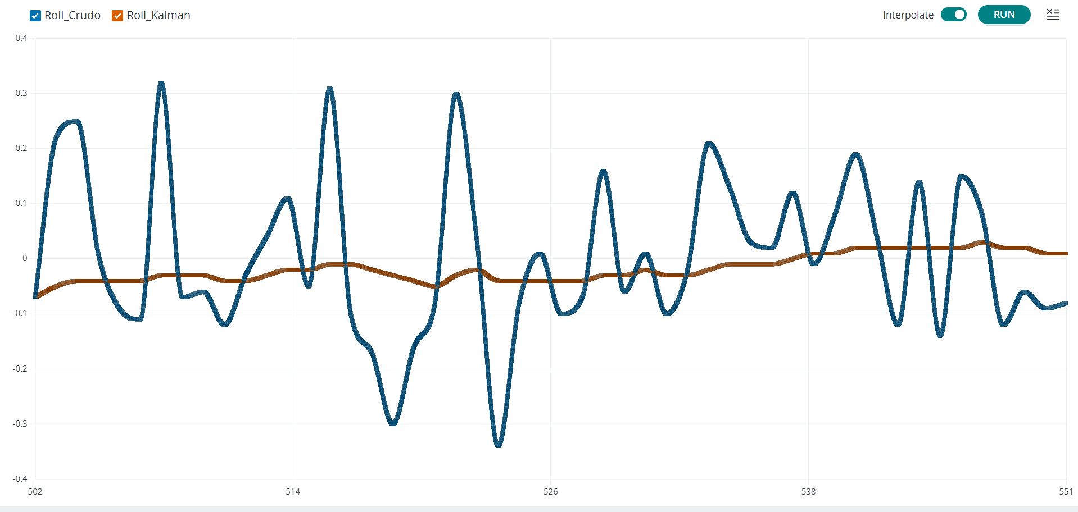
[picture p53: informe/Imagenes/Roll_Ruido_Sin_Movimiento.png]
    }
  \subfigure[Roll Con Movimiento]{
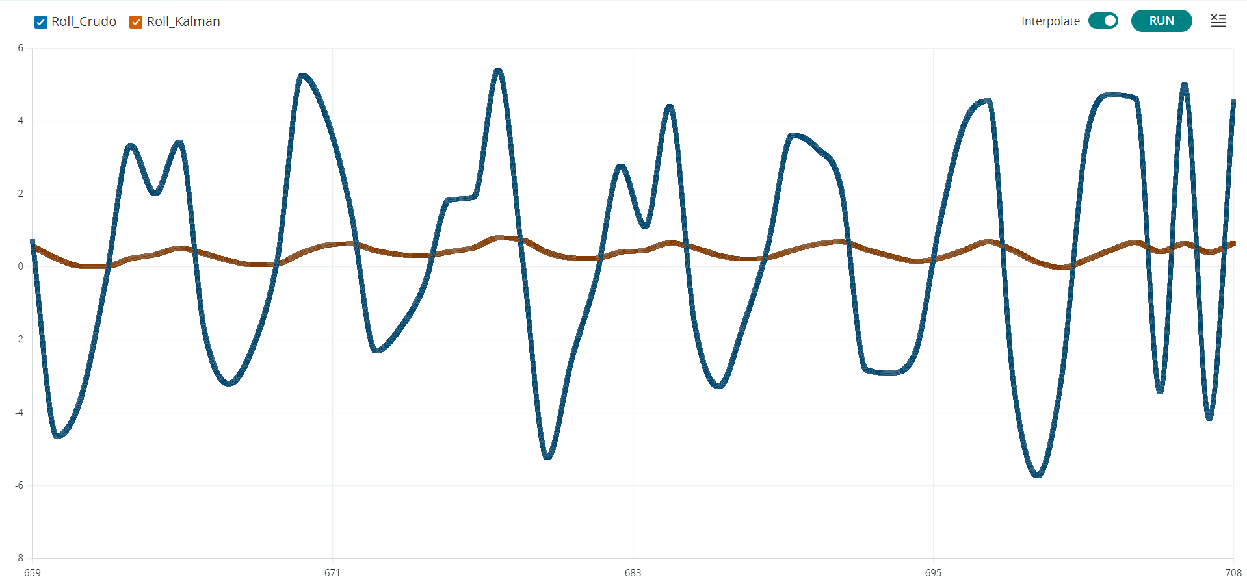
[picture p54: informe/Imagenes/Roll_Ruido_Con_Movimiento.png]
    }
 \caption{}
 \label{f:Ruido_Roll}
\end{figure}

Ahora se analizará como se comportan los potenciómetros, viendo la respuesta con los datos leídos en crudo y los datos filtrado, lo que da como resultado:

\begin{figure}[H]
 \centering
  \subfigure[Cambio Lento]{
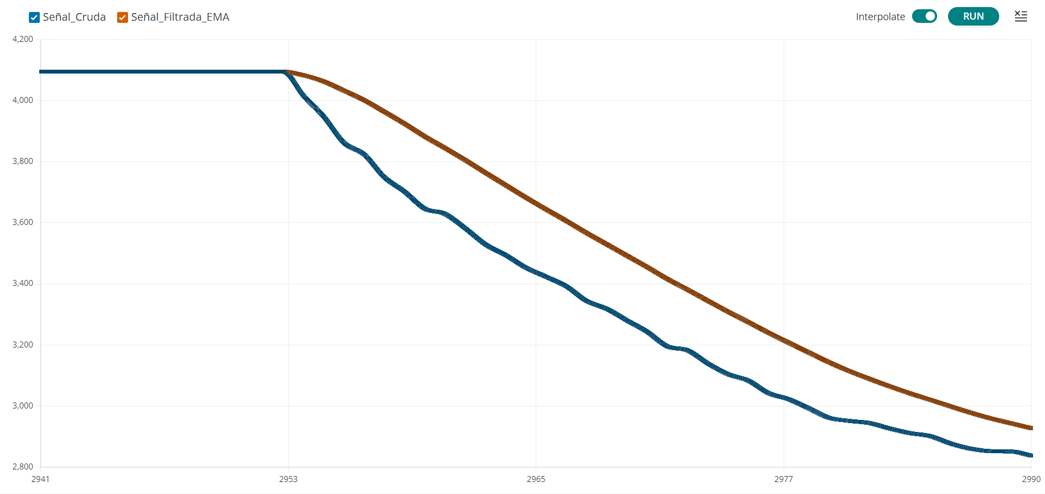
[picture p55: informe/Imagenes/Pote_Ruido.png]
    }
  \subfigure[Cambio Brusco]{
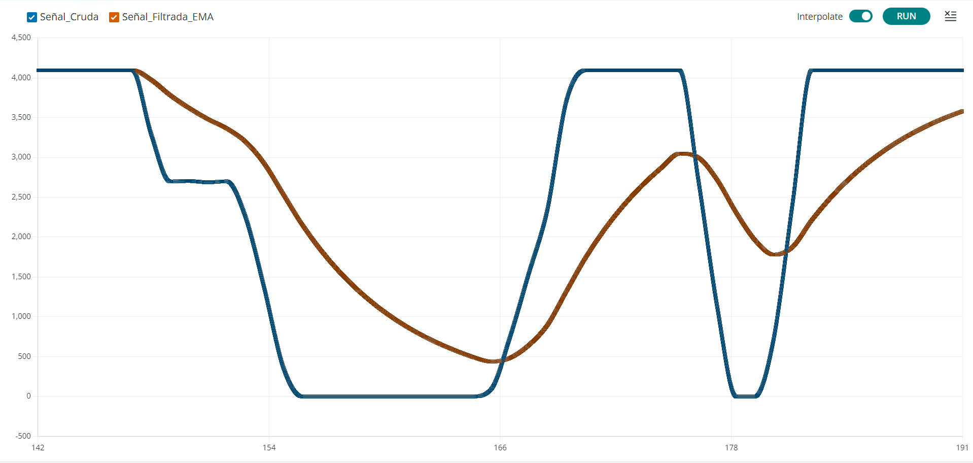
[picture p56: informe/Imagenes/Pote_Ruido_1.png]
    }
 \caption{Respuesta potenciómetro}
 \label{f:Ruido_Potenciometros}
\end{figure}

Se puede ver que con el filtrado la respuesta de la lectura es mas lenta, y es lo que se necesita para el mecanismo de la mano, ya que respuestas rápidas podrían generar roturas en el mecanismo armado o podría dañar los servos, por dicha razón se debe filtrar para evitar movimientos excesivos en la mano. 

A continuación se observa la respuesta del sistema completo, tanto el transmisor como el receptor, se apreciaran la forma en que responde cada uno, el tiempo de respuesta, entre que se transmite la información hasta que llega y se replica, entre otros detalles que se puedan apreciar.

\begin{figure}[H]
 \centering
  \subfigure[Desplazamiento Vertical]{
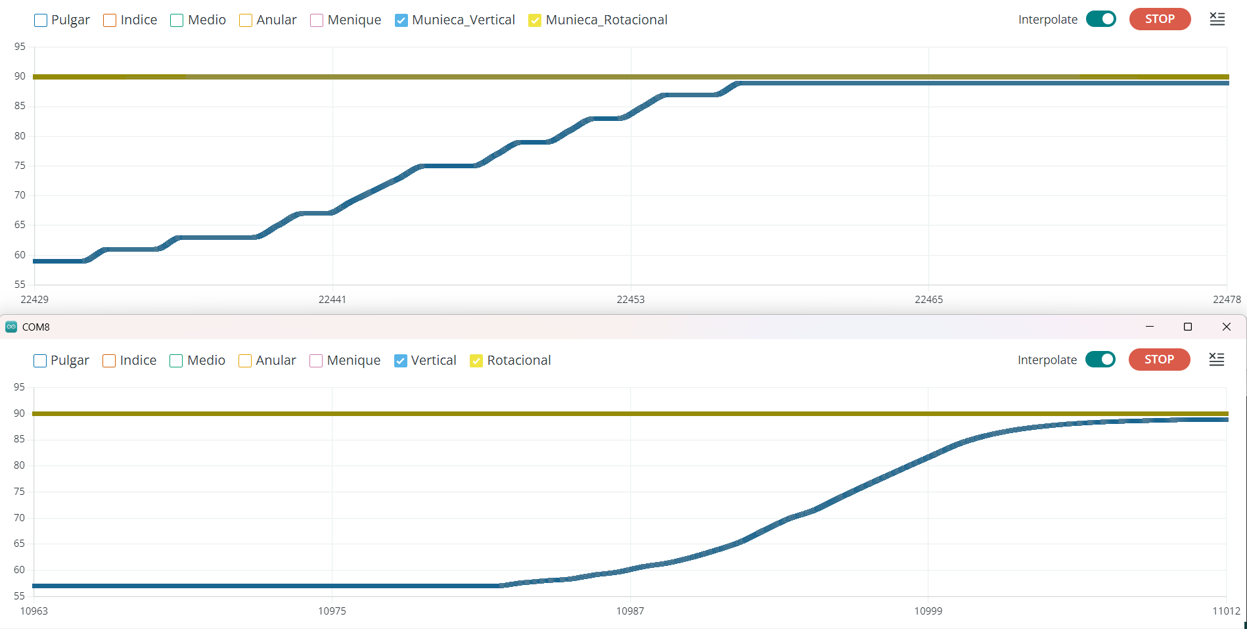
[picture p57: informe/Imagenes/Transmicion_1.png]
    }
  \subfigure[Rotación]{
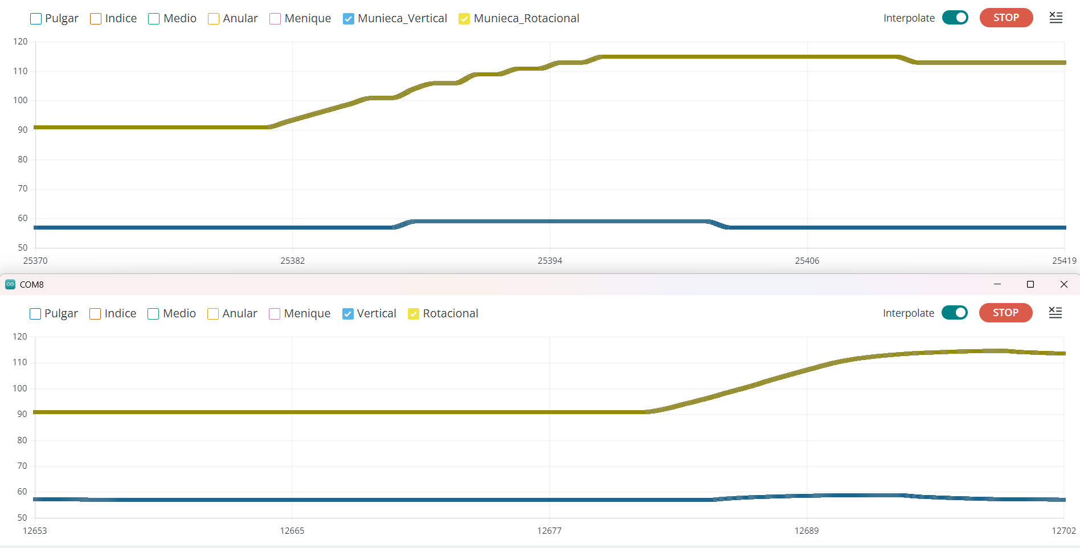
[picture p58: informe/Imagenes/Transmicion_2.png]
    }
  \subfigure[Subir Dedo]{
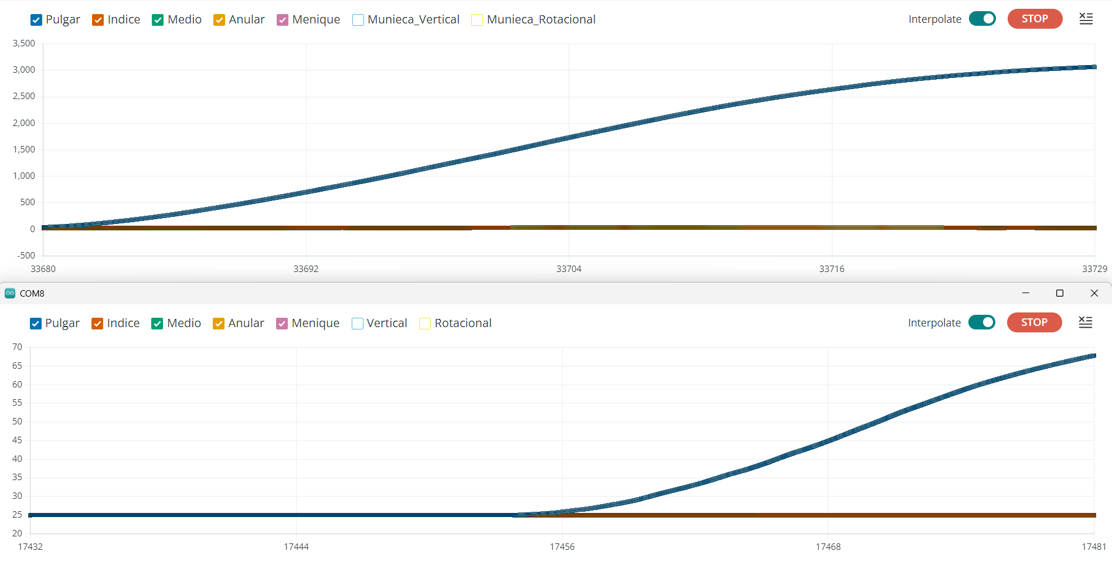
[picture p59: informe/Imagenes/Transmicion_3.png]
    }
  \subfigure[Bajar Dedo]{
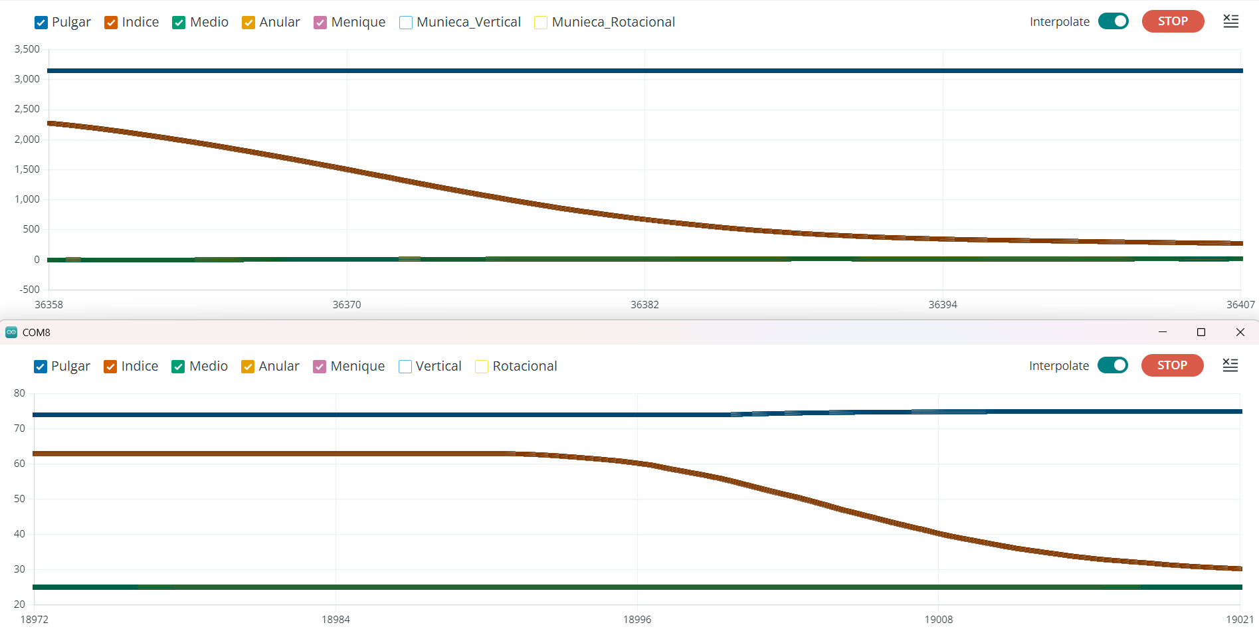
[picture p60: informe/Imagenes/Transmicion_4.png]
    }
 \caption{Respuesta sistema}
 \label{f:Ruido_Potenciometros}
\end{figure}

Como se observa en las imágenes, hay un pequeño delay entre que se toma los valores del potenciómetro, se analizan, se transmiten y se replican. Este sera el tiempo de respuesta del sistema, que es de aproximadamente unos 20ms. 

\section{Conclusiones}

\end{document}
