sevastianamoroso/proyecto-mano/informe/capitulos/06_evolucion.tex

\section{Evolución del diseño}
\label{sec:evolucion}

El firmware se desarrolló de forma iterativa: cada versión se probó en el hardware y los problemas observados motivaron la siguiente. Las versiones están identificadas con etiquetas (\textit{tags}) en el repositorio de git del proyecto, lo que permite reproducir cualquiera de ellas. La tabla~\ref{tab:versiones} resume la evolución y las secciones siguientes explican cada cambio.

\begin{table}[H]
\centering
\begin{tabularx}{\textwidth}{l X X}
\toprule
\textbf{Versión} & \textbf{Cambios principales} & \textbf{Motivo} \\
\midrule
Preliminar & Filtro EMA en el guante y en la mano, bucle con \texttt{delay(20)}, envío de lecturas crudas del ADC & Primera implementación funcional \\
1.0.0 & Tareas FreeRTOS, cola, protocolo con checksum, limitador de velocidad y banda muerta, calibración en NVS, filtro de Kalman en la muñeca & Retardo y zumbido de la versión preliminar \\
2.0.0 & Filtro complementario, calibración del giróscopo, mapeo en punto flotante & La muñeca derivaba ``como un mouse'' \\
2.1.0 & Limitador de velocidad más rápido, inversión de dedos por software & La mano respondía lento; dedos invertidos \\
2.2.0 & El receptor procesa cada paquete al llegar; DLPF a \SI{44}{\hertz} & Reducir la latencia \\
2.3.0 & Transmisión pausada durante la calibración & Consola y mano confusas al calibrar \\
\bottomrule
\end{tabularx}
\caption{Versiones del firmware. Todas se probaron en hardware; la 2.3.0 es la versión actual.}
\label{tab:versiones}
\end{table}

\subsection{Versión preliminar}

En la primera implementación, el transmisor leía los potenciómetros, les aplicaba un filtro de media móvil exponencial (EMA),
\begin{equation}
y[k] = \alpha\, x[k] + (1-\alpha)\, y[k-1],
\end{equation}
con $\alpha = 0{,}15$, y enviaba las lecturas del ADC sin convertir. El receptor convertía esas lecturas a ángulos y aplicaba un segundo filtro EMA ($\alpha = 0{,}2$ para los dedos y $0{,}3$ para la muñeca) antes de escribir los servos. Ambos programas usaban un bucle con \texttt{delay(20)} y, en el receptor, el callback de recepción copiaba el paquete directamente sobre una variable global. La tabla~\ref{tab:preliminar} resume los problemas encontrados.

\begin{table}[H]
\centering
\begin{tabularx}{\textwidth}{X X X}
\toprule
\textbf{Planteo inicial} & \textbf{Problema} & \textbf{Solución adoptada} \\
\midrule
Dos filtros EMA en cascada (guante y mano) & Los retardos de ambos filtros se suman. Además, el EMA se acerca al objetivo con pasos cada vez más pequeños, que caen dentro de la zona de insensibilidad del servo y lo hacen zumbar & Limitador de velocidad y banda muerta en el receptor (sección~\ref{sec:slew}) \\
Bucle con \texttt{delay(20)} & El período real es \SI{20}{\milli\second} más el tiempo de cómputo, y varía & Tareas FreeRTOS con \texttt{vTaskDelayUntil} \\
Callback que escribe una variable global & La tarea principal puede leer un paquete a medio escribir & Cola FreeRTOS de un elemento \\
Paquete sin verificación & Un paquete corrupto o ajeno se interpretaría como una orden válida & Firma, número de secuencia y checksum (sección~\ref{sec:protocolo}) \\
Conversión fija de 0--4095 a \SIrange{25}{90}{\degree} & No contempla las diferencias entre dedos ni entre usuarios & Calibración de dos puntos en NVS \\
\bottomrule
\end{tabularx}
\caption{Problemas de la versión preliminar.}
\label{tab:preliminar}
\end{table}

\subsection{Versión 1.0.0: filtro de Kalman}

La versión 1.0.0 incorporó la arquitectura descripta en las secciones~\ref{sec:transmisor} y~\ref{sec:receptor}, pero estimaba la orientación de la muñeca con un filtro de Kalman de dos estados por eje (ángulo y sesgo del giróscopo) \cite{kalman1960, lauszus_kalman}, que pondera la integración del giróscopo y el ángulo del acelerómetro según sus incertidumbres. Las ecuaciones, los parámetros y el código están en el apéndice~\ref{sec:kalman}. En las pruebas la muñeca se comportaba ``como un mouse'': derivaba y no volvía a la misma posición con la misma postura. Las causas fueron:

\begin{enumerate}
    \item \textbf{Signo del giróscopo de \textit{pitch} invertido} respecto del acelerómetro: cada uno empujaba la estimación hacia un lado distinto.
    \item \textbf{Variable sin inicializar en el \textit{roll}} en la zona de singularidad, que producía saltos.
    \item \textbf{Arranque desde \SI{0}{\degree}}, sin ángulo inicial ni calibración del \textit{bias}.
    \item \textbf{Conversión a enteros antes del mapeo}, que truncaba el ángulo y no lo saturaba.
\end{enumerate}

\subsection{Versiones 2.0.0 a 2.3.0}

\begin{itemize}
    \item \textbf{2.0.0:} el Kalman se reemplazó por el filtro complementario (sección~\ref{sec:fusion}), equivalente en la práctica para dos ángulos a \SI{50}{\hertz}, con un único parámetro ($\alpha$) en lugar de tres covarianzas. Se corrigieron las cuatro causas anteriores y se agregaron los límites mecánicos en el receptor.
    \item \textbf{2.1.0:} el limitador de velocidad estaba por debajo de la velocidad de los servos (un giro de \SI{180}{\degree} de la muñeca tardaba \SI{1.8}{\second}); se elevó a los valores de la tabla~\ref{tab:param_rx}. Se agregó la inversión de los dedos por software.
    \item \textbf{2.2.0:} la tarea del receptor despierta al llegar el paquete en lugar de cada \SI{20}{\milli\second} fijos (hasta \SI{20}{\milli\second} menos de espera), y el DLPF del MPU6050 pasó de \SI{21}{\hertz} a \SI{44}{\hertz} (tabla~\ref{tab:dlpf}).
    \item \textbf{2.3.0:} durante la calibración se detienen la lectura de los dedos, el envío y la telemetría (sección~\ref{sec:calibracion_dedos}).
\end{itemize}
