sevastianamoroso/proyecto-mano/informe/Imagenes/PrimerModeloMano_1.png

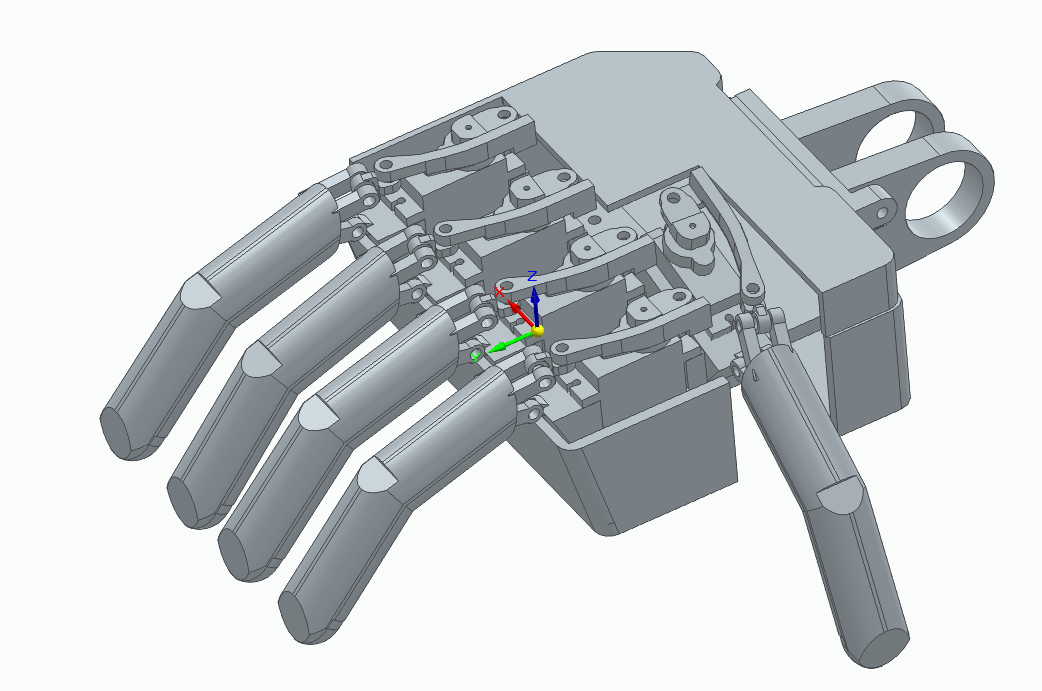
informe/Imagenes/PrimerModeloMano_1.png
