sevastianamoroso/proyecto-mano/informe/Imagenes/Receptor/PrimerModeloMano_2.png

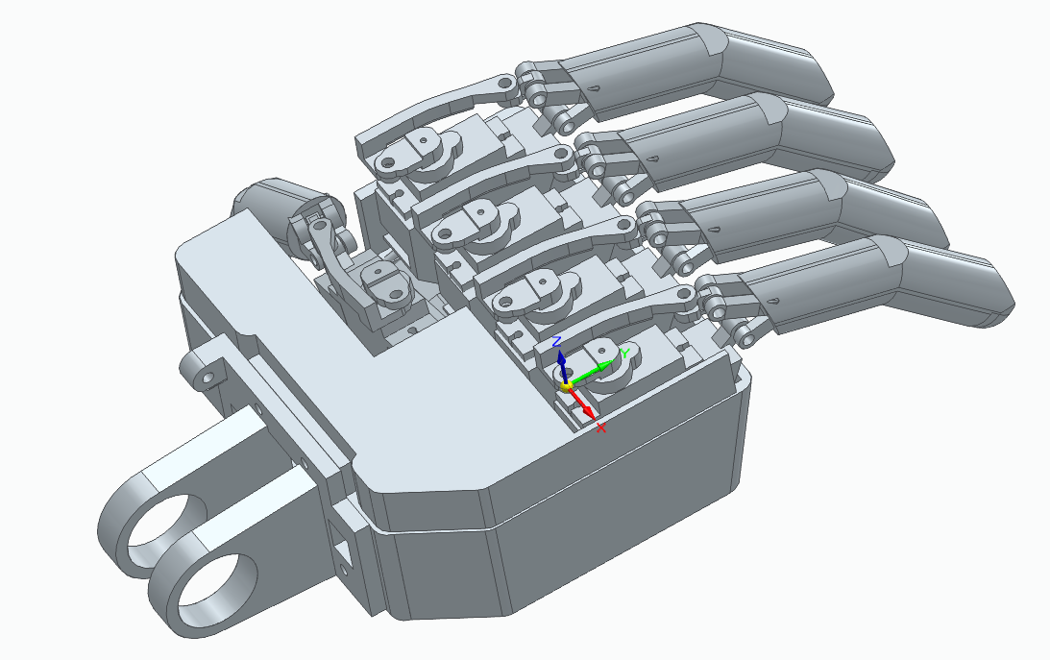
informe/Imagenes/Receptor/PrimerModeloMano_2.png
