sevastianamoroso/proyecto-mano/informe/Imagenes/Respuesta_Indice.jpeg

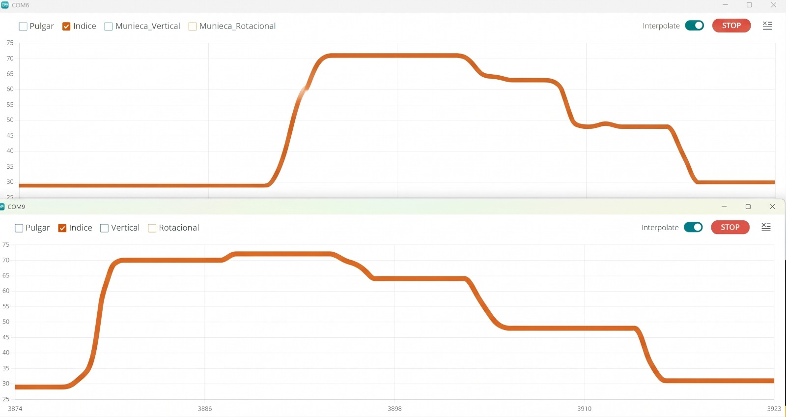
informe/Imagenes/Respuesta_Indice.jpeg
