sevastianamoroso/proyecto-mano/informe/Imagenes/Respuesta_Muneca_Rotacional.jpeg

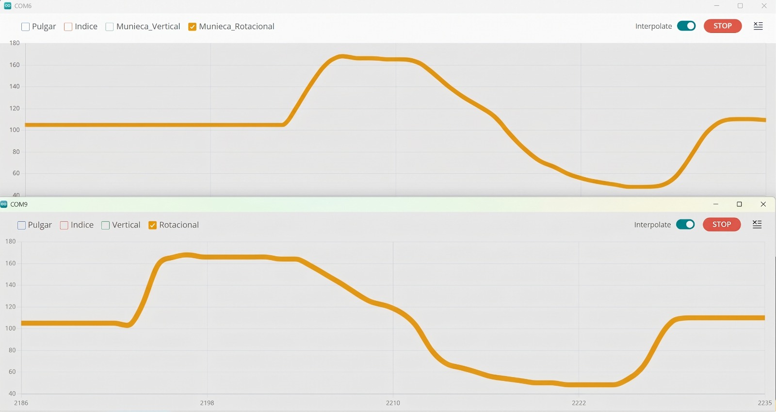
informe/Imagenes/Respuesta_Muneca_Rotacional.jpeg
