sevastianamoroso/proyecto-mano/informe/Imagenes/Respuesta_Pulgar.jpeg

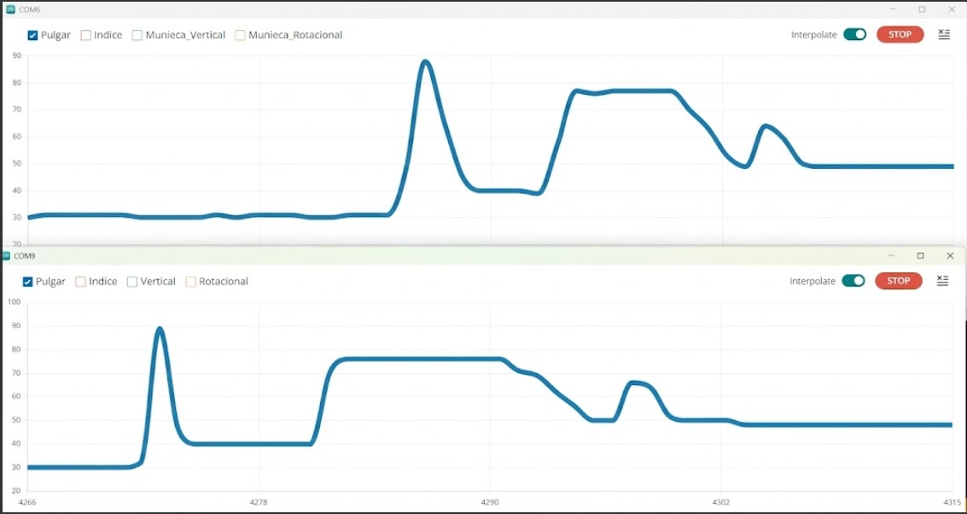
informe/Imagenes/Respuesta_Pulgar.jpeg
