sevastianamoroso/proyecto-mano/munieca_vertical.jpeg

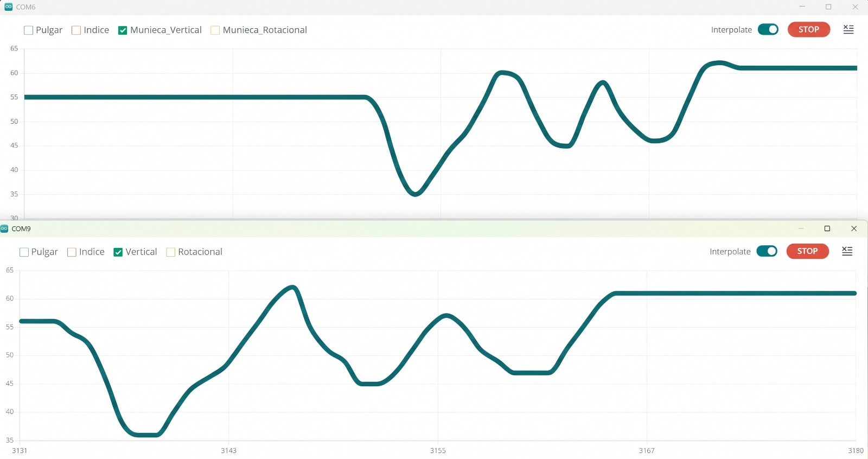
munieca_vertical.jpeg
