sevastianamoroso/proyecto-mano/cad/Receptor/Para Imprimir/BaseMano.3mf

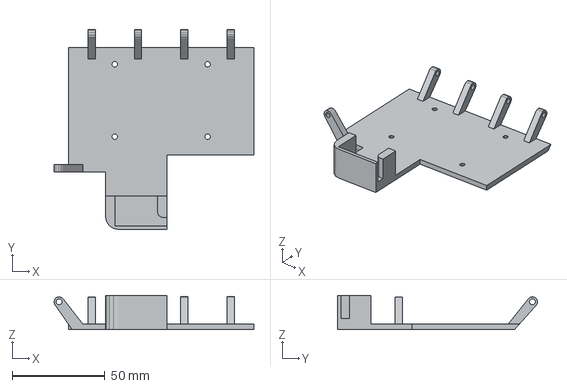
[picture p85: CAD file, 2026-10-27]
cad/Receptor/Para Imprimir/BaseMano.3mf
107.7 x 107.7 x 18.5 mm
