sevastianamoroso/proyecto-mano/cad/Transmisor/Para Imprimir/Dorsal_V3.3mf

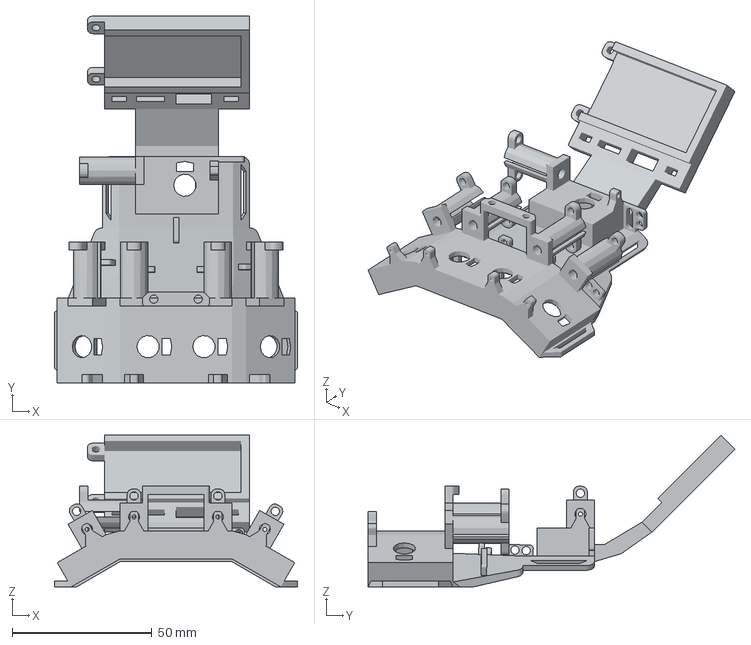
[picture p86: CAD file, 2026-10-27]
cad/Transmisor/Para Imprimir/Dorsal_V3.3mf
87.0 x 131.3 x 54.2 mm
