sevastianamoroso/proyecto-mano/cad/Receptor/Para Imprimir/Sosten_2_1.3mf

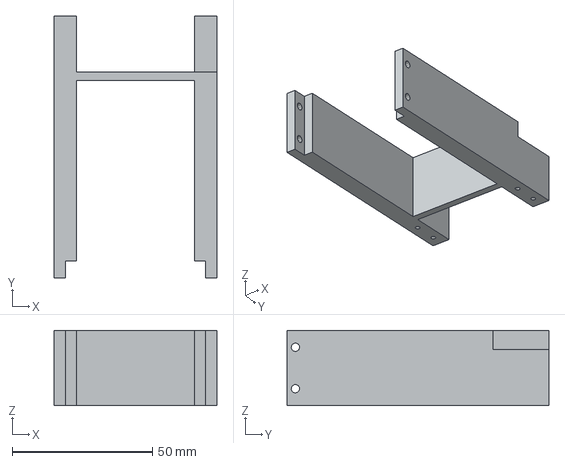
[picture p87: CAD file, 2026-10-27]
cad/Receptor/Para Imprimir/Sosten_2_1.3mf
58.0 x 93.5 x 26.8 mm
