sevastianamoroso/proyecto-mano/cad/Transmisor/Para Imprimir/Dedal2_Pulgar_V3.3mf

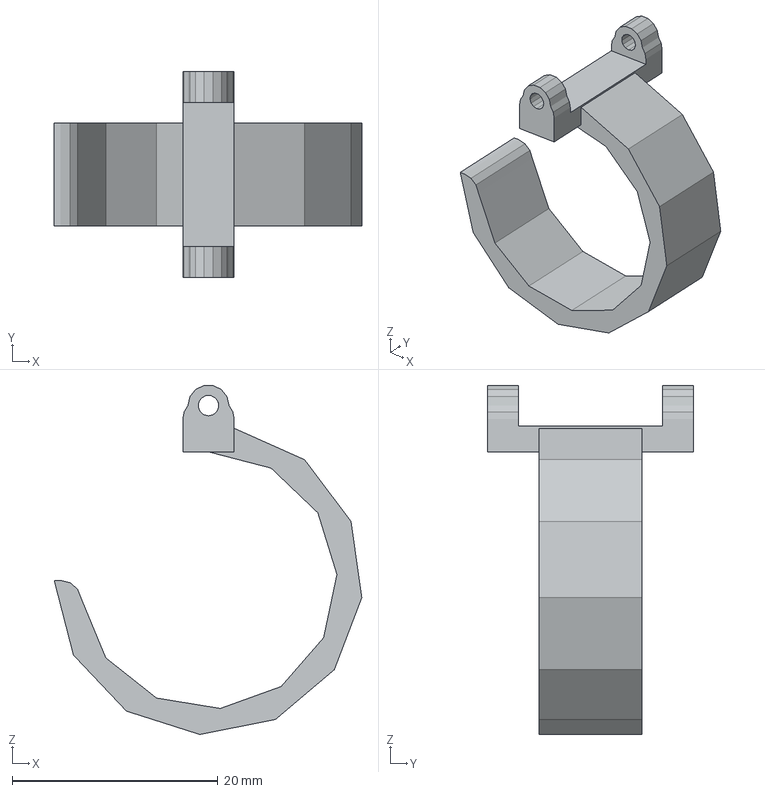
[picture p88: CAD file, 2026-10-27]
cad/Transmisor/Para Imprimir/Dedal2_Pulgar_V3.3mf
29.9 x 20.0 x 33.9 mm
