sevastianamoroso/proyecto-mano/cad/Receptor/Para Imprimir/ArticulacionMunieca.3mf

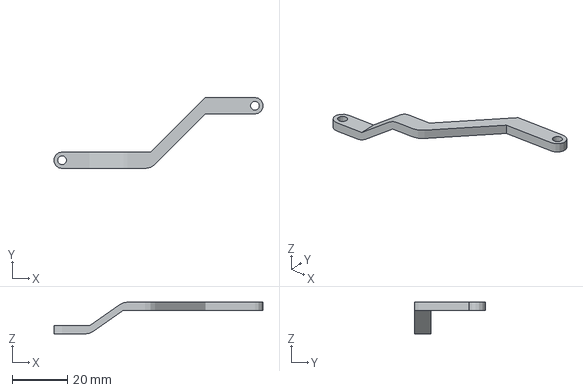
[picture p89: CAD file, 2026-10-27]
cad/Receptor/Para Imprimir/ArticulacionMunieca.3mf
75.9 x 25.8 x 11.6 mm
