sevastianamoroso/proyecto-mano/cad/Receptor/Para Imprimir/Sosten_1.3mf

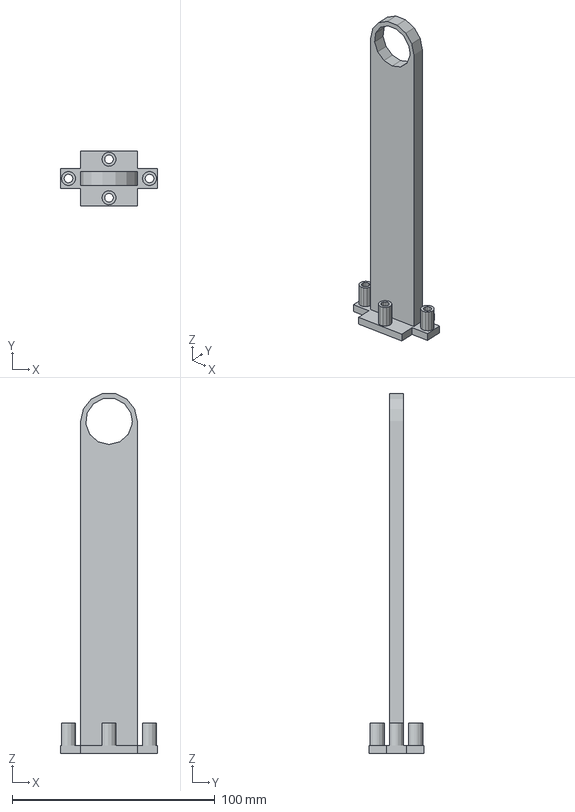
[picture p90: CAD file, 2026-10-27]
cad/Receptor/Para Imprimir/Sosten_1.3mf
48.0 x 27.0 x 177.6 mm
