sevastianamoroso/proyecto-mano/cad/Transmisor/Para Imprimir/Dedal_2.3mf

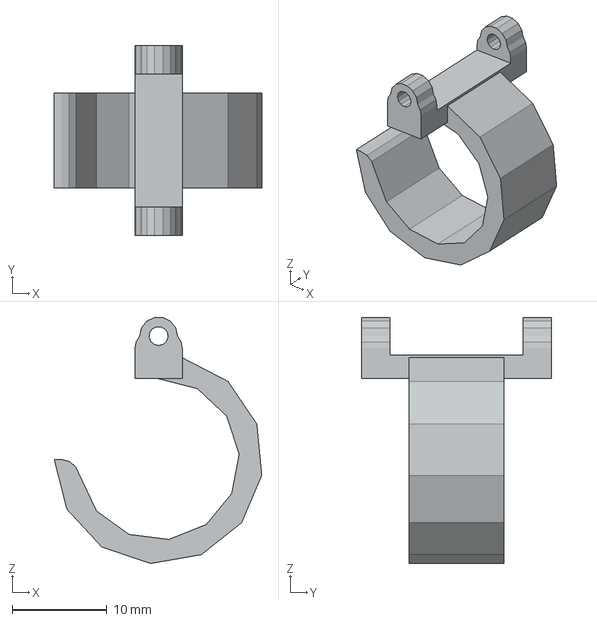
[picture p91: CAD file, 2026-10-27]
cad/Transmisor/Para Imprimir/Dedal_2.3mf
21.9 x 20.0 x 25.9 mm
