sevastianamoroso/proyecto-mano/cad/Receptor/Para Imprimir/ArticulacionMunieca_V2.3mf

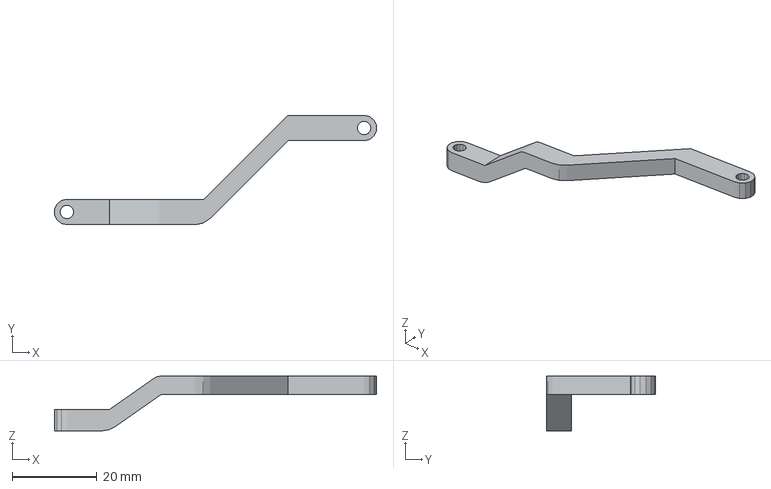
[picture p92: CAD file, 2026-10-27]
cad/Receptor/Para Imprimir/ArticulacionMunieca_V2.3mf
75.9 x 25.8 x 12.9 mm
