sevastianamoroso/proyecto-mano/cad/Transmisor/Para Imprimir/Dedal3_Pulgar.3mf

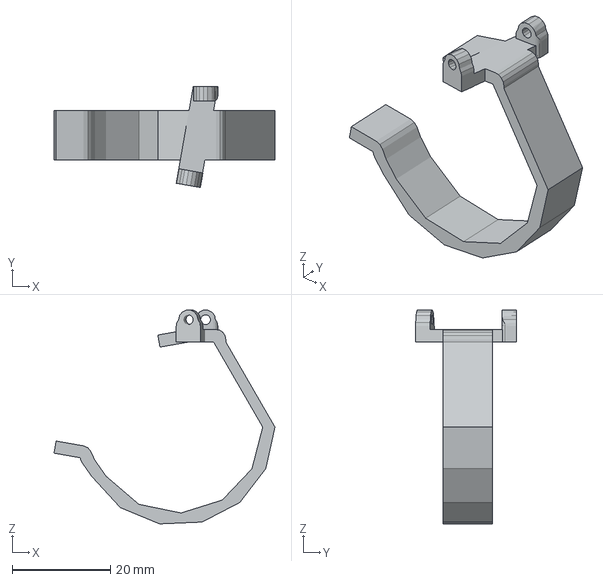
[picture p93: CAD file, 2026-10-27]
cad/Transmisor/Para Imprimir/Dedal3_Pulgar.3mf
45.0 x 20.6 x 43.5 mm
