sevastianamoroso/proyecto-mano/cad/Receptor/Para Imprimir/AgarrePlaca_1.3mf

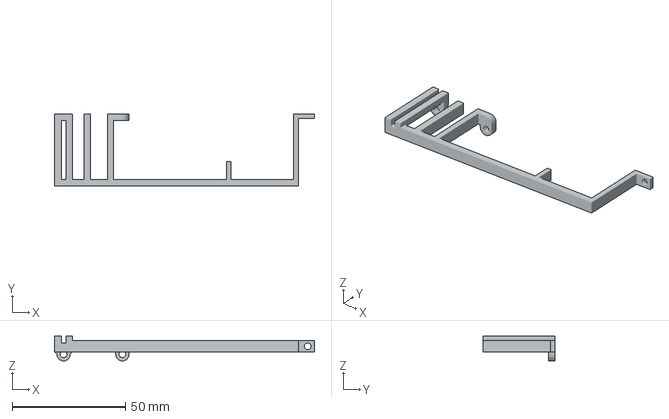
[picture p94: CAD file, 2026-10-27]
cad/Receptor/Para Imprimir/AgarrePlaca_1.3mf
114.8 x 32.0 x 10.9 mm
