sevastianamoroso/proyecto-mano/cad/Transmisor/Para Imprimir/Dedal_1.3mf

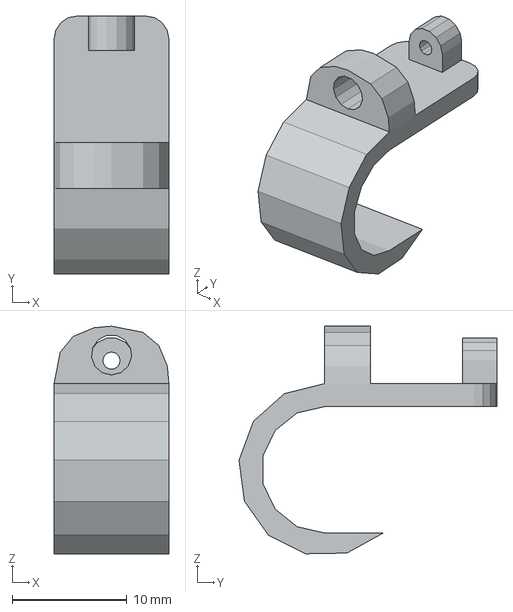
[picture p95: CAD file, 2026-10-27]
cad/Transmisor/Para Imprimir/Dedal_1.3mf
10.0 x 22.5 x 19.8 mm
