sevastianamoroso/proyecto-mano/cad/Receptor/Para Imprimir/Munieca.3mf

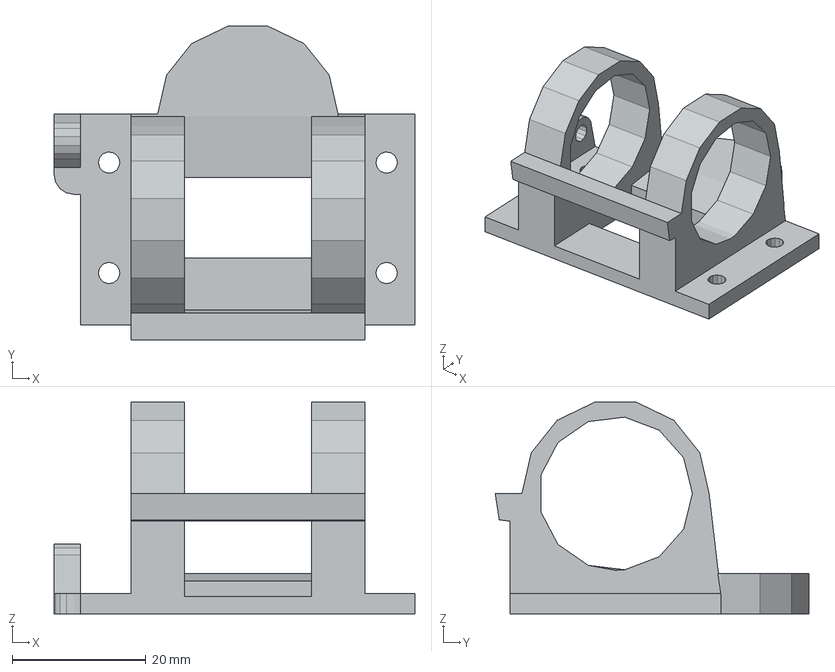
[picture p96: CAD file, 2026-10-27]
cad/Receptor/Para Imprimir/Munieca.3mf
54.0 x 46.9 x 31.6 mm
