sevastianamoroso/proyecto-mano/cad/Transmisor/Para Imprimir/Tapa_Resortera.3mf

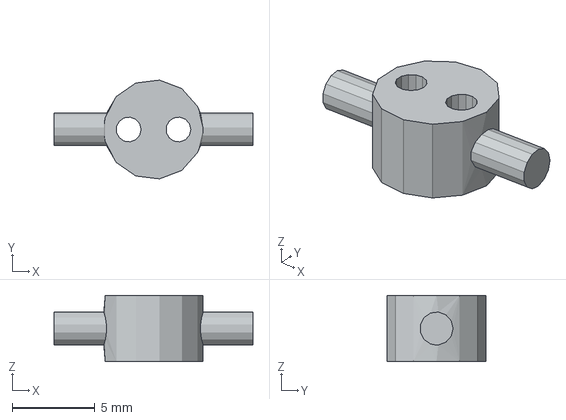
[picture p97: CAD file, 2026-10-27]
cad/Transmisor/Para Imprimir/Tapa_Resortera.3mf
12.0 x 5.96 x 4.00 mm
