sevastianamoroso/proyecto-mano/cad/Receptor/Para Imprimir/BrazoServo.3mf

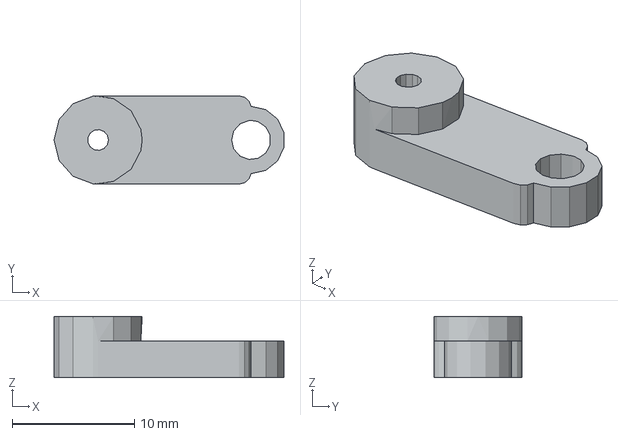
[picture p98: CAD file, 2026-10-27]
cad/Receptor/Para Imprimir/BrazoServo.3mf
18.8 x 7.20 x 5.00 mm
