sevastianamoroso/proyecto-mano/cad/Transmisor/Para Imprimir/AgarrePote.3mf

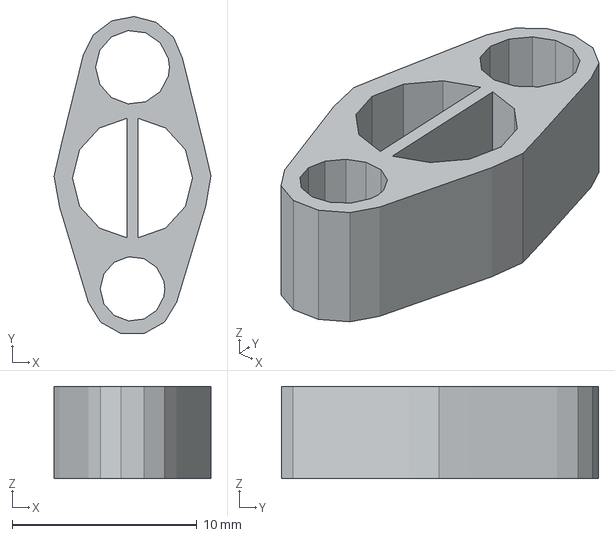
[picture p99: CAD file, 2026-10-27]
cad/Transmisor/Para Imprimir/AgarrePote.3mf
8.50 x 17.2 x 5.00 mm
