sevastianamoroso/proyecto-mano/cad/Receptor/Para Imprimir/MuniecaMovVerticales_V2.3mf

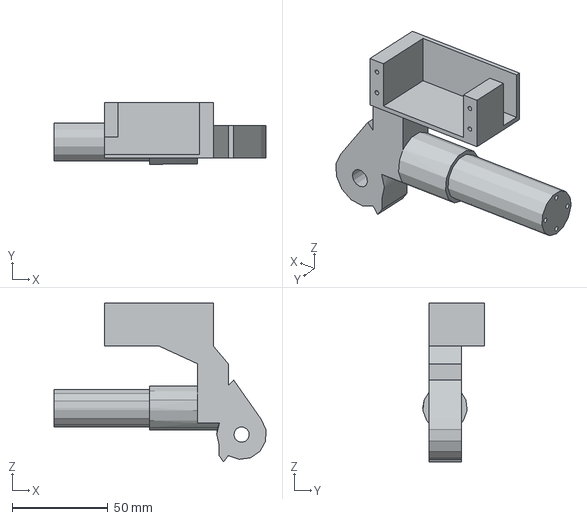
[picture p100: CAD file, 2026-10-27]
cad/Receptor/Para Imprimir/MuniecaMovVerticales_V2.3mf
110.7 x 32.2 x 82.9 mm
