sevastianamoroso/proyecto-mano/cad/Transmisor/Para Imprimir/Dedal_1_V3.3mf

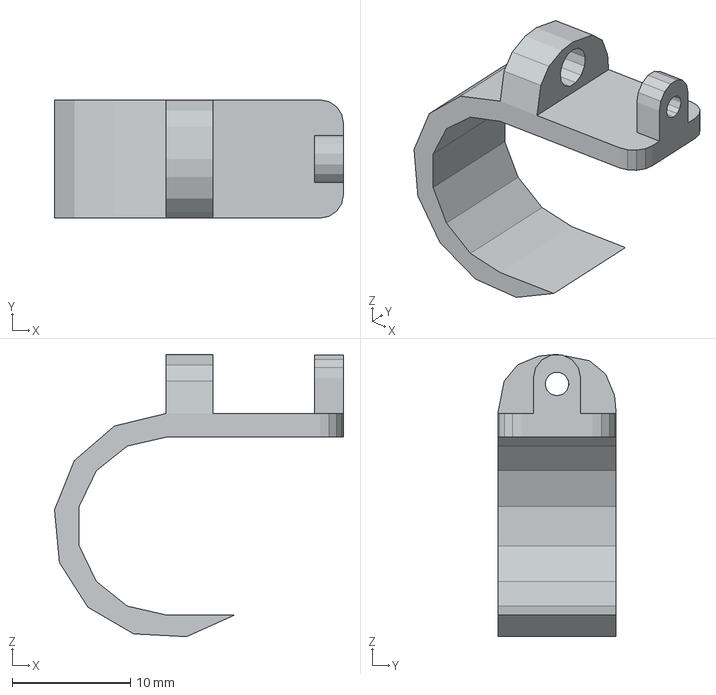
[picture p101: CAD file, 2026-10-27]
cad/Transmisor/Para Imprimir/Dedal_1_V3.3mf
24.4 x 10.0 x 23.8 mm
