sevastianamoroso/proyecto-mano/cad/Receptor/Para Imprimir/Palma_V2.3mf

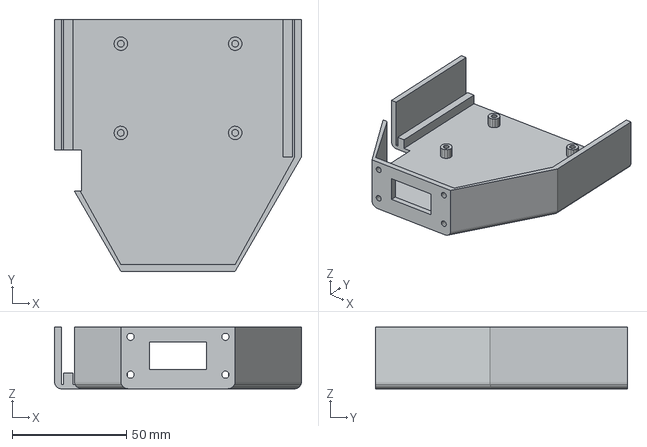
[picture p102: CAD file, 2026-10-27]
cad/Receptor/Para Imprimir/Palma_V2.3mf
108.0 x 110.0 x 27.0 mm
