sevastianamoroso/proyecto-mano/cad/Transmisor/Para Imprimir/Dedal2_Menique.3mf

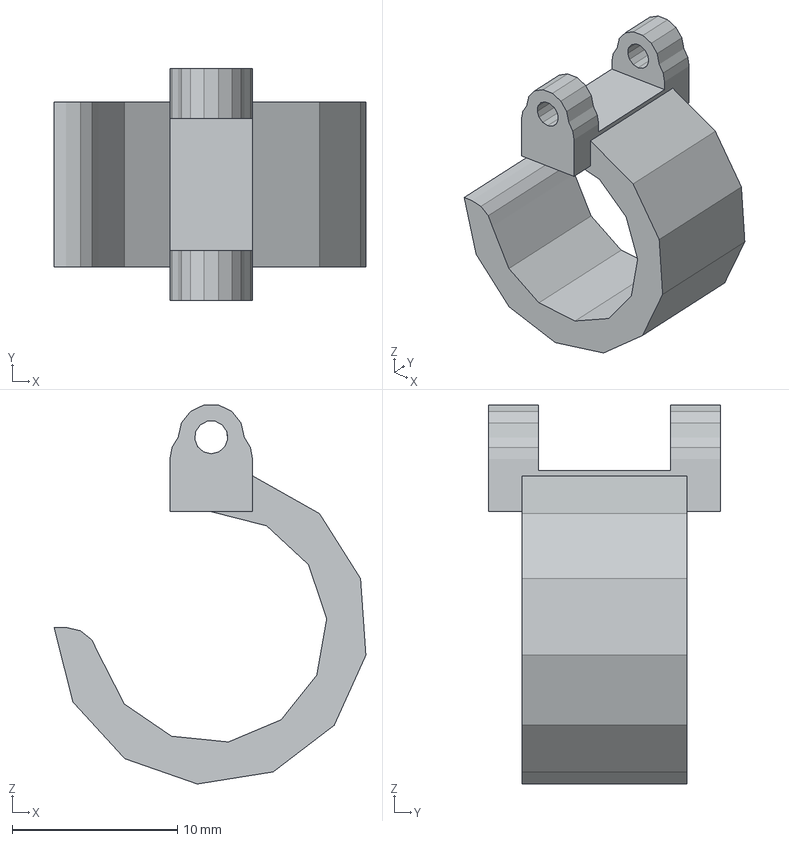
[picture p103: CAD file, 2026-10-27]
cad/Transmisor/Para Imprimir/Dedal2_Menique.3mf
18.9 x 14.0 x 22.9 mm
