sevastianamoroso/proyecto-mano/cad/Transmisor/Para Imprimir/Cajita_ESP_Prueba.3mf

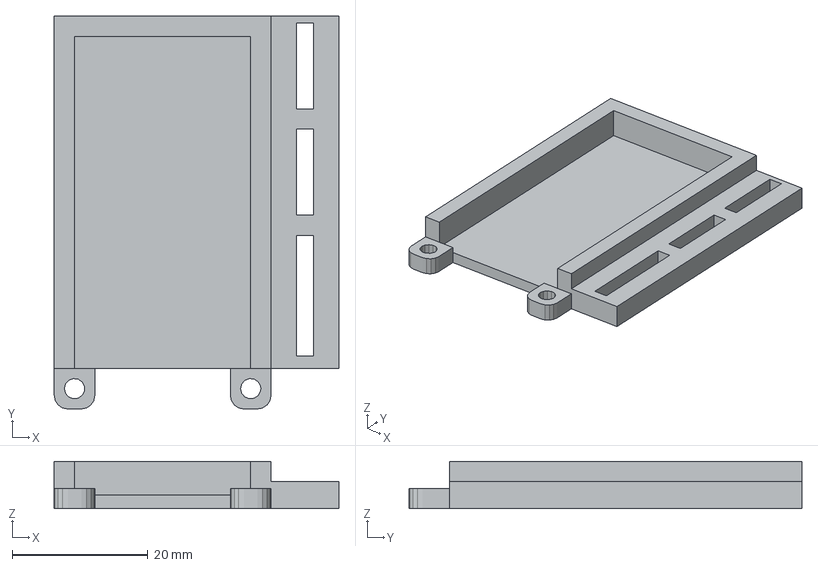
[picture p104: CAD file, 2026-10-27]
cad/Transmisor/Para Imprimir/Cajita_ESP_Prueba.3mf
42.0 x 58.0 x 7.00 mm
