sevastianamoroso/proyecto-mano/cad/Receptor/Para Imprimir/BrazoDedoIzquierdo.3mf

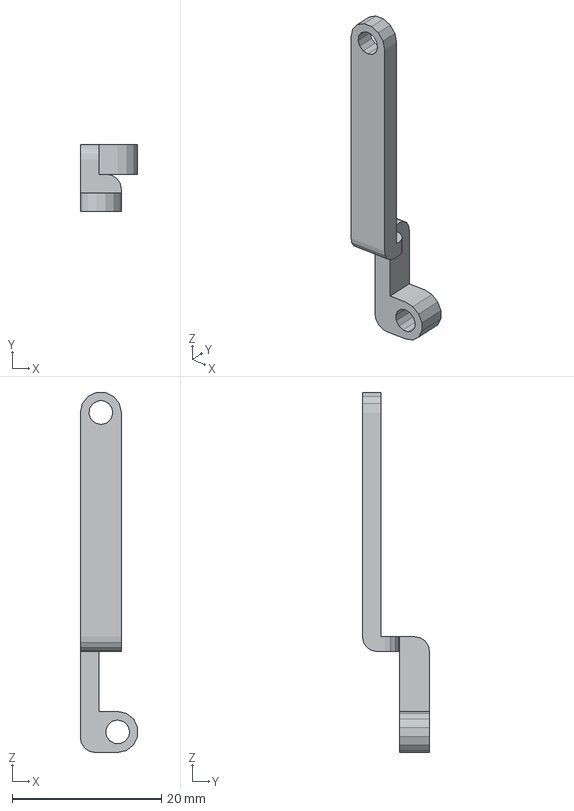
[picture p105: CAD file, 2026-10-27]
cad/Receptor/Para Imprimir/BrazoDedoIzquierdo.3mf
7.68 x 9.00 x 48.2 mm
