sevastianamoroso/proyecto-mano/cad/Transmisor/Para Imprimir/Agarre_ESP.3mf

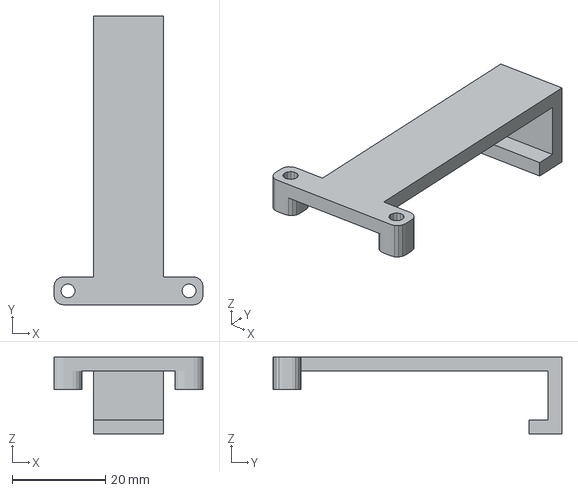
[picture p106: CAD file, 2026-10-27]
cad/Transmisor/Para Imprimir/Agarre_ESP.3mf
32.0 x 62.0 x 16.5 mm
