sevastianamoroso/proyecto-mano/cad/Receptor/Para Imprimir/BaseServo_V2.3mf

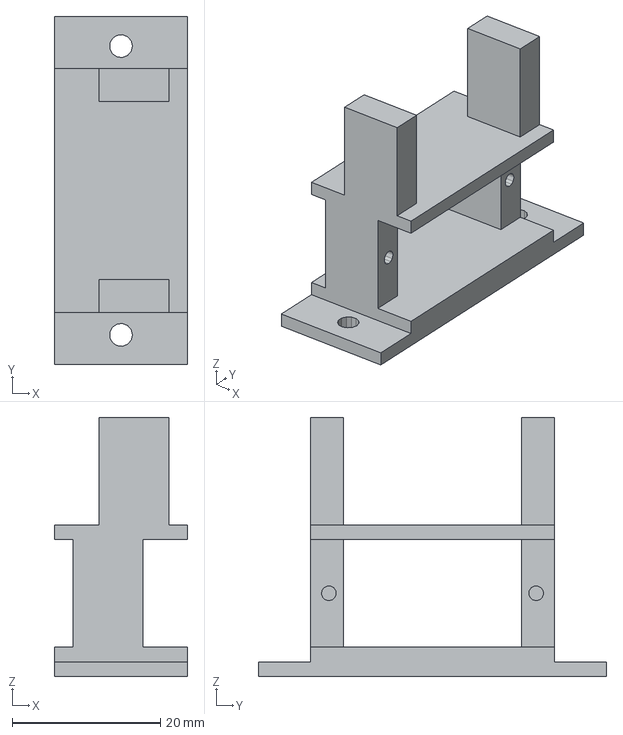
[picture p107: CAD file, 2026-10-27]
cad/Receptor/Para Imprimir/BaseServo_V2.3mf
18.0 x 47.0 x 35.0 mm
