sevastianamoroso/proyecto-mano/cad/Transmisor/Para Imprimir/Powerbank.3mf

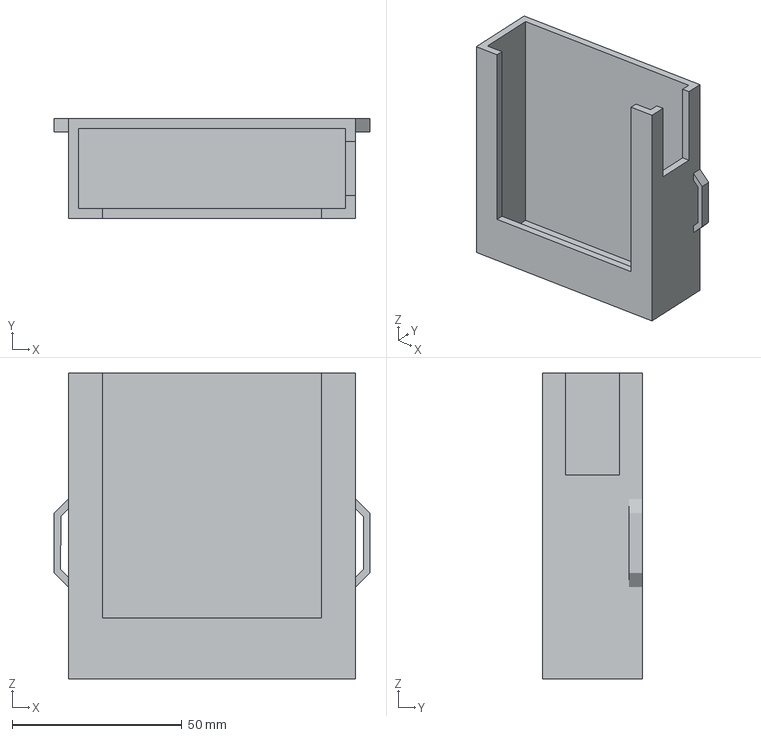
[picture p108: CAD file, 2026-10-27]
cad/Transmisor/Para Imprimir/Powerbank.3mf
93.0 x 29.5 x 90.0 mm
