sevastianamoroso/proyecto-mano/cad/Receptor/Para Imprimir/BrazoDedoPulgar.3mf

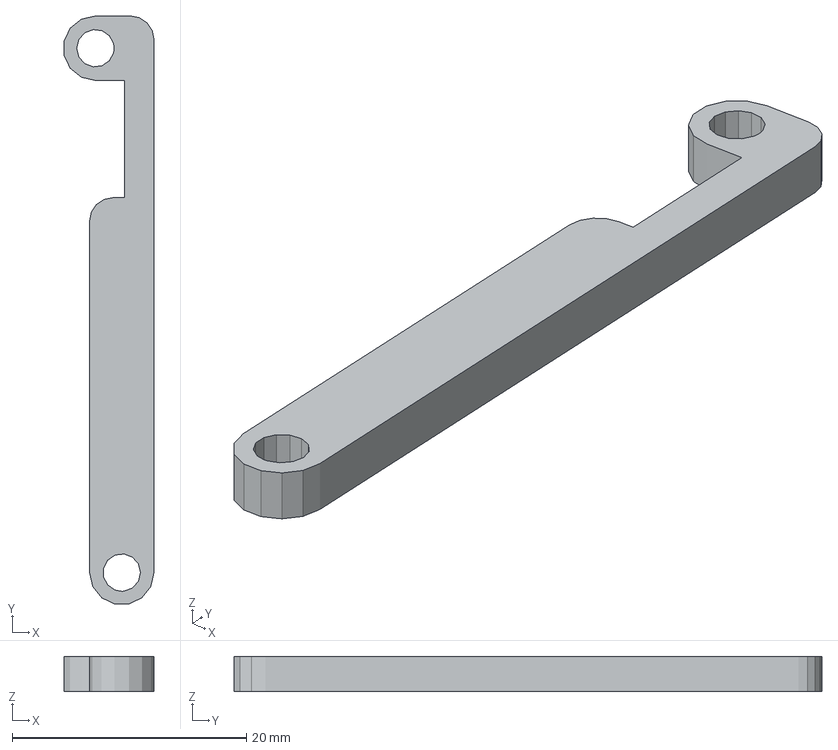
[picture p109: CAD file, 2026-10-27]
cad/Receptor/Para Imprimir/BrazoDedoPulgar.3mf
7.68 x 50.2 x 3.00 mm
