sevastianamoroso/proyecto-mano/cad/Transmisor/Para Imprimir/Pote_V2_Tapa.3mf

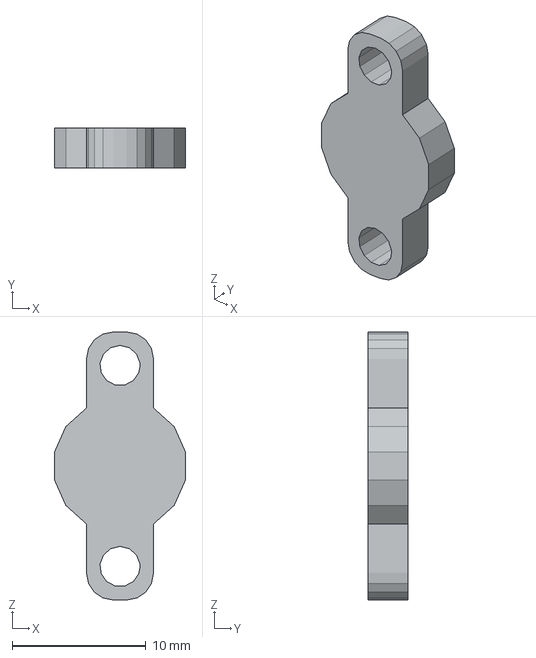
[picture p110: CAD file, 2026-10-27]
cad/Transmisor/Para Imprimir/Pote_V2_Tapa.3mf
9.78 x 3.00 x 20.0 mm
