sevastianamoroso/proyecto-mano/cad/Receptor/Para Imprimir/Base_Regulador.3mf

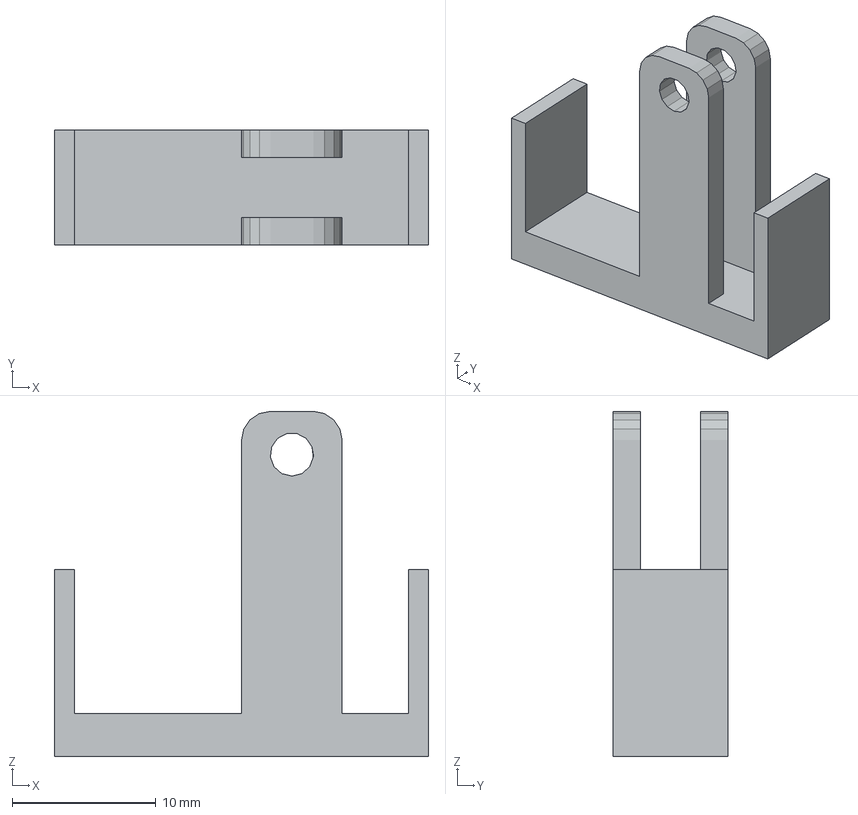
[picture p111: CAD file, 2026-10-27]
cad/Receptor/Para Imprimir/Base_Regulador.3mf
26.0 x 8.00 x 24.0 mm
