sevastianamoroso/proyecto-mano/cad/Transmisor/Para Imprimir/Dedal2_Pulgar.3mf

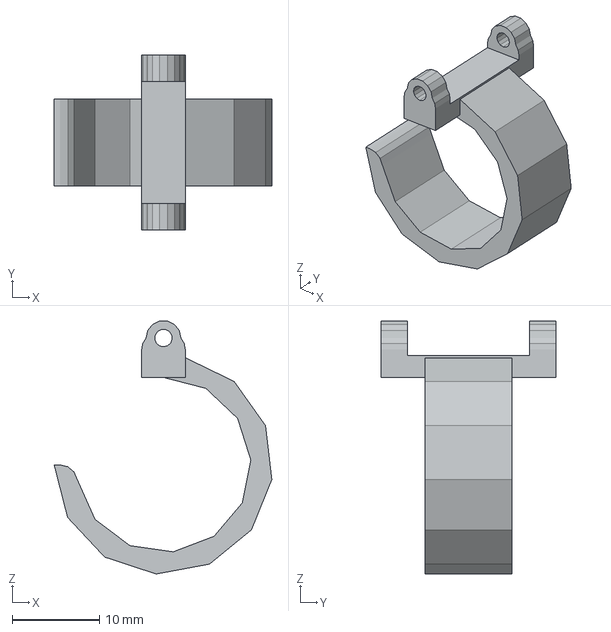
[picture p112: CAD file, 2026-10-27]
cad/Transmisor/Para Imprimir/Dedal2_Pulgar.3mf
24.9 x 20.0 x 28.9 mm
