sevastianamoroso/proyecto-mano/cad/Receptor/Para Imprimir/ManoSuperior.3mf

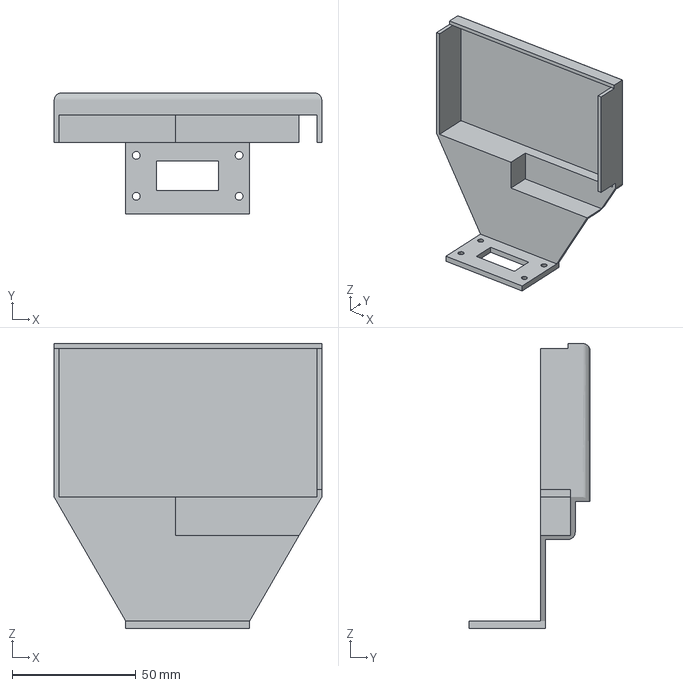
[picture p113: CAD file, 2026-10-27]
cad/Receptor/Para Imprimir/ManoSuperior.3mf
108.0 x 49.0 x 115.0 mm
