sevastianamoroso/proyecto-mano/cad/Receptor/Para Imprimir/Sosten1_1_V2.3mf

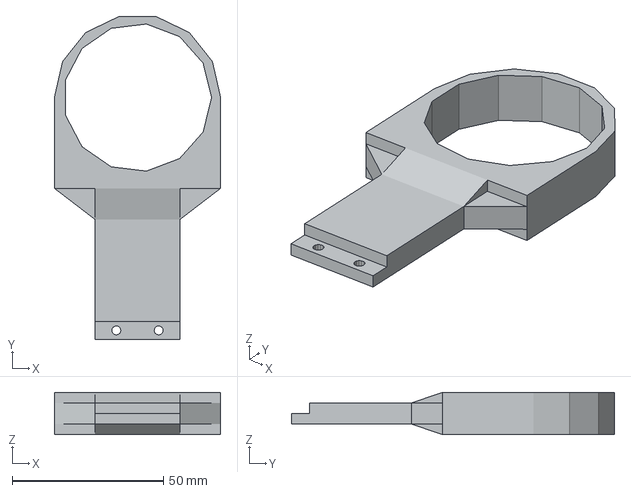
[picture p114: CAD file, 2026-10-27]
cad/Receptor/Para Imprimir/Sosten1_1_V2.3mf
55.0 x 106.8 x 14.0 mm
