sevastianamoroso/proyecto-mano/cad/Transmisor/Para Imprimir/Dedal3_Pulgar_V2.3mf

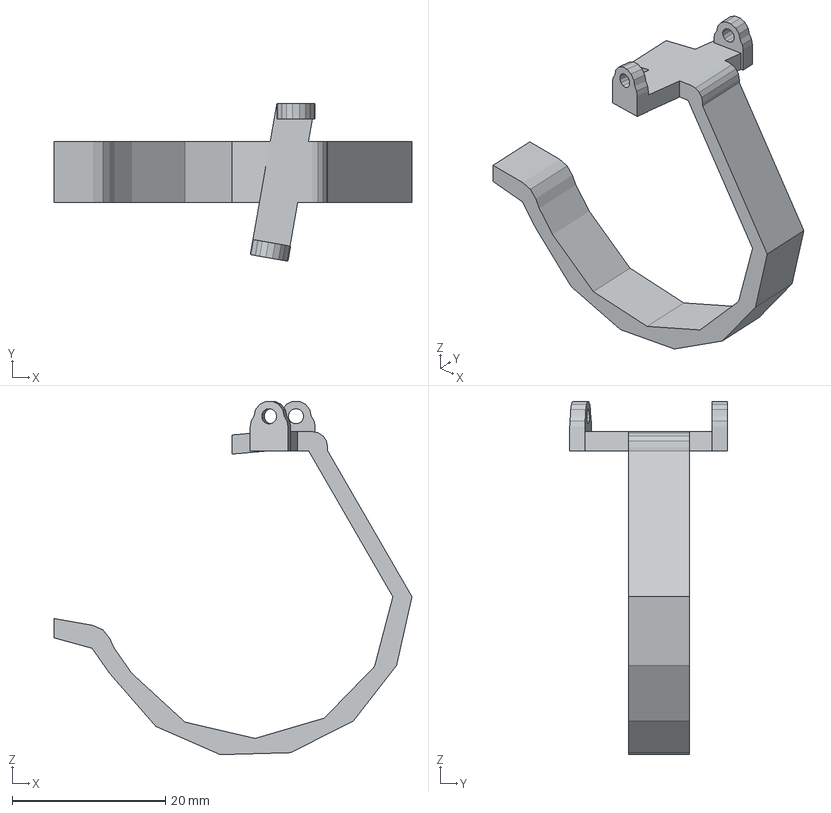
[picture p115: CAD file, 2026-10-27]
cad/Transmisor/Para Imprimir/Dedal3_Pulgar_V2.3mf
46.7 x 20.6 x 46.1 mm
