sevastianamoroso/proyecto-mano/cad/Receptor/Para Imprimir/BrazoDedoDerecho.3mf

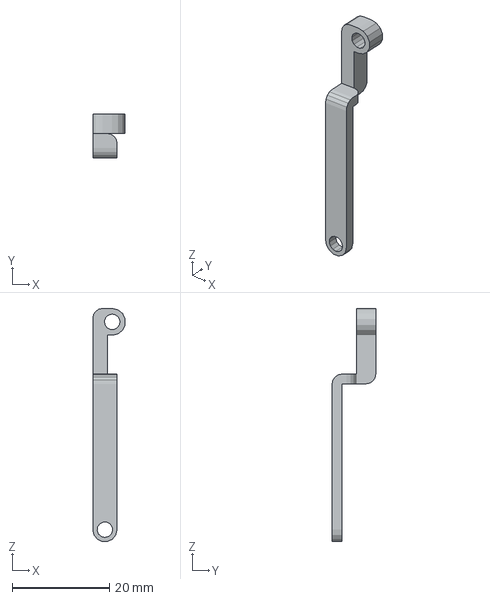
[picture p116: CAD file, 2026-10-27]
cad/Receptor/Para Imprimir/BrazoDedoDerecho.3mf
6.68 x 9.00 x 47.9 mm
