sevastianamoroso/proyecto-mano/cad/Receptor/Para Imprimir/Dedo.3mf

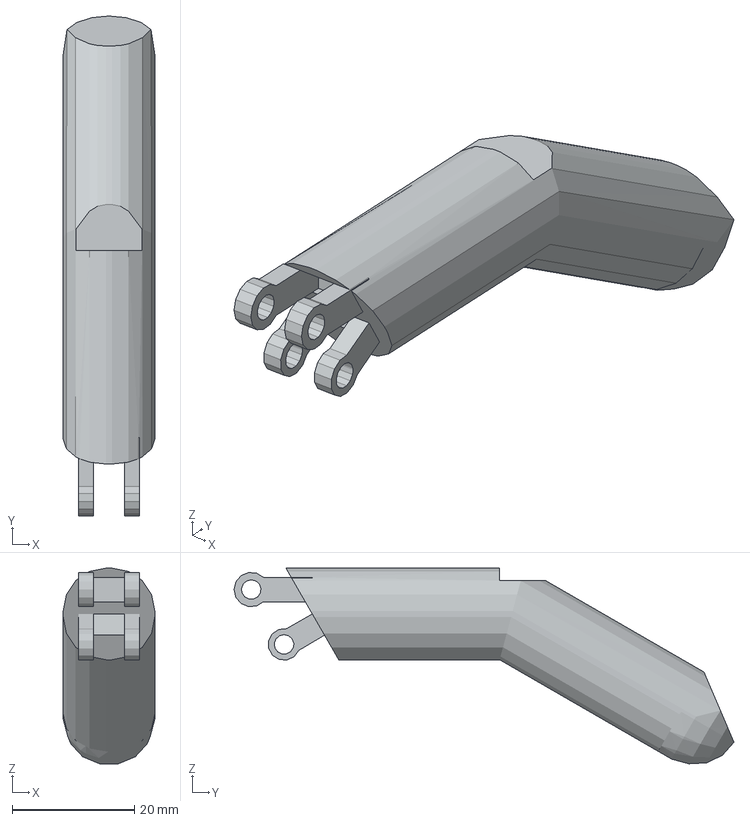
[picture p117: CAD file, 2026-10-27]
cad/Receptor/Para Imprimir/Dedo.3mf
15.0 x 81.9 x 32.0 mm
