sevastianamoroso/proyecto-mano/cad/Receptor/Para Imprimir/Sosten_2_2.3mf

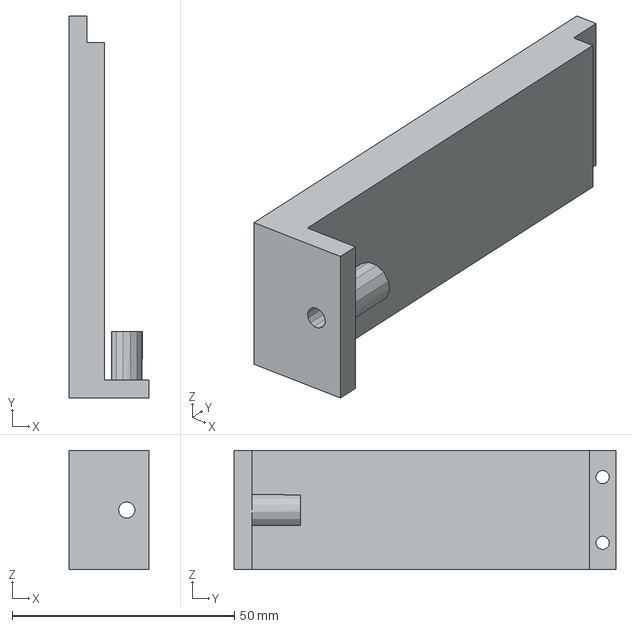
[picture p118: CAD file, 2026-10-27]
cad/Receptor/Para Imprimir/Sosten_2_2.3mf
18.0 x 86.0 x 26.8 mm
