sevastianamoroso/proyecto-mano/(list of files, cad)

Other CAD files:
cad/Receptor/Para Imprimir/AgarrePlaca_2.3mf
cad/Transmisor/Para Imprimir/Dedal2_Pulgar_V2.3mf
cad/Transmisor/Para Imprimir/Dedal_1_V2.3mf
