sevastianamoroso/proyecto-mano/docs/pruebas/evidencia/2026-10-15/P02_mov_200mVdiv.png

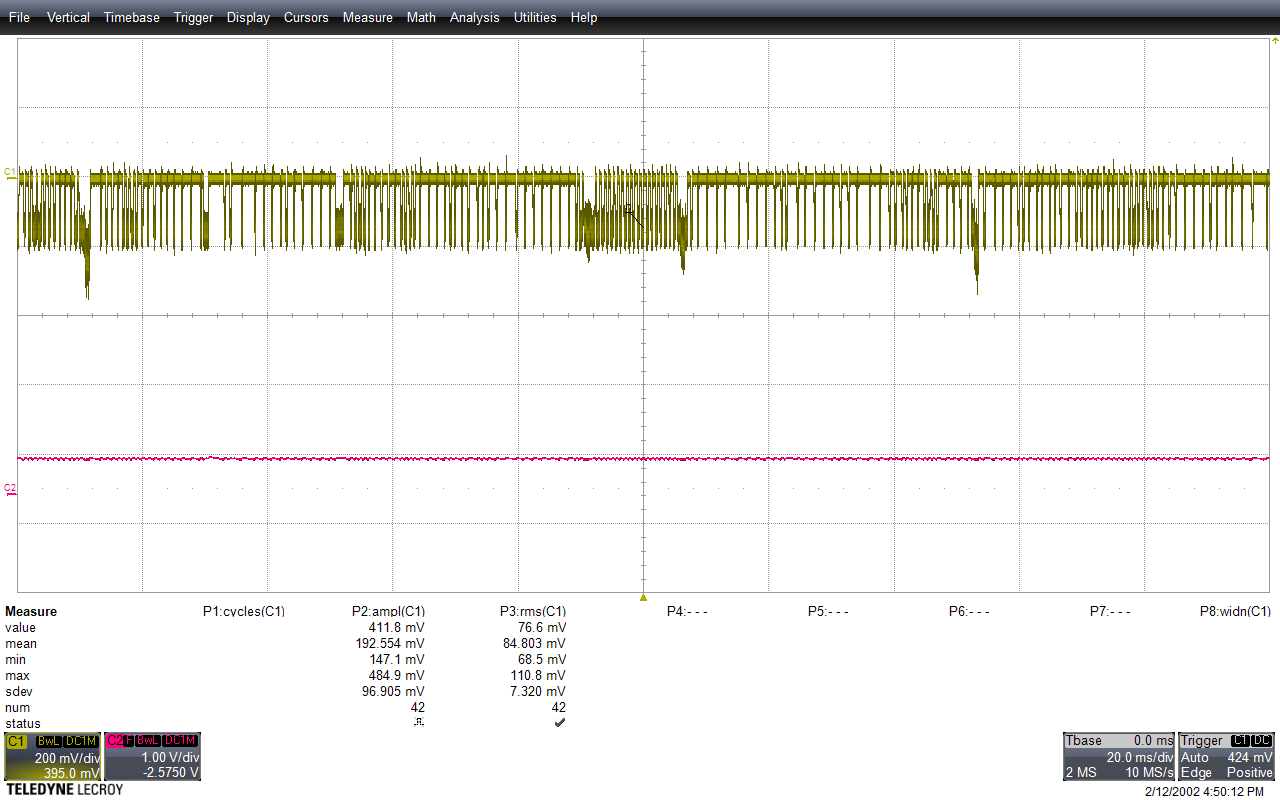
docs/pruebas/evidencia/2026-10-15/P02_mov_200mVdiv.png
