sevastianamoroso/proyecto-mano/docs/pruebas/evidencia/2026-10-15/P02_reposo.png

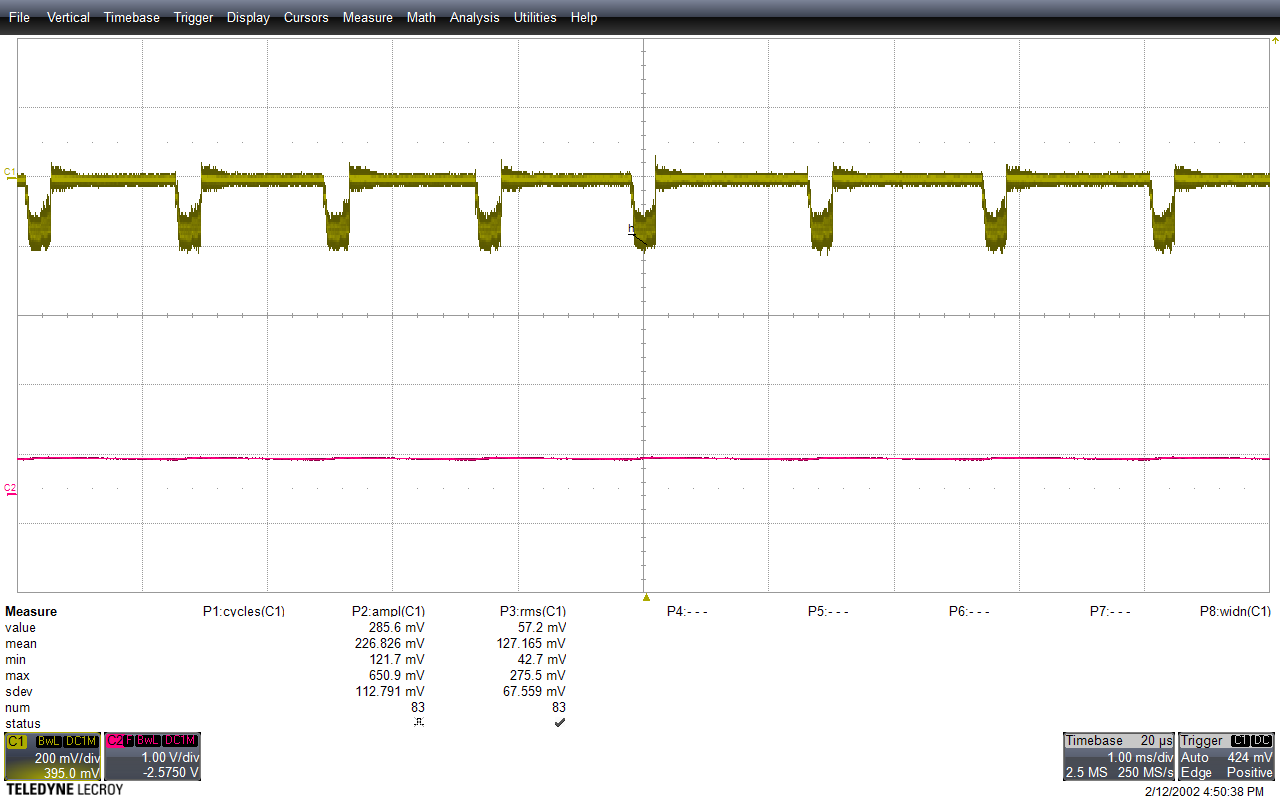
docs/pruebas/evidencia/2026-10-15/P02_reposo.png
