sevastianamoroso/proyecto-mano/docs/pruebas/evidencia/2026-10-15/P03_servo_bloqueado.png

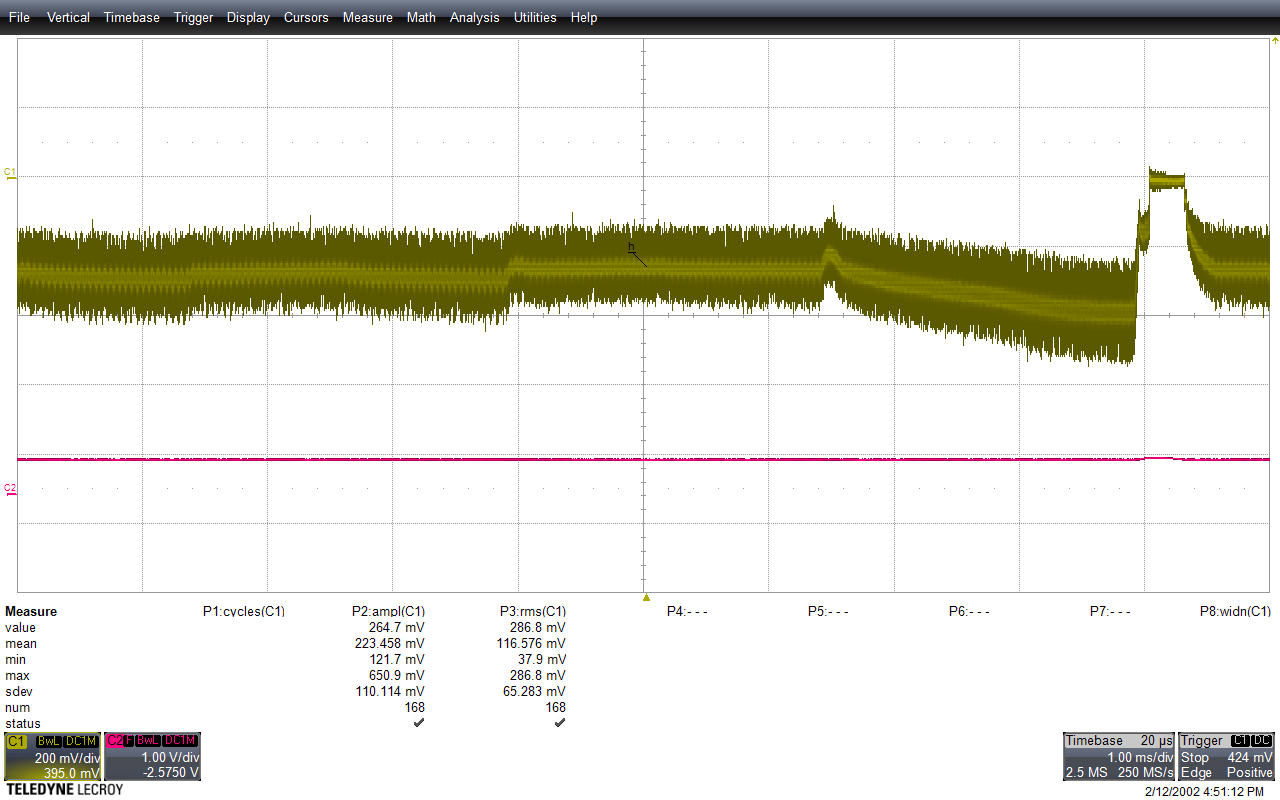
docs/pruebas/evidencia/2026-10-15/P03_servo_bloqueado.png
