sevastianamoroso/proyecto-mano/docs/pruebas/evidencia/2026-10-15/P16_matlab_indice.jpg

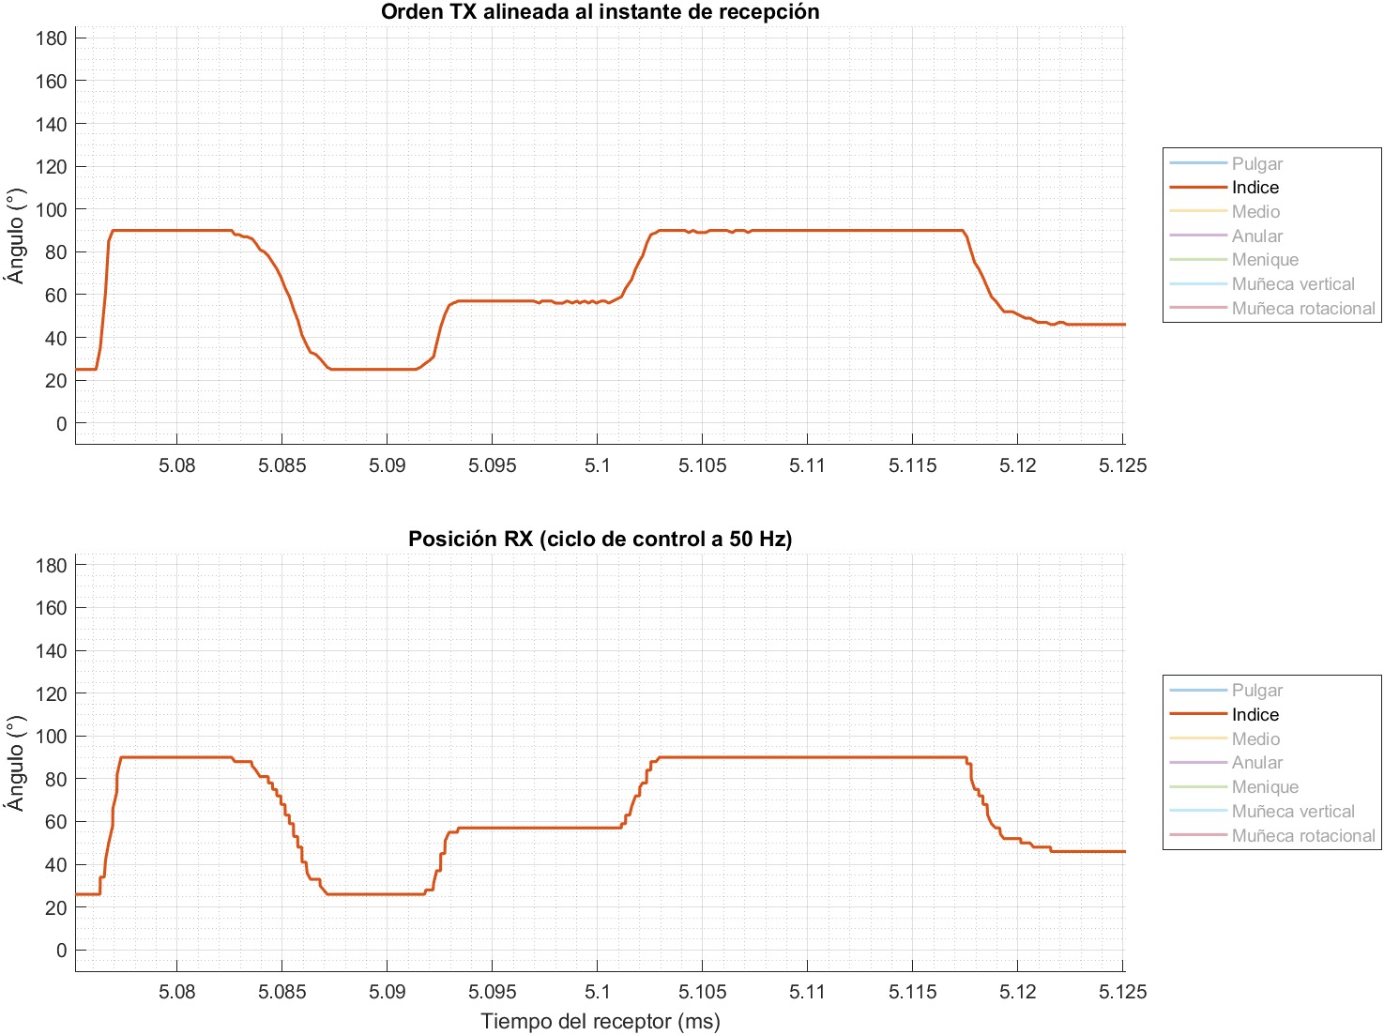
docs/pruebas/evidencia/2026-10-15/P16_matlab_indice.jpg
