sevastianamoroso/proyecto-mano/docs/pruebas/evidencia/2026-10-26_latencia/P11_serial_plotter_medias.jpeg

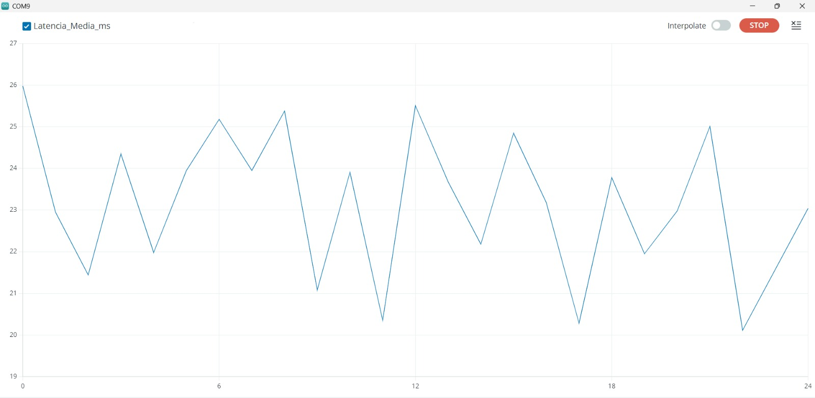
docs/pruebas/evidencia/2026-10-26_latencia/P11_serial_plotter_medias.jpeg
