sevastianamoroso/proyecto-mano/informe/Imagenes/Mediciones/P11_latencia_bloques.pdf

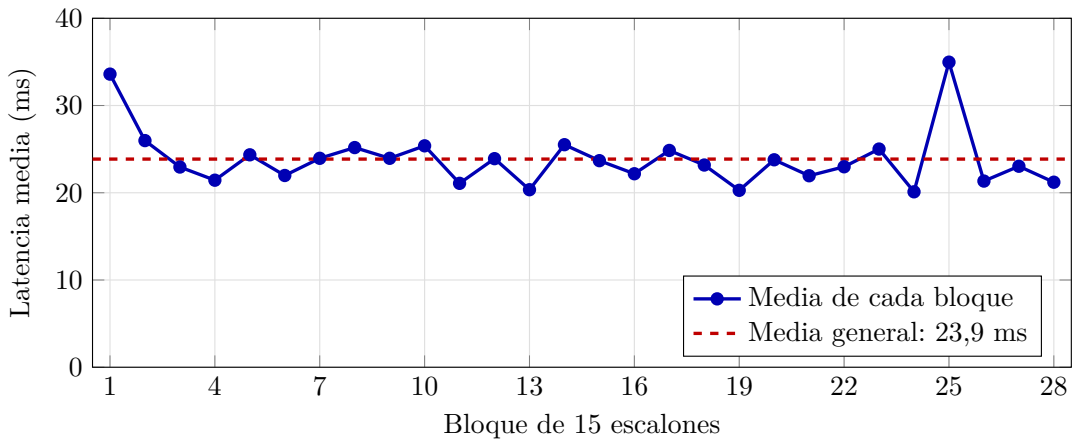
[picture p125: page 1]

Latencia media (ms)

Media de cada bloque
Media general: 23,9 ms

Bloque de 15 escalones
