sevastianamoroso/proyecto-mano/docs/pruebas/evidencia/2026-10-26_latencia/Receptor_Latencia_plotter_littlefs.ino

/**
 * @file Receptor_Latencia.ino
 * @brief Receptor.ino + medición de latencia de punta a punta (versión 2 del método)
 *
 * Es una copia de Receptor/Receptor.ino. Todo lo agregado está marcado con [LATENCIA];
 * el resto (recepción, cola, FSM, slew-rate, banda muerta, failsafe) no se tocó.
 * El transmisor usa su firmware normal (Transmisor/Transmisor.ino), sin cambios.
 *
 * Idea: el receptor genera un escalón eléctrico que reemplaza al potenciómetro del índice
 * en el guante y mide cuánto tarda en cambiar el pulso PWM que recibe el servo del índice.
 * El inicio y el fin se toman con el reloj de esta placa, así que no hay que sincronizar nada.
 *
 * Conexiones:
 *    Rx GPIO 18 ──[1 kΩ]──  Tx GPIO 34   (cursor del potenciómetro del índice DESCONECTADO)
 *    Rx GPIO 26 ──────────  Rx GPIO 4    (puente: la señal del servo del índice vuelve a entrar)
 *    Rx GND     ──────────  Tx GND
 *
 * Por cada escalón imprime una línea:
 *    L,n,nivel,secuencia,llegada_us,primer_us,final_us,pulsos_perdidos
 *      llegada_us: escalón -> primer paquete que lo trae, validado en el callback
 *      primer_us:  escalón -> fin del primer pulso PWM con el ancho cambiado (punta a punta)
 *      final_us:   escalón -> fin del primer pulso con el ancho final (incluye el slew-rate)
 *    T,n,nivel,etapa   si el ensayo no terminó en 1 s (etapa 0: no llegó el paquete,
 *                      1: llegó pero el PWM no cambió, 2: el PWM no se estabilizó)
 * Comandos por el monitor serie: 's' resumen, 'r' borrar estadísticas, 'p' pausar/reanudar,
 *                                'd' volcar/descargar mediciones.txt, 'b' borrar mediciones.txt.
 */

#include <Arduino.h>
#include <WiFi.h>
#include <esp_now.h>
#include <esp_idf_version.h>
#include <ESP32Servo.h>
#include <LittleFS.h>

#include "ProtocoloBrazo.h"

// ==========================================
// [LATENCIA] CONFIGURACIÓN DE LA PRUEBA Y SERIAL PLOTTER
// ==========================================
const int DEDO_PRUEBA     = DEDO_INDICE; // su potenciómetro se reemplaza por el escalón
const int PIN_ESTIMULO    = 18;          // salida hacia el GPIO 34 del Tx
const int PIN_CAPTURA_PWM = 4;           // entrada, puenteada con el GPIO 26 (servo del índice)

// Configuración para Serial Plotter:
// true:  Emite ÚNICAMENTE la media para graficar en tiempo real en Serial Plotter ("Latencia_Media_ms:XX.XX")
// false: Emite tramas CSV detalladas "L,..." para análisis en MATLAB o terminal
const bool MODO_SERIAL_PLOTTER = true;

// Cantidad de muestras para promediar (por defecto 15)
const int  MUESTRAS_PROMEDIO   = 15;

// Tipo de promedio:
// false = Por bloques (espera 15 muestras, calcula e imprime la media, y reinicia el acumulador)
// true  = Media móvil (ventana deslizante de las últimas 15 muestras, actualiza con cada ensayo)
const bool USAR_MEDIA_MOVIL    = false;

const float    UMBRAL_PAQUETE_DEG = 3.0f;  // cambio en el paquete que cuenta como llegada (> banda muerta)
const uint32_t UMBRAL_CAMBIO_US   = 30;    // cambio de ancho que cuenta como orden nueva (1° ≈ 10,6 µs)
const uint32_t UMBRAL_QUIETO_US   = 8;     // diferencia máxima entre pulsos para decir que no cambió
const int      PULSOS_QUIETO      = 5;     // pulsos iguales seguidos para dar la orden por establecida
const uint32_t TIMEOUT_ENSAYO_MS  = 1000;
const uint32_t ESPERA_MIN_MS      = 200;   // espera aleatoria entre ensayos, para que el escalón caiga
const uint32_t ESPERA_MAX_MS      = 600;   // en cualquier punto del ciclo de 20 ms del Tx
const int      MAX_MUESTRAS       = 2000;  // para el resumen por el monitor serie

portMUX_TYPE muxLatencia = portMUX_INITIALIZER_UNLOCKED;

// Escritas por la ISR de captura PWM
volatile uint32_t tUltimoFlancoUs = 0;
volatile uint32_t anchoPulsoUs    = 0;  // ancho del último pulso completo
volatile uint32_t finPulsoUs      = 0;  // instante de su flanco de bajada
volatile uint32_t contadorPulsos  = 0;

// Escritas por el callback de ESP-NOW
volatile uint16_t ultimoValorDedo  = 0;
volatile bool     ensayoArmado     = false;
volatile uint16_t valorDedoAntes   = 0;
volatile bool     llegoEscalon     = false;
volatile uint32_t llegadaUs        = 0;
volatile uint8_t  secuenciaLlegada = 0;

// El pulso alto dura 0,5–2,4 ms y el bajo más de 17 ms: un intervalo corto entre flancos
// es un pulso que acaba de terminar. Así no hace falta leer el nivel del pin.
void IRAM_ATTR isrCapturaPwm() {
    uint32_t ahora = micros();
    uint32_t dt = ahora - tUltimoFlancoUs;
    tUltimoFlancoUs = ahora;
    if (dt < 3000) {
        portENTER_CRITICAL_ISR(&muxLatencia);
        anchoPulsoUs = dt;
        finPulsoUs = ahora;
        contadorPulsos++;
        portEXIT_CRITICAL_ISR(&muxLatencia);
    }
}

// ==========================================
// CONFIGURACIÓN DE PINES DE SERVOMOTORES
// ==========================================
const int PIN_SERVO_PULGAR        = 25;
const int PIN_SERVO_INDICE        = 26;
const int PIN_SERVO_MEDIO         = 27;
const int PIN_SERVO_ANULAR        = 23; // Antes GPIO 12 (strapping): el dedo se movía con dificultad
const int PIN_SERVO_MENIQUE       = 13;
const int PIN_SERVO_MUNIECA_VERT  = 32;
const int PIN_SERVO_MUNIECA_ROT   = 33;

const int PINES_SERVOS_DEDOS[TOTAL_DEDOS] = {
    PIN_SERVO_PULGAR, PIN_SERVO_INDICE, PIN_SERVO_MEDIO,
    PIN_SERVO_ANULAR, PIN_SERVO_MENIQUE
};

// ==========================================
// PARÁMETROS CINEMÁTICOS Y DE CONTROL
// ==========================================
// Período de actualización del lazo de actuación (50 Hz = 20 ms)
const TickType_t PERIODO_CONTROL_MS = 20;

// Timeout para detección de pérdida de enlace (ms)
const uint32_t TIMEOUT_FAILSAFE_MS = 250;

// Banda muerta angular para supresión de jitter/hunting (grados)
const float DEADBAND_DEDOS   = 1.0f;
const float DEADBAND_MUNIECA = 1.2f;

// Velocidad angular máxima permitida por ciclo (Slew-Rate Limiting a 50 Hz)
// SG90 (dedos): 8.0° / 20ms = 400°/segundo (el SG90 sin carga llega a ~600°/s)
const float VEL_MAX_DEDOS = 8.0f;
// MG946R (muñeca vertical - mayor inercia y carga): 4.0° / 20ms = 200°/segundo
const float VEL_MAX_MUNIECA_VERT = 4.0f;
// MG946R (muñeca rotacional): 5.0° / 20ms = 250°/segundo
const float VEL_MAX_MUNIECA_ROT = 5.0f;

// Sentido de montaje de cada servo de dedo (pulgar..meñique).
// true = el servo cierra el dedo al BAJAR el ángulo: se espeja dentro de 25..90°.
// Ajustar por dedo en la prueba C3: con la mano del guante abierta, el dedo robot debe quedar abierto.
const bool INVERTIR_DEDO[TOTAL_DEDOS] = {true, true, true, true, true};

// Posiciones neutras de reposo seguro (Home)
const float HOME_DEDOS        = 25.0f; // Mano abierta relajada
const float HOME_MUNIECA_VERT = 57.0f; // Posición media horizontal
const float HOME_MUNIECA_ROT  = 90.0f; // Muñeca en ángulo neutro

// Límites mecánicos absolutos (protección de la mano 3D ante paquetes fuera de rango)
const float LIM_DEDOS_MIN = 25.0f,        LIM_DEDOS_MAX = 90.0f;
const float LIM_MUNIECA_VERT_MIN = 25.0f, LIM_MUNIECA_VERT_MAX = 90.0f;
const float LIM_MUNIECA_ROT_MIN = 0.0f,   LIM_MUNIECA_ROT_MAX = 180.0f;

// Ángulo lógico del dedo (25 = abierto, 90 = cerrado) -> ángulo físico del servo
static inline int anguloServoDedo(int i, float pos) {
    return (int)round(INVERTIR_DEDO[i] ? (LIM_DEDOS_MIN + LIM_DEDOS_MAX - pos) : pos);
}

// ==========================================
// MÁQUINA DE ESTADOS FINITOS (FSM)
// ==========================================
enum EstadoSistema {
    ESTADO_ESPERANDO_SYNC,
    ESTADO_OPERACION_NORMAL,
    ESTADO_FAILSAFE_SIN_SENAL
};

// ==========================================
// OBJETOS Y VARIABLES DE CONTROL
// ==========================================
Servo servoDedos[TOTAL_DEDOS];
Servo servoMuniecaVert;
Servo servoMuniecaRot;

// Cola FreeRTOS para desacoplamiento seguro de datos de radio
QueueHandle_t colaMensajesBrazo = NULL;

// Posiciones angulares actuales y objetivos (con punto flotante para integración suave)
float posActualDedos[TOTAL_DEDOS];
float posObjetivoDedos[TOTAL_DEDOS];

float posActualMuniecaVert  = HOME_MUNIECA_VERT;
float posObjetivoMuniecaVert = HOME_MUNIECA_VERT;

float posActualMuniecaRot   = HOME_MUNIECA_ROT;
float posObjetivoMuniecaRot  = HOME_MUNIECA_ROT;

EstadoSistema estadoActual = ESTADO_ESPERANDO_SYNC;
uint32_t marcaTiempoUltimoPaquete = 0;
bool servosAcoplados = false;

// Prototipos de funciones
void acoplarServos();
void desacoplarServos();
void tareaControlActuadores(void* pvParameters);

// ==========================================
// CALLBACK DE ESP-NOW (Rx) - EJECUTADO EN CORE 0
// ==========================================
#if ESP_IDF_VERSION >= ESP_IDF_VERSION_VAL(5, 0, 0)
void OnDataRecv(const esp_now_recv_info_t *esp_now_info, const uint8_t *incomingData, int len) {
#else
void OnDataRecv(const uint8_t* mac, const uint8_t* incomingData, int len) {
#endif
    if (len != sizeof(MensajeBrazo)) {
        return; // Descartar tramas con tamaño incorrecto
    }

    const MensajeBrazo* paquete = reinterpret_cast<const MensajeBrazo*>(incomingData);

    // Validación formal de cabecera mágica y suma de verificación
    if (!validarPaqueteBrazo(*paquete)) {
        return; // Trama corrompida por RF descartada
    }

    // [LATENCIA] Primer paquete que ya trae el escalón del dedo de prueba
    uint32_t ahoraUs = micros();
    uint16_t valor = paquete->anguloDedos[DEDO_PRUEBA];
    portENTER_CRITICAL(&muxLatencia);
    ultimoValorDedo = valor;
    if (ensayoArmado && !llegoEscalon &&
        abs((int)valor - (int)valorDedoAntes) >= UMBRAL_PAQUETE_DEG) {
        llegadaUs = ahoraUs;
        secuenciaLlegada = paquete->secuencia;
        llegoEscalon = true;
    }
    portEXIT_CRITICAL(&muxLatencia);

    // Transferencia thread-safe a la cola de FreeRTOS sin esperas bloqueantes
    if (colaMensajesBrazo != NULL) {
        BaseType_t xHigherPriorityTaskWoken = pdFALSE;
        // Sobreescribir el valor en cola si el consumidor aún no lo procesó
        xQueueOverwriteFromISR(colaMensajesBrazo, paquete, &xHigherPriorityTaskWoken);
        portYIELD_FROM_ISR(xHigherPriorityTaskWoken);
    }
}

// ==========================================
// GESTIÓN DE ATTACH / DETACH DE SERVOS
// ==========================================
void acoplarServos() {
    if (servosAcoplados) return;

    for (int i = 0; i < TOTAL_DEDOS; i++) {
        servoDedos[i].setPeriodHertz(50);
        servoDedos[i].attach(PINES_SERVOS_DEDOS[i], 500, 2400);
        servoDedos[i].write(anguloServoDedo(i, posActualDedos[i]));
    }

    servoMuniecaVert.setPeriodHertz(50);
    servoMuniecaVert.attach(PIN_SERVO_MUNIECA_VERT, 500, 2400);
    servoMuniecaVert.write((int)round(posActualMuniecaVert));

    servoMuniecaRot.setPeriodHertz(50);
    servoMuniecaRot.attach(PIN_SERVO_MUNIECA_ROT, 500, 2400);
    servoMuniecaRot.write((int)round(posActualMuniecaRot));

    servosAcoplados = true;
    if (!MODO_SERIAL_PLOTTER) Serial.println("[SERVOS] PWM habilitado y actuadores acoplados.");
}

void desacoplarServos() {
    if (!servosAcoplados) return;

    for (int i = 0; i < TOTAL_DEDOS; i++) {
        servoDedos[i].detach();
    }
    servoMuniecaVert.detach();
    servoMuniecaRot.detach();

    servosAcoplados = false;
    if (!MODO_SERIAL_PLOTTER) Serial.println("[SERVOS] Actuadores desacoplados (Sleep Mode / Ahorro Térmico).");
}

// ==========================================
// SETUP
// ==========================================
void setup() {
    Serial.begin(115200);
    delay(500);
    if (!MODO_SERIAL_PLOTTER) {
        Serial.println("\n[SISTEMA] Iniciando Receptor y Controlador Cinemático...");
    }

    // [LATENCIA] Escalón hacia el Tx y captura del PWM del servo del índice
    pinMode(PIN_ESTIMULO, OUTPUT);
    digitalWrite(PIN_ESTIMULO, LOW);
    pinMode(PIN_CAPTURA_PWM, INPUT);
    attachInterrupt(digitalPinToInterrupt(PIN_CAPTURA_PWM), isrCapturaPwm, CHANGE);
    if (!MODO_SERIAL_PLOTTER) {
        Serial.printf("[LATENCIA] Estímulo en GPIO %d, captura PWM en GPIO %d (puente desde GPIO %d)\n",
                      PIN_ESTIMULO, PIN_CAPTURA_PWM, PINES_SERVOS_DEDOS[DEDO_PRUEBA]);
        Serial.println("# L,n,nivel,secuencia,llegada_us,primer_us,final_us,pulsos_perdidos");
    }

    // [LITTLEFS] Inicializar memoria Flash interna para almacenar mediciones en /mediciones.txt
    if (!LittleFS.begin(true)) {
        if (!MODO_SERIAL_PLOTTER) Serial.println("[LittleFS] Error al montar memoria Flash.");
    } else {
        if (!MODO_SERIAL_PLOTTER) Serial.println("[LittleFS] Memoria Flash montada (/mediciones.txt listo).");
    }

    // Inicializar posiciones en Home seguro
    for (int i = 0; i < TOTAL_DEDOS; i++) {
        posActualDedos[i]   = HOME_DEDOS;
        posObjetivoDedos[i] = HOME_DEDOS;
    }
    posActualMuniecaVert   = HOME_MUNIECA_VERT;
    posObjetivoMuniecaVert = HOME_MUNIECA_VERT;
    posActualMuniecaRot    = HOME_MUNIECA_ROT;
    posObjetivoMuniecaRot  = HOME_MUNIECA_ROT;

    // Asignación de temporizadores de hardware LEDC para ESP32Servo
    ESP32PWM::allocateTimer(0);
    ESP32PWM::allocateTimer(1);
    ESP32PWM::allocateTimer(2);
    ESP32PWM::allocateTimer(3);

    // Acoplar servos en posición neutra
    acoplarServos();

    // Crear cola de mensajes (longitud 1 con capacidad de sobreescritura)
    colaMensajesBrazo = xQueueCreate(1, sizeof(MensajeBrazo));
    if (colaMensajesBrazo == NULL) {
        Serial.println("[ERROR FATAL] No se pudo crear la cola FreeRTOS.");
        while (1) delay(1000);
    }

    // Inicializar Radio Wi-Fi y ESP-NOW
    WiFi.mode(WIFI_STA);
    WiFi.setSleep(false); // Sin ahorro de energía del modem: evita latencia/pérdida en la recepción
    if (!MODO_SERIAL_PLOTTER) {
        Serial.print("[INFO] Dirección MAC Receptora: ");
        Serial.println(WiFi.macAddress());
    }

    if (esp_now_init() != ESP_OK) {
        Serial.println("[ERROR FATAL] Fallo en la inicialización de ESP-NOW.");
        return;
    }

#if ESP_IDF_VERSION >= ESP_IDF_VERSION_VAL(5, 0, 0)
    esp_now_register_recv_cb(OnDataRecv);
#else
    esp_now_register_recv_cb((esp_now_recv_cb_t)OnDataRecv);
#endif
    if (!MODO_SERIAL_PLOTTER) Serial.println("[ESP-NOW] Receptor a la escucha de paquetes...");

    // Crear Tarea de Control y Actuación en Núcleo 1 (independiente de RF en Core 0)
    xTaskCreatePinnedToCore(
        tareaControlActuadores,
        "TaskServoControl",
        4096,
        NULL,
        3, // Alta prioridad de control en Core 1
        NULL,
        1
    );
}

// ==========================================
// TAREA DE TIEMPO REAL: CONTROL Y SLEW-RATE
// ==========================================
void tareaControlActuadores(void* pvParameters) {
    MensajeBrazo paqueteEntrante;
    uint32_t ticksTelemetria = 0;
    uint32_t tiempoEnHomeMs = 0;

    for (;;) {
        // 1. ESPERAR UN PAQUETE: la tarea despierta apenas llega (sin esperar al próximo tick
        // de 50 Hz). Sin paquetes, el timeout mantiene el ciclo a 50 Hz para failsafe y trayectoria.
        // ponytail: el slew es por iteración y el Tx manda a 50 Hz; si se sube la tasa del Tx,
        // escalar VEL_MAX_* por el dt real.
        if (xQueueReceive(colaMensajesBrazo, &paqueteEntrante, pdMS_TO_TICKS(PERIODO_CONTROL_MS)) == pdTRUE) {
            marcaTiempoUltimoPaquete = millis();

            // Si estábamos desconectados o esperando sync, pasar a operación normal
            if (estadoActual != ESTADO_OPERACION_NORMAL) {
                estadoActual = ESTADO_OPERACION_NORMAL;
                acoplarServos();
                if (!MODO_SERIAL_PLOTTER) Serial.printf("[FSM] Enlace establecido. Paquete #%u recibido.\n", paqueteEntrante.secuencia);
            }

            // Actualizar referencias objetivo
            for (int i = 0; i < TOTAL_DEDOS; i++) {
                posObjetivoDedos[i] = constrain((float)paqueteEntrante.anguloDedos[i], LIM_DEDOS_MIN, LIM_DEDOS_MAX);
            }
            posObjetivoMuniecaVert = constrain((float)paqueteEntrante.muniecaVertical, LIM_MUNIECA_VERT_MIN, LIM_MUNIECA_VERT_MAX);
            posObjetivoMuniecaRot  = constrain((float)paqueteEntrante.muniecaRotacional, LIM_MUNIECA_ROT_MIN, LIM_MUNIECA_ROT_MAX);
        }

        // 2. DETECCIÓN DE TIMEOUT Y SUPERVISIÓN DE FAILSAFE
        if (estadoActual == ESTADO_OPERACION_NORMAL) {
            if (millis() - marcaTiempoUltimoPaquete > TIMEOUT_FAILSAFE_MS) {
                estadoActual = ESTADO_FAILSAFE_SIN_SENAL;
                if (!MODO_SERIAL_PLOTTER) Serial.println("[ALERTA FAILSAFE] Pérdida de señal RF detectada. Comandando pose Home segura...");
                // Fijar objetivos a la posición Home
                for (int i = 0; i < TOTAL_DEDOS; i++) {
                    posObjetivoDedos[i] = HOME_DEDOS;
                }
                posObjetivoMuniecaVert = HOME_MUNIECA_VERT;
                posObjetivoMuniecaRot  = HOME_MUNIECA_ROT;
                tiempoEnHomeMs = millis();
            }
        }

        // 3. GENERADOR DE TRAYECTORIA: SLEW-RATE LIMITING + DEADBAND
        // Control cinemático de los 5 dedos (SG90)
        bool todosEnReposo = true;

        for (int i = 0; i < TOTAL_DEDOS; i++) {
            float error = posObjetivoDedos[i] - posActualDedos[i];

            if (fabs(error) > DEADBAND_DEDOS) {
                todosEnReposo = false;
                float incremento = constrain(error, -VEL_MAX_DEDOS, VEL_MAX_DEDOS);
                posActualDedos[i] += incremento;
                if (servosAcoplados) {
                    servoDedos[i].write(anguloServoDedo(i, posActualDedos[i]));
                }
            }
        }

        // Control cinemático Muñeca Vertical (MG946R)
        float errorVert = posObjetivoMuniecaVert - posActualMuniecaVert;
        if (fabs(errorVert) > DEADBAND_MUNIECA) {
            todosEnReposo = false;
            float incrementoVert = constrain(errorVert, -VEL_MAX_MUNIECA_VERT, VEL_MAX_MUNIECA_VERT);
            posActualMuniecaVert += incrementoVert;
            if (servosAcoplados) {
                servoMuniecaVert.write((int)round(posActualMuniecaVert));
            }
        }

        // Control cinemático Muñeca Rotacional (MG946R)
        float errorRot = posObjetivoMuniecaRot - posActualMuniecaRot;
        if (fabs(errorRot) > DEADBAND_MUNIECA) {
            todosEnReposo = false;
            float incrementoRot = constrain(errorRot, -VEL_MAX_MUNIECA_ROT, VEL_MAX_MUNIECA_ROT);
            posActualMuniecaRot += incrementoRot;
            if (servosAcoplados) {
                servoMuniecaRot.write((int)round(posActualMuniecaRot));
            }
        }

        // 4. GESTIÓN DE DESACOPLE EN FAILSAFE SOSTENIDO
        // Si el sistema está en Failsafe y ya alcanzó la posición Home, tras 2 segundos se desacoplan los servos
        if (estadoActual == ESTADO_FAILSAFE_SIN_SENAL && todosEnReposo && servosAcoplados) {
            if (millis() - tiempoEnHomeMs > 2000) {
                desacoplarServos();
            }
        }

        // 5. TELEMETRÍA SERIAL NO BLOQUEANTE (5 Hz)
        if (++ticksTelemetria >= 10) {
            ticksTelemetria = 0;
            if (!MODO_SERIAL_PLOTTER) {
                const char* strEstado = (estadoActual == ESTADO_OPERACION_NORMAL) ? "OK" :
                                        (estadoActual == ESTADO_FAILSAFE_SIN_SENAL) ? "FAILSAFE" : "SYNC_WAIT";
                // [LATENCIA] Pulsos vistos en el GPIO 4: si no aumentan (~50/s), el puente desde el GPIO 26 no llega
                Serial.printf("[RX %s] D1:%.1f D2:%.1f D3:%.1f D4:%.1f D5:%.1f | Mñc:[V:%.1f, R:%.1f] | GPIO%d: %u pulsos, %u us\n",
                              strEstado,
                              posActualDedos[0], posActualDedos[1], posActualDedos[2],
                              posActualDedos[3], posActualDedos[4],
                              posActualMuniecaVert, posActualMuniecaRot,
                              PIN_CAPTURA_PWM, contadorPulsos, anchoPulsoUs);
            }
        }
    }
}

// ==========================================
// [LATENCIA] ENSAYOS DE ESCALÓN
// ==========================================
// Corre en loop() (prioridad 1, núcleo 1), por debajo de la tarea de control. Los instantes
// los toman la ISR y el callback, así que una demora de loop() no cambia los resultados.
enum EstadoEnsayo { ENSAYO_ESPERA, ENSAYO_MIDIENDO };

EstadoEnsayo estadoEnsayo = ENSAYO_ESPERA;
bool     pausado = false;
bool     nivelEstimulo = false;
uint32_t numeroEnsayo = 0;
uint32_t esperaHastaMs = 0;
uint32_t t0Us = 0, t0Ms = 0;

// Seguimiento de los pulsos
uint32_t pulsosVistos = 0;
uint32_t anchoAnterior = 0;
int      pulsosIguales = 0;
uint32_t inicioIgualesUs = 0;

// Datos del ensayo en curso
uint32_t anchoBase = 0;
bool     primerVisto = false;
uint32_t primerUs = 0;
uint32_t perdidosEnsayo = 0;

// Variables para el cálculo de la media de 15 muestras (Serial Plotter)
uint32_t bufferLatenciaUs[MUESTRAS_PROMEDIO] = {0};
int      contadorMuestrasBloque = 0;
uint64_t sumaMuestrasUs = 0;
int      indiceBuffer = 0;
bool     bufferLleno = false;

// Resumen
uint32_t muestrasPrimer[MAX_MUESTRAS];
uint32_t cantMuestras = 0, cantTimeouts = 0;

int compararU32(const void* a, const void* b) {
    uint32_t x = *(const uint32_t*)a, y = *(const uint32_t*)b;
    return (x > y) - (x < y);
}

void imprimirResumen() {
    if (cantMuestras == 0) {
        Serial.printf("[RESUMEN] Sin ensayos válidos (timeouts: %u)\n", cantTimeouts);
        return;
    }
    static uint32_t orden[MAX_MUESTRAS];
    memcpy(orden, muestrasPrimer, cantMuestras * sizeof(uint32_t));
    qsort(orden, cantMuestras, sizeof(uint32_t), compararU32);
    uint64_t suma = 0;
    for (uint32_t i = 0; i < cantMuestras; i++) suma += orden[i];
    Serial.printf("[RESUMEN] n=%u timeouts=%u | punta a punta (ms): media %.2f, min %.2f, "
                  "mediana %.2f, p95 %.2f, max %.2f\n",
                  cantMuestras, cantTimeouts, suma / 1000.0 / cantMuestras,
                  orden[0] / 1000.0, orden[cantMuestras / 2] / 1000.0,
                  orden[(cantMuestras * 95) / 100] / 1000.0, orden[cantMuestras - 1] / 1000.0);
}

void terminarEnsayo() {
    portENTER_CRITICAL(&muxLatencia);
    ensayoArmado = false;
    portEXIT_CRITICAL(&muxLatencia);
    estadoEnsayo = ENSAYO_ESPERA;
    esperaHastaMs = millis() + ESPERA_MIN_MS + esp_random() % (ESPERA_MAX_MS - ESPERA_MIN_MS);
}

// ==========================================
// [LITTLEFS] GESTIÓN DE ARCHIVO DE MEDICIONES EN FLASH
// ==========================================
const char* RUTA_ARCHIVO_TXT = "/mediciones.txt";

void guardarMedicionEnArchivo(float valorMs) {
    File f = LittleFS.open(RUTA_ARCHIVO_TXT, FILE_APPEND);
    if (f) {
        f.printf("%.2f\n", valorMs);
        f.close();
    }
}

void volcarArchivoMediciones() {
    Serial.println("\n========== INICIO MEDICIONES.TXT ==========");
    File f = LittleFS.open(RUTA_ARCHIVO_TXT, FILE_READ);
    if (!f || f.size() == 0) {
        Serial.println("(El archivo está vacío o aún no contiene mediciones)");
    } else {
        while (f.available()) {
            Serial.write(f.read());
        }
        f.close();
    }
    Serial.println("=========== FIN MEDICIONES.TXT ===========\n");
}

void borrarArchivoMediciones() {
    if (LittleFS.remove(RUTA_ARCHIVO_TXT)) {
        Serial.println("\n[LittleFS] Archivo /mediciones.txt borrado correctamente.\n");
    } else {
        Serial.println("\n[LittleFS] No se pudo borrar (el archivo quizás no existía).\n");
    }
}

void loop() {
    if (Serial.available() > 0) {
        char cmd = Serial.read();
        if (cmd == 's' || cmd == 'S') {
            if (!MODO_SERIAL_PLOTTER) imprimirResumen();
        }
        if (cmd == 'r' || cmd == 'R') { 
            cantMuestras = 0; 
            cantTimeouts = 0; 
            sumaMuestrasUs = 0; 
            contadorMuestrasBloque = 0; 
            indiceBuffer = 0; 
            bufferLleno = false;
            if (!MODO_SERIAL_PLOTTER) Serial.println("[RESUMEN] Borrado"); 
        }
        if (cmd == 'p' || cmd == 'P') { 
            pausado = !pausado; 
            if (!MODO_SERIAL_PLOTTER) Serial.println(pausado ? "[LATENCIA] Pausa" : "[LATENCIA] Sigue"); 
        }
        // Comando 'd': Descargar/Mostrar todo el contenido de mediciones.txt en el Monitor Serie
        if (cmd == 'd' || cmd == 'D') { 
            volcarArchivoMediciones();
        }
        // Comando 'b': Borrar mediciones.txt para iniciar un nuevo ensayo limpio
        if (cmd == 'b' || cmd == 'B') { 
            borrarArchivoMediciones();
        }
    }

    // Copia atómica de lo que dejaron la ISR y el callback
    portENTER_CRITICAL(&muxLatencia);
    uint32_t cont = contadorPulsos, ancho = anchoPulsoUs, fin = finPulsoUs;
    bool llego = llegoEscalon;
    uint32_t llegada = llegadaUs;
    uint8_t seq = secuenciaLlegada;
    portEXIT_CRITICAL(&muxLatencia);

    // Un pulso nuevo cada 20 ms; loop() mira cada 1 ms. Si se salteó alguno, se anota.
    if (cont != pulsosVistos) {
        if (estadoEnsayo == ENSAYO_MIDIENDO && cont - pulsosVistos > 1) perdidosEnsayo += cont - pulsosVistos - 1;
        pulsosVistos = cont;

        uint32_t dif = (ancho > anchoAnterior) ? ancho - anchoAnterior : anchoAnterior - ancho;
        if (dif <= UMBRAL_QUIETO_US) {
            pulsosIguales++;
        } else {
            pulsosIguales = 1;
            inicioIgualesUs = fin;
        }
        anchoAnterior = ancho;

        if (estadoEnsayo == ENSAYO_MIDIENDO && (int32_t)(fin - t0Us) > 0) {
            uint32_t difBase = (ancho > anchoBase) ? ancho - anchoBase : anchoBase - ancho;
            if (!primerVisto && difBase > UMBRAL_CAMBIO_US) {
                primerVisto = true;
                primerUs = fin - t0Us;
            }
            if (primerVisto && pulsosIguales >= PULSOS_QUIETO && (int32_t)(inicioIgualesUs - t0Us) > 0) {
                uint32_t finalUs = inicioIgualesUs - t0Us;

                if (!MODO_SERIAL_PLOTTER) {
                    Serial.printf("L,%u,%d,%u,%lu,%lu,%lu,%u\n", numeroEnsayo, nivelEstimulo ? 1 : 0, seq,
                                  llego ? (unsigned long)(llegada - t0Us) : 0UL,
                                  (unsigned long)primerUs, (unsigned long)finalUs, perdidosEnsayo);
                    guardarMedicionEnArchivo((float)primerUs / 1000.0f);
                } else {
                    if (!USAR_MEDIA_MOVIL) {
                        // Promedio por bloques de muestras
                        sumaMuestrasUs += primerUs;
                        contadorMuestrasBloque++;
                        if (contadorMuestrasBloque >= MUESTRAS_PROMEDIO) {
                            float mediaMs = (float)sumaMuestrasUs / (contadorMuestrasBloque * 1000.0f);
                            Serial.printf("Latencia_Media_ms:%.2f\n", mediaMs);
                            guardarMedicionEnArchivo(mediaMs); // Guardar en Flash (/mediciones.txt)
                            sumaMuestrasUs = 0;
                            contadorMuestrasBloque = 0;
                        }
                    } else {
                        // Promedio móvil deslizante (últimas muestras)
                        if (bufferLleno) {
                            sumaMuestrasUs -= bufferLatenciaUs[indiceBuffer];
                        }
                        bufferLatenciaUs[indiceBuffer] = primerUs;
                        sumaMuestrasUs += primerUs;
                        indiceBuffer = (indiceBuffer + 1) % MUESTRAS_PROMEDIO;
                        if (indiceBuffer == 0) bufferLleno = true;

                        if (bufferLleno) {
                            float mediaMs = (float)sumaMuestrasUs / (MUESTRAS_PROMEDIO * 1000.0f);
                            Serial.printf("Latencia_Media_ms:%.2f\n", mediaMs);
                            guardarMedicionEnArchivo(mediaMs); // Guardar en Flash (/mediciones.txt)
                        }
                    }
                }

                if (cantMuestras < MAX_MUESTRAS) muestrasPrimer[cantMuestras++] = primerUs;
                terminarEnsayo();
            }
        }
    }

    if (estadoEnsayo == ENSAYO_MIDIENDO && millis() - t0Ms > TIMEOUT_ENSAYO_MS) {
        if (!MODO_SERIAL_PLOTTER) {
            Serial.printf("T,%u,%d,%d\n", numeroEnsayo, nivelEstimulo ? 1 : 0, !llego ? 0 : (!primerVisto ? 1 : 2));
        }
        cantTimeouts++;
        terminarEnsayo();
    }

    // Arrancar un ensayo: enlace activo, servo quieto y espera aleatoria cumplida
    bool pulsosRecientes = (micros() - fin) < 50000;
    if (estadoEnsayo == ENSAYO_ESPERA && !pausado && estadoActual == ESTADO_OPERACION_NORMAL &&
        servosAcoplados && pulsosRecientes && pulsosIguales >= PULSOS_QUIETO &&
        (int32_t)(millis() - esperaHastaMs) >= 0) {
        anchoBase = ancho;
        primerVisto = false;
        perdidosEnsayo = 0;
        numeroEnsayo++;
        nivelEstimulo = !nivelEstimulo;

        portENTER_CRITICAL(&muxLatencia);
        valorDedoAntes = ultimoValorDedo;
        llegoEscalon = false;
        ensayoArmado = true;
        portEXIT_CRITICAL(&muxLatencia);

        t0Ms = millis();
        t0Us = micros();
        digitalWrite(PIN_ESTIMULO, nivelEstimulo ? HIGH : LOW);
        estadoEnsayo = ENSAYO_MIDIENDO;
    }

    vTaskDelay(1);
}
