sevastianamoroso/proyecto-mano/(commit log)

2026-10-02 fix: absolute wrist angles with complementary filter
    - Replace Kalman with complementary filter (alpha 0.98) over accelerometer
    absolute angles; fix inverted pitch gyro sign and uninitialized rawRoll
    (double Kalman update near pitch singularity).
    - Calibrate gyro bias at rest on startup and seed filter with accel angles.
    - Saturated, float, one-to-one mapping to wrist servos with trim constants.
    - Receiver: clamp incoming targets to mechanical limits.
    [Receptor.ino, Transmisor.ino]
2026-10-02 feat: initial firmware with Kalman wrist fusion
    Original transmitter/receiver firmware, protocol, wiring diagrams and docs.
2026-10-05 fix: receptor más rápido y dedos con sentido configurable
    - Slew-rate: dedos 3->8°/ciclo, muñeca vertical 1.5->4, rotación 2->5
    - INVERTIR_DEDO[5]: espeja el ángulo del servo dentro de 25..90° por dedo
    - WiFi.setSleep(false) en el receptor para evitar latencia en ESP-NOW
    [Receptor.ino]
2026-10-05 perf: menor latencia en recepción e IMU (v2.2.0)
    - Receptor: la tarea de control despierta al llegar el paquete
    (xQueueReceive con timeout de 20 ms) en vez de sondear a 50 Hz
    - Transmisor: DLPF del MPU6050 21 -> 44 Hz (~8.5 -> ~4.9 ms de retardo)
    - README: tabla de versiones v2.1.0 y v2.2.0
2026-10-06 feat: pausar envío y telemetría durante la calibración (v2.3.0)
    - Bandera `calibrando`: mientras corre la calibración con 'c' la tarea no
    lee dedos, no transmite y no imprime; el receptor pasa a failsafe y se
    recupera solo al terminar
    - El IMU se lee antes del corte para no perder el estado del filtro
    [Transmisor.ino]
2026-10-06 docs: explicación detallada del firmware y diagramas de funcionamiento
    - EXPLICACION_CODIGO.md reescrito para v2.3.0: módulo por módulo, origen
    de cada técnica, guía de ajuste y evolución desde la v1.0.0 (Kalman)
    - docs/DIAGRAMAS.md: funcionamiento en diagramas Mermaid
    - README: estado de versiones (v2.2.0 validada, v2.3.0 a validar)
2026-10-12 docs: informe final en LaTeX (plantilla MSNIE DIEC UNS)
    - Proyecto Overleaf en informe/, dividido en capítulos y actualizado al
    firmware v2.3.0: arquitectura, protocolo, transmisor (filtro
    complementario), receptor (cola, failsafe, slew-rate), evolución de
    versiones, análisis temporal y bibliografía IEEE.
    - Lo que falta completar queda marcado con \pendiente{} (rojo en el PDF).
    - Borrador del plan de la presentación para la defensa.
2026-10-14 docs: consumos del receptor con hojas de datos citadas
2026-10-14 docs: borrador del diagrama tipo clases del firmware (pendiente de anexar)
2026-10-15 docs: alimentación final del receptor (MP1584, 470 µF + 100 nF, ESP32 por USB)
2026-10-15 docs: diagrama del receptor e informe con la alimentación final (MP1584, 470 µF + 100 nF, ESP32 por USB con pin 5V removido)
2026-10-15 docs: diagramas de conexionado en el informe, guante alimentado por USB de la PC y retardo Tx-Rx pendiente de validar
2026-10-15 docs: dedal del pulgar, tubos de resorte y palanca del guante
2026-10-18 docs: respuesta del sistema con MATLAB, consumo medido y capacitores de entrada del regulador
    - Pruebas (cap. 8): firmware preliminar como antecedente, respuesta guante-mano
    con la v2.3.0 (telemetría alineada por secuencia) y alimentación del receptor
    medida con osciloscopio.
    - Receptor: dos pares 470 µF + 100 nF (entrada y salida del MP1584) en el
    informe y en el diagrama de conexionado.
    - Guante: imagen de la palanca del potenciómetro.
    - Pausa de calibración de la v2.3.0 validada; v2.3.0 como versión definitiva.
    - Borrador de conclusiones.
2026-10-18 docs: estructura del firmware como apéndice B y pendientes como próximos pasos
    - Apéndice B: diagramas tipo clases del firmware (vista general, transmisor y
    receptor) con cajas y flechas reordenadas para evitar cruces; referencia
    desde la arquitectura.
    - Latencia, deriva de la muñeca y conclusiones: pendientes redactados como
    siguientes pasos.
    - Trabajo futuro reducido a medir la latencia, subir frecuencias y evaluar los
    servos, e investigar otras mejoras.
    - Se quita el pendiente de las subfiguras del receptor.
2026-10-21 docs: diapositivas de la defensa en Beamer con resultados de la v2.3.0
    Estructura según PLAN_DEFENSA.md: arquitectura, guante, mano, firmware,
    evolución, latencia estimada, respuesta del sistema (P16), consumo medido
    (P02/P03) y diapositivas de respaldo para preguntas del jurado. Quedan en
    rojo la latencia medida, la deriva de la muñeca y el video de la demo.
2026-10-21 docs: ajustes de diagramación en las diapositivas del guante y del consumo
2026-10-21 docs: fecha de la defensa en la portada
2026-10-26 fix: servo del anular en GPIO 23
    En el GPIO 12 (strapping) el dedo se movía con dificultad; en el GPIO 23 respondió bien. Se actualizan firmware, diagrama, informe, documentación y registro de pruebas.
2026-10-26 docs: guía de estudio para la defensa
    FreeRTOS, ESP-NOW y el código parte por parte, con preguntas de práctica.
2026-10-26 feat: prueba de latencia de punta a punta (método v2)
    Mismo contenido que la rama exp/latencia-v2: receptor de latencia, guía de la prueba, script de MATLAB y método v1 archivado.
2026-10-26 docs: presentación con tema oscuro y contenido nuevo
    Motivación visual, recorrido de un dato entre núcleos, dos diapositivas del IMU, cola del receptor, MP1584, pines de la prueba de latencia corregidos; se quitan Kalman vs complementario y trabajo futuro.
2026-10-26 docs: lista de pendientes y capturas nuevas del Serial Plotter
    Las capturas Respuesta_*.jpeg todavía no se usan en el informe (ver PENDIENTES.md).
2026-10-26 docs: IMU, colas y núcleos en el informe
2026-10-26 docs: decisión sobre el Kalman en pendientes
2026-10-26 docs: evolución de versiones resumida y Kalman en el apéndice C
2026-10-26 docs: la v2.3.0 también figura como validada en hardware
2026-10-26 docs: corte de P03 y salida de 5 V explicados; datos de Espressif verificados
2026-10-26 docs: diapositiva de latencia con el método v2 y ajustes visuales
2026-10-26 test: diagnóstico de pulsos en el GPIO 4 en la telemetría de la prueba de latencia
2026-10-26 test: modo Serial Plotter en la prueba de latencia (comando g)
2026-10-26 docs: diagrama del receptor exportado de nuevo desde el drawio (anular en GPIO 23)
2026-10-26 docs: OnDataSent también sin ACK; cap. 7 con el limitador y el método de latencia v2
2026-10-26 test: resultados de latencia de punta a punta (P11) y su evidencia
2026-10-26 docs: latencia medida (P11, media ≈ 24 ms) en el informe y la presentación
2026-10-26 docs: salida de 5 V con el valor eficaz; deriva de la muñeca pasa a trabajo futuro
2026-10-26 docs: figuras de señales más legibles (trazas engrosadas, leyendas sin entradas vacías, unidades en los ejes)
2026-10-26 docs: failsafe al apagar el guante verificado en hardware (P10)
2026-10-26 chore: limpieza para la entrega: se quitan archivos viejos y sin uso
    Kalman v1 (queda en el tag v1.0.0), plan de mejoras previo a la v2, borradores,
    informe preliminar, método de latencia v1, capturas e imágenes sin usar.
    Las referencias a las ramas exp/* pasan al tag pruebas-2026-10-15.
2026-10-27 docs: nuevo título, apéndice con el repositorio y trabajo futuro planteado como continuación
2026-10-27 docs(firmware): comentarios del código reescritos en un tono más natural (sin cambios en el código)
2026-10-27 docs(aprendizaje): 60 preguntas y respuestas para la defensa
    Nuevo 04_PREGUNTAS_DEFENSA.md: proyecto, hardware y alimentación, sensores,
    tiempo real, limitaciones conocidas, conocimiento complementario y la demo.
    Las respuestas de latencia de 02 y 03 pasan a los 24 ms medidos en P11.
2026-10-27 chore(cad): se suben los modelos 3D de Solid Edge y sus exportaciones .3mf
2026-10-28 docs: diapositivas nuevas del MPU6050, guion de la presentación y corrección del revisor en pendientes
    - Presentación: "Orientación a partir de la gravedad" (fig. 9 del informe) y "Deriva del giróscopo
    y ruido del acelerómetro".
    - Guion para practicar la defensa (informe/presentacion/GUION_PRESENTACION.md).
    - Análisis de la corrección del revisor (filtro complementario y latencia) en
    docs/CORRECCIONES_REVISOR.md; el informe todavía no se modificó.
    - PENDIENTES.md actualizado con lo que falta revisar.
2026-10-28 docs: correcciones del revisor (filtro complementario y latencia) y ajustes de la presentación
    - Cap. 4: el filtro complementario se explica con sus dos lecturas (pasa-bajos con la
    ecuación tal como está escrita; pasa-altos respecto del ángulo integrado del giróscopo)
    y el error fijo τ·b que deja un bias residual.
    - Cap. 7: la medición de latencia se reorganiza en qué se mide, montaje (figura nueva),
    criterios, resultados por corrida y reparto en tramos (el tramo del receptor es casi
    constante: la fase entre placas queda fija en cada corrida) y limitaciones.
    - Presentación: diapositiva del filtro corregida; demo sólo en vivo (sin video); esquema
    del acelerómetro sin las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
2026-10-28 docs(presentacion): reparto de oradores en el guion (ideas intercaladas, ~14 min cada uno)
